pav2000/ControlHeatPump/Hardware/README.md

# ControlHeatPump
Файлы которые надо заменить в стандартном SDK Due (смотрите путь к файлам начиная с hardware)<br>
Библиотека DUE SAM: https://github.com/arduino/ArduinoCore-sam
