pav2000/ControlHeatPump/WiFiSensor/data/README.md

# WiFi Sensor
Веб морда датчика. Необходимо загрузить на флеш диск через среду IDE
