pav2000/ControlHeatPump/WiFiSensor/Screen/README.md

# WiFi Sensor
Картинки показывающие работу и вариант сборки сенсора.
