pav2000/ControlHeatPump/Schemes/Control  ПЭ3.pdf

Изм. | Спра | № докум. | Подп. | Дата
| | Разраб. | Куцко | | Контроллер ТН Перечень элементов | Лит. | Лист | Листов
Пров. | Куцко | | | | | | 1 | 5

Н.контр.
Утв.
Копировал | Формат А4

Инв. № подл. Подп. и дата Взам. инв. № Инв. № дубл. Подп. и дата Справ. № Перв. примен. 0000.00.00.000

Поз.
обозначение
Наименование | Кол. | Примечание
BA1 | Спикер Beep Small 9x5.5mm 3V | 1
| Конденсаторы
C1,C2 | CASE-D-25V-220 мкФ±10% | 2
C3 | 0805-X7R-50V-0,1 мкФ±10% | 1
C4 | 0805-X7R-50V-0,01 мкФ±10% | 1
C5 | CASE-D-25V-220 мкФ±10% | 1
C6...C11 | 0805-X7R-50V-0,01 мкФ±10% | 6
C12...C16 | CASE-D-25V-220 мкФ±10% | 5
C17 | 0805-X7R-16V-1 мкФ±10% | 1
C18 | CASE-D-25V-220 мкФ±10% | 1
C19 | 0805-X7R-50V-0,1 мкФ±10% | 1
C20 | CASE-D-25V-220 мкФ±10% | 1
C21 | 0805-X7R-50V-0,1 мкФ±10% | 1
C22 | 0805-X7R-10V-10 мкФ±10% | 1
C23,C24 | CASE-D-25V-220 мкФ±10% | 2
C25 | 0805-X7R-50V-0,1 мкФ±10% | 1
C26 | 0805-X7R-10V-10 мкФ±10% | 1
C27,C28 | 0805-X7R-16V-1 мкФ±10% | 2
C29 | 0805-X7R-50V-0,01 мкФ±10% | 1
C30 | 0805-X7R-50V-0,1 мкФ±10% | 1
C31 | 0805-X7R-50V-0,01 мкФ±10% | 1
C32 | 0805-X7R-16V-1 мкФ±10% | 1
C33...C35 | 0805-X7R-50V-0,01 мкФ±10% | 3
C36 | 0805-X7R-50V-0,1 мкФ±10% | 1
C37,C38 | 0805-X7R-50V-0,01 мкФ±10% | 2
C39 | 0805-X7R-50V-0,1 мкФ±10% | 1
C40 | 0805-X7R-50V-0,01 мкФ±10% | 1
| | | 0000.00.00.000 ПЭ3

Изм. | Лист | № докум. | Подп. | Дата

Инв

C41,C42 | 0805-X7R-50V-0,1 мкФ±10% | 2
C43 | 0805-X7R-50V-0,01 мкФ±10% | 1
C44 | 0805-X7R-50V-0,1 мкФ±10% | 1
C45...C47 | 0805-X7R-50V-0,01 мкФ±10% | 3
| Микросхемы
DA1 | Импульсный преобразователь LM2576SX-5.0 | 1
DA2 | Преобразователь P6CU-1205ELF (B1205LS) | 1
DA3...DA8 | PC817I | 6
DA9 | Преобразователь P6CU-1205ELF (B1205LS) | 1
DA10 | Преобразователь LM1117-3.3 | 1
DA11 | LM358AM | 1
DA12...DA14 PC817I | | 3
DA15,DA16 | LM358AM | 2
DA17 | DS3231MZ+ | 1
DA18,DA19 | ULN2003AD | 2
DD1 | W25Q32FVSSIG | 1
DD2 | MAX485AD | 1
DD3 | FM24C04-S | 1
L1,L2 | Дроссель SP1210-123K | 2
L3 | Дроссель MSS1210-104KEB | 1
| | | 2 . № подл. Подп. и дата Взам. инв. № Инв. № дубл. Подп. и дата
| Резисторы
R1...R12 | 0805-0,125W-1 кОм±1% | 12
R13...R20 | 0805-0,125W-4,75 кОм±1% | 8
R21 | 0805-0,125W-10 кОм±1% | 1
R22 | 0805-0,125W-9,09 кОм±1% | 1
R23 | 0805-0,125W-22,1 кОм±1% | 1
R24 | 0805-0,125W-9,09 кОм±1% | 1
R25 | 0805-0,125W-10 кОм±1% | 1
R26 | 0805-0,125W-1 кОм±1% | 1
| | | 0000.00.00.000 ПЭ3 | Лист

R27 | 0805-0,125W-22,1 кОм±1% | 1
R28 | 0805-0,125W-10 кОм±1% | 1
R29...R32 | 0805-0,125W-4,75 кОм±1% | 4
R33 | EVM3ESX50B13 | 1
R34 | 0805-0,125W-9,09 кОм±1% | 1
R35 | 0805-0,125W-1 кОм±1% | 1
R36 | 0805-0,125W-22,1 кОм±1% | 1
R37 | 0805-0,125W-121 Ом±1% | 1
R38 | 0805-0,125W-9,09 кОм±1% | 1
R39 | 0805-0,125W-10 кОм±1% | 1
R40 | EVM3ESX50B13 | 1
R41 | 0805-0,125W-1 кОм±1% | 1
R42 | 0805-0,125W-22,1 кОм±1% | 1
R43 | EVM3ESX50B13 | 1
R44 | 0805-0,125W-22,1 кОм±1% | 1
R45 | 0805-0,125W-1 кОм±1% | 1
R46 | 0805-0,125W-9,09 кОм±1% | 1
R47 | EVM3ESX50B13 | 1
R48 | 0805-0,125W-1 кОм±1% | 1
R49 | 0805-0,125W-9,09 кОм±1% | 1
R50 | 0805-0,125W-10 кОм±1% | 1
R51 | 0805-0,125W-22,1 кОм±1% | 1
R52...R54 | 0805-0,125W-10 кОм±1% | 3 | 3 . № подл. Подп. и дата Взам. инв. № Инв. № дубл. Подп. и дата
R55...R58 | 0805-0,125W-121 Ом±1% | 4
R59 | 0805-0,125W-0 Ом±1% | 1
R60 | 0805-0,125W-10 кОм±1% | 1
R61,R62 | 0805-0,125W-0 Ом±1% | 2
R63 | 0805-0,125W-2,21 кОм±1% | 1
R64 | 0805-0,125W-100 Ом±1% | 1
R65...R67 | 0805-0,125W-0 Ом±1% | 3
R68 | 0805-0,125W-100 Ом±1% | 1

SB1,SB2 | Кнопка PTS645SM43SMTR | 2
| Диоды
VD1 | SSA33L | 1
VD2...VD15 | SS12 | 14
VD16,VD17 | Светодиод 0805 | 2
VD18...VD29 | SS12 | 12
X1,X2 | Клемник KLS2-308V-2.54-02P-2C | 2
X3...X8 | Клемник KLS2-308V-2.54-03P-2C | 6
X9 | Клемник KLS2-301-500-02P-2C | 1
X10...X16 | Клемник KLS2-308V-2.54-02P-2C | 7
X17 | Клемник KLS2-308V-2.54-03P-2C | 1
X18 | Клемник KLS2-308V-2.54-02P-2C | 1
X19 | Держатель карты памяти MicroSD | 1
X20 | Клемник KLS2-308V-2.54-02P-2C | 1
X21...X23 | Клемник KLS2-308V-2.54-03P-2C | 3
X24 | Клемник KLS2-308V-2.54-02P-2C | 1
X25 | Клемник KLS2-308V-2.54-03P-2C | 1
X26 | Держатель батарейки S8401-46 | 1
X27 | Клемник KLS2-308V-2.54-02P-2C | 1
X28 | Клемник KLS2-308V-2.54-03P-2C | 1
X29 | Клемник KLS2-308V-2.54-02P-2C | 1 | 4 . № подл. Подп. и дата Взам. инв. № Инв. № дубл. Подп. и дата
X30...X36 | Клемник KLS2-308V-2.54-03P-2C | 7
X37 | Клемник KLS2-308V-2.54-02P-2C | 1
X38,X39 | Клемник KLS2-308V-2.54-03P-2C | 2
X40,X41 | Клемник KLS2-308V-2.54-02P-2C | 2
X42,X43 | Клемник KLS2-308V-2.54-03P-2C | 2
X44...X51 | Клемник KLS2-308V-2.54-02P-2C | 8
XP1 | Соединитель штыревой PLS-10 | 1
XP2...XP4 | Соединитель штыревой PLS-08 | 3

5 . № подл. Подп. и дата Взам. инв. № Инв. № дубл. Подп. и дата

XP5 | Соединитель штыревой PLS-04 | 1
XP6 | Соединитель штыревой PLS-08 | 1
XP7 | Соединитель штыревой PLS-04 | 1
XP8 | Соединитель штыревой PLS-08 | 1
XP9 | Соединитель штыревой PLS-04 | 1
XP10 | Соединитель штыревой PLD-36 | 1
XP11 | Соединитель штыревой PLS-11 | 1
XS1 | Штыревой разъем KLS1-208-2-06-S | 1
XS2 | Штыревой разъем 2.54 6pin x 2 | 1
