pav2000/ControlHeatPump/Schemes/Control_2.1_Board (Подписаны выводы).pdf

RS485_A
RS485_B

Vout6 (0-10V)
Vout6 (GND)

Vout5 (0-10V)
Vout5 (GND)

Vout4 (0-10V)
Vout4 (GND)

Vout3 (0-10V)
Vout3 (GND)

# TMP1 (+3.3V) TMP1 (DQ) TMP1 (GND)

# TMP2 (+3.3V) TMP2 (DQ) TMP2 (GND)

# TMP3 (+3.3V) TMP3 (DQ) TMP3 (GND)

# TMP4 (+3.3V) TMP4 (DQ) TMP4 (GND)

# TMP5 (+3.3V) TMP5 (DQ) TMP5 (GND)

# TMP6 (+3.3V) TMP6 (DQ) TMP6 (GND)

E

E

V1.1
E

E

V1.1
E

E

V1.1

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
+12V)
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
V1.3
E

E

V1.3

(

+12V)

E

E

V2.1
E

E

V2.1
E

E

V2.1
E

E

V2.3
E

E

V2.3
E

E

V2.2
E

E

V2.2

(

+12V)
E

E

V2.2

(

G

ND)

E

E

V2.4

(

+12V)
E

E

V2.4

LED LED LED
(

+3.3V)
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
S (R

E

SET)
B

U

T

T

O

N

S (POW

ER)

R

ELA

Y

(

+5V)
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
Y (O

U

T1)
R

ELA

Y (O

U

T2)
R

ELA

Y (O

U

T3)
R

ELA

Y (O

U

T4)
R

ELA

Y (O

U

T5)
R

ELA

Y (O

U

T6)
R

ELA

Y (O

U

T7)
R

ELA

Y (O

U

T8)
R

ELA

Y

(

+5V)

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
7 (O

U

T7)
R

ELA

Y

7

(

+5V)
R

ELA

Y

8 (O

U

T8)
R

ELA

Y

8

(

+5V)

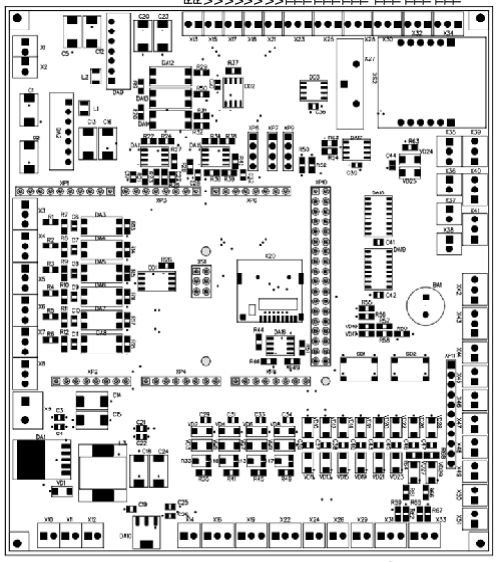
[picture p7: figure]

# PEVA (GND) PEVA (+5V, +12V) PEVA

# PCON (GND) PCON (+5V, +12V) PCON

## Vout2 (GND) Vout2 (0-10V)

## Vout1 (GND) Vout1 (0-10V)

GND

Analog_IN11

# Analog_IN10 Analog_IN7 Analog_IN6

Analog_IN5 Analog_IN4 Analog_IN3

Analog_IN2 Analog_IN1 Analog_IN0

+5V

+5V

GND

GND
GND

GND

+12V

+12V

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
S6 (In)
S6 (5VD)
S6 (0VD)

S5 (In)
S5 (5VD)
S5 (0VD)

S4 (In)
S4 (5VD)
S4 (0VD)

S3 (In)
S3 (5VD)
S3 (0VD)

S2 (In)
S2 (5VD)
S2 (0VD)

S1 (In)
S1 (5VD)
S1 (0VD)

R

ELA

Y10

(

+5V)
R

ELA

Y10 (OUT10)

R

ELA

Y

9

(

+5V)
R

ELA

Y

9 (O

U

T9)
