pav2000/ControlHeatPump/Nextion/README.md

# Nextion
В этой директории лежит все что касается дисплея Nextion. Это не обязательное оборудование!<br>
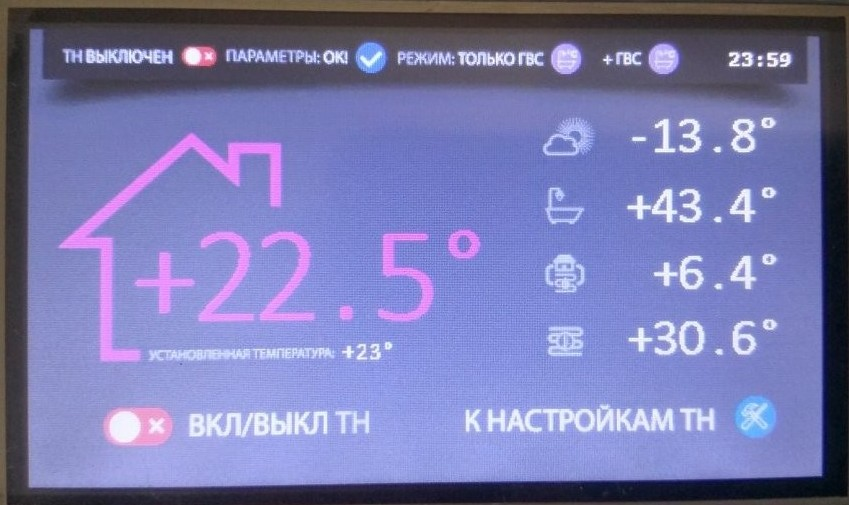
[picture p8: Nextion/Screen/00.jpg]
<br>
Автор данного устройства Sheeny.

Дисплей Nextion используется модель NX4827T043 (https://www.itead.cc/wiki/Product) с
диагональю 4.3 дюйма вот этот : https://www.itead.cc/wiki/NX4827T043 <br>
ОБЯЗАТЕЛЬНО префикс модели NX, с китайским вариантом будут проблемы с редактором.<br>
Цепляется к первому (Serial1) аппаратному порту uart DUE. (ноги D18 D19) (перекрестное соединение
TX-RX). Не смотря на 5 вольтовое питание выходные сигналы с дисплея имеют уровень 3.3 вольта и не
требуют согласования уровней.<br>

Прошивку можно залить через редактор: https://nextion.itead.cc/resources/download/nextion-editor/<br>
или с помощью micro-SD карты: файл nextion.tft нужно переписать на флешку (отформатирована в fat32),
вставить ее в разъем SD на дисплее, включить питание дисплея. Процесс обновления будет отображаться
на дисплее.

Дисплей можно присоеденить по радиоканалу см. файл Nextion+HC-12.pdf.

Файл nextion_800x480.zip - адаптация прошивки для 7 дюймового дисплей Nextion

Проекты делаются в версии Nextion Editor 0.53 не выше, в связи с высокой глючностью
последних версий редакторов.
