pav2000/ControlHeatPump/Web/README.md

# ControlHeatPump
Веб морда для контроллера, необходимо из директории "Main" все файлы записать в корень SD карты или загрузить в SPI Flash (при включенной соответствующей опции в настройках).<br>

Директории:
Main -  основная веб. морда контроллера (может сохраняться на карте и на флеш диске)
mob - вариант мобильной (для телефонов) веб. морды, устаршая версия (частичная работа)
Variant - Варианты замены отдельных файлов основной веб. морды (замена по желанию)

Настройка веб. морды
Необходимо проверить в файле scripts.js - должна быть раскоментирована строка:<br>
var urlcontrol = ''; //  автоопределение (если адрес сервера совпадает с адресом контроллера) <br>
Это вариант если морда лежит на SD карте (ОСНОВНОЙ). <br>
Если морда лежит в другом месте то urlcontrol должно указывать на адрес веб морды.<br>><br>
