pav2000/ControlHeatPump/Control/README.md

# ControlHeatPump
Контроллер  теплового насоса
