pav2000/ControlHeatPump/Web/Variant/README.md

Варианты изменений веб морды (по желанию пользователя).
Для внесений изменений надо заменить файлы в рабочей директории из этой папки.

Изменения:
invertorset.html - страница для инвертора OmronMX2 замена размерностей с % на частоту
Omron MX2.pdf - кратное описание инвертора MX2, при использовании этого инвертора необходимо УДАЛИТЬ файл Vacon.pdf и скопировать этот файл.
sensorsp.html - обновление страницы раз в 5 сек. (в main 2 сек.), вывод дополнительно для SDM Реактивной мощности (VAr) и Полной мощности (VA)
stats.html history.html style.css - оформление пунктов меню "Статистика" в общем дизайне веб интерфейса (меню, цветовая гамма)
