pav2000/ControlHeatPump/Nextion/3D_model/README.md

# Nextion
Модели для печати корпуса дисплея Nextion на 3D принтере <br>
