pav2000/ControlHeatPump/Nextion/Screen/README.md

# Nextion
Картинки показывающие работу дисплея Nextion.
