pav2000/ControlHeatPump/Nextion/3D_model/Корпус.jpg

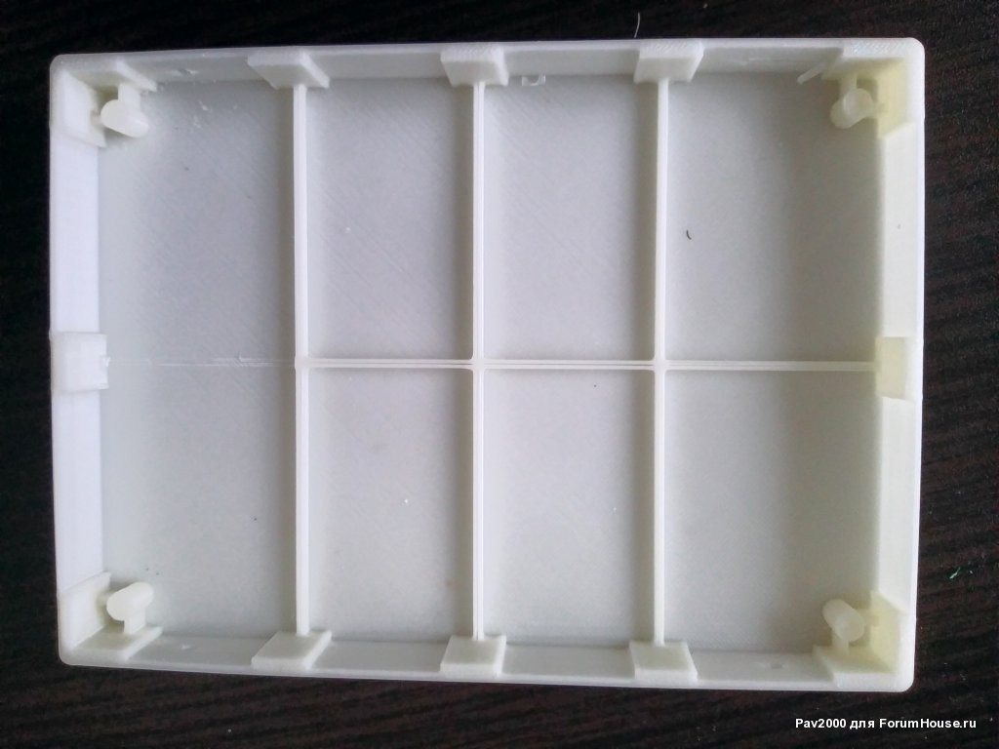
Nextion/3D_model/Корпус.jpg
