pav2000/ControlHeatPump/Nextion/3D_model/Крышка.jpg

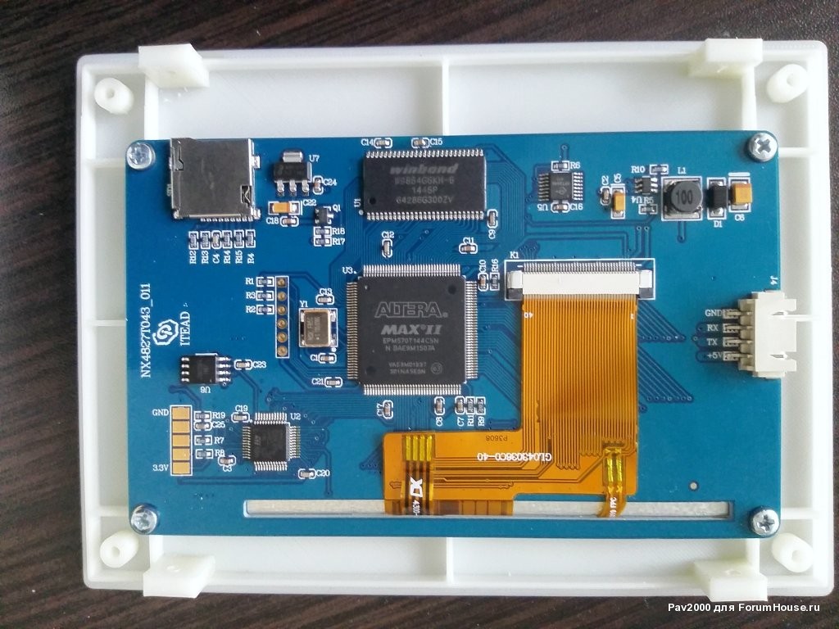
Nextion/3D_model/Крышка.jpg
