pav2000/ControlHeatPump/Nextion/3D_model/Сборка.jpg

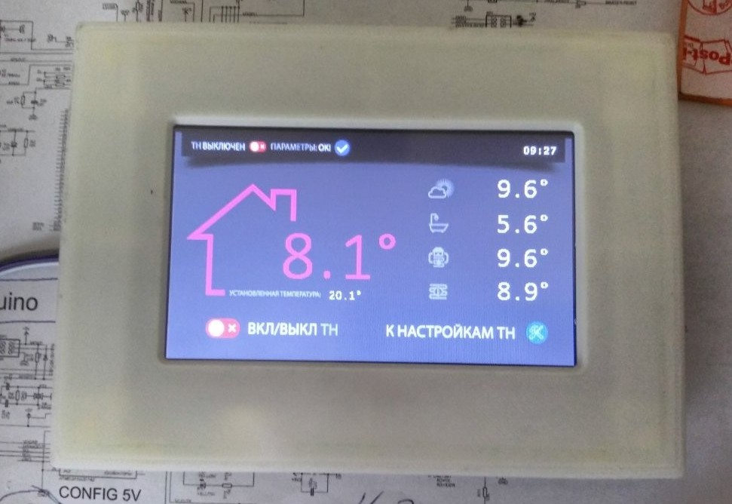
Nextion/3D_model/Сборка.jpg
