pav2000/ControlHeatPump/Nextion/Screen/01.jpg

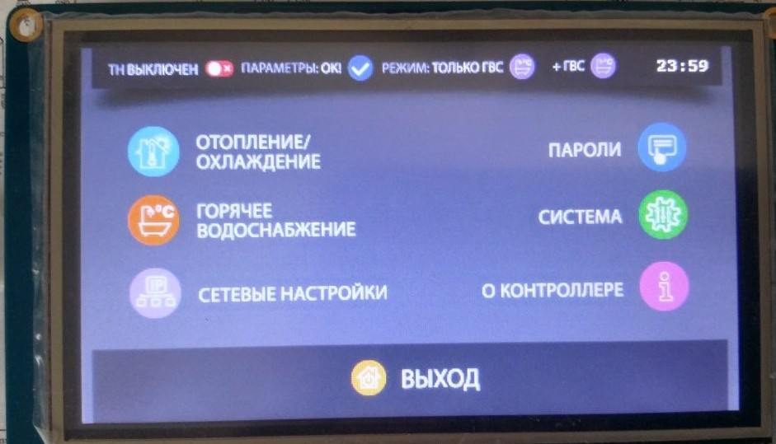
Nextion/Screen/01.jpg
