pav2000/ControlHeatPump/Nextion/Screen/02.jpg

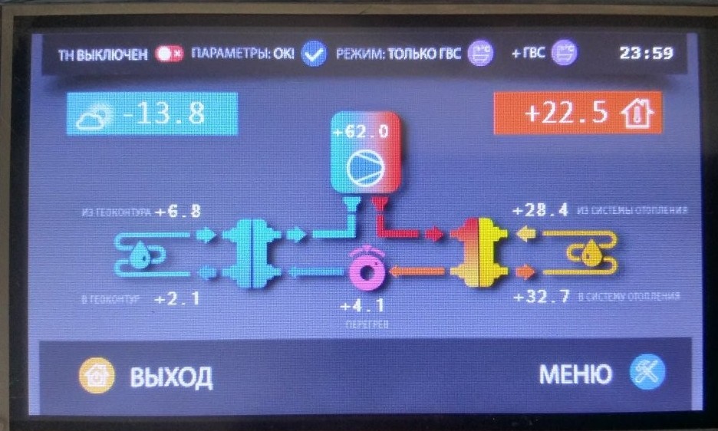
Nextion/Screen/02.jpg
