pav2000/ControlHeatPump/Nextion/Screen/03.jpg

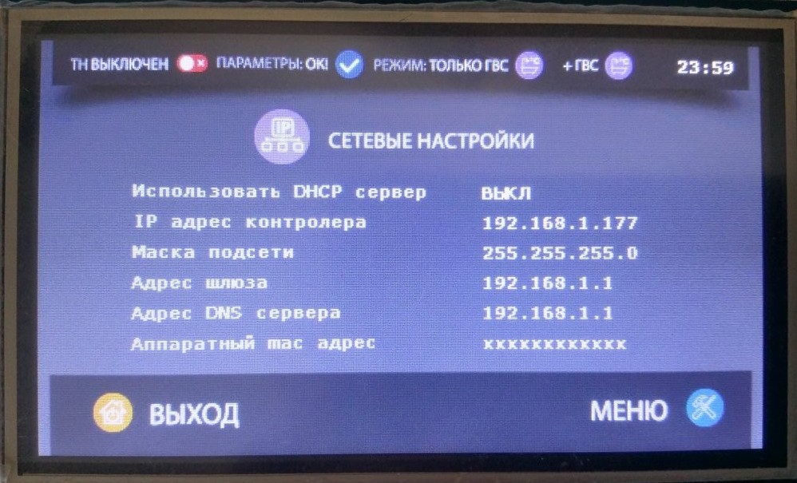
Nextion/Screen/03.jpg
