pav2000/ControlHeatPump/Nextion/Screen/04.jpg

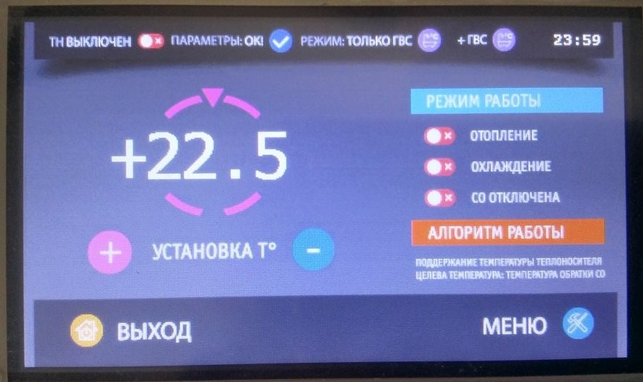
Nextion/Screen/04.jpg
