pav2000/ControlHeatPump/Nextion/Screen/05.jpg

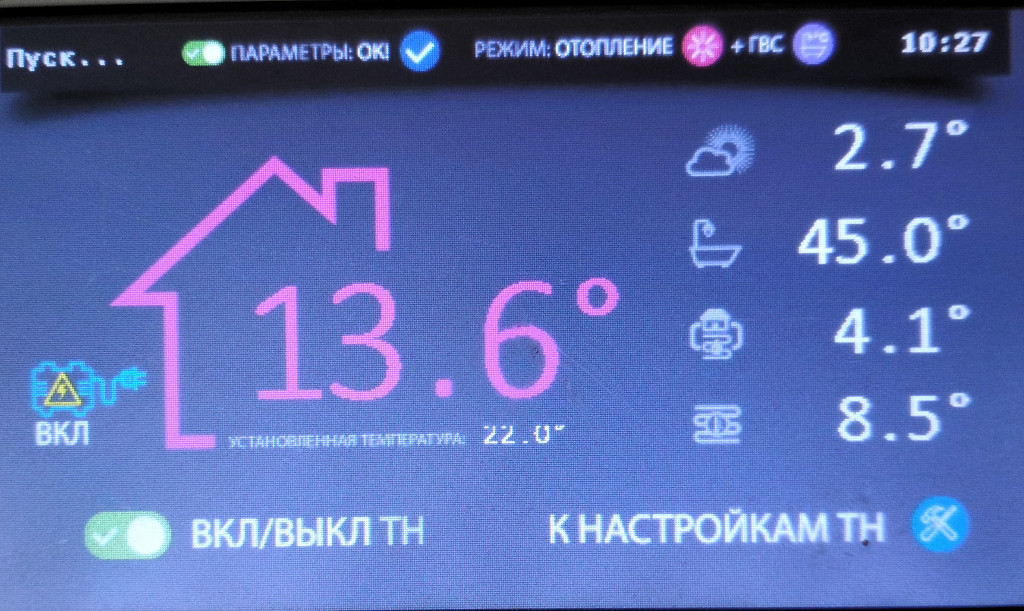
Nextion/Screen/05.jpg
