pav2000/ControlHeatPump/Schemes/Arduino DUE Core.png

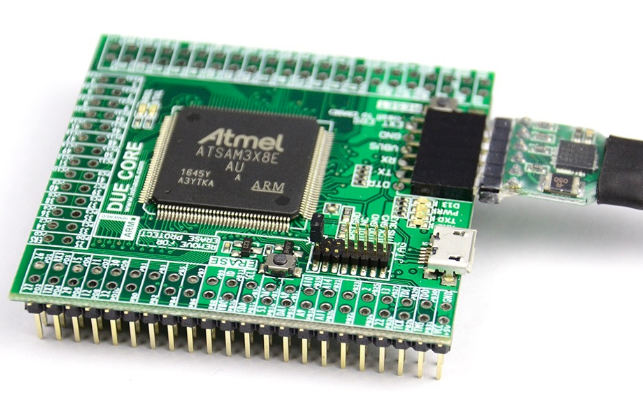
Schemes/Arduino DUE Core.png
