pav2000/ControlHeatPump/Schemes/Schematic_DUE-Core-Main-board_Main_v_1_0_top.jpg

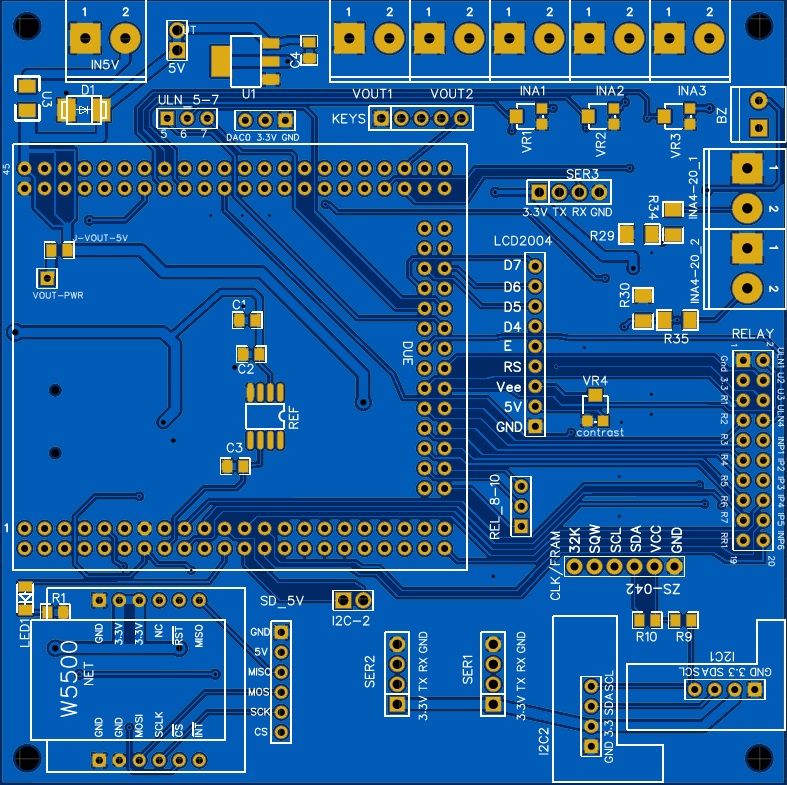
Schemes/Schematic_DUE-Core-Main-board_Main_v_1_0_top.jpg
