pav2000/ControlHeatPump/Schemes/Schematic_DUE-Core-Relay-board_Relay_v_1_0_top.jpg

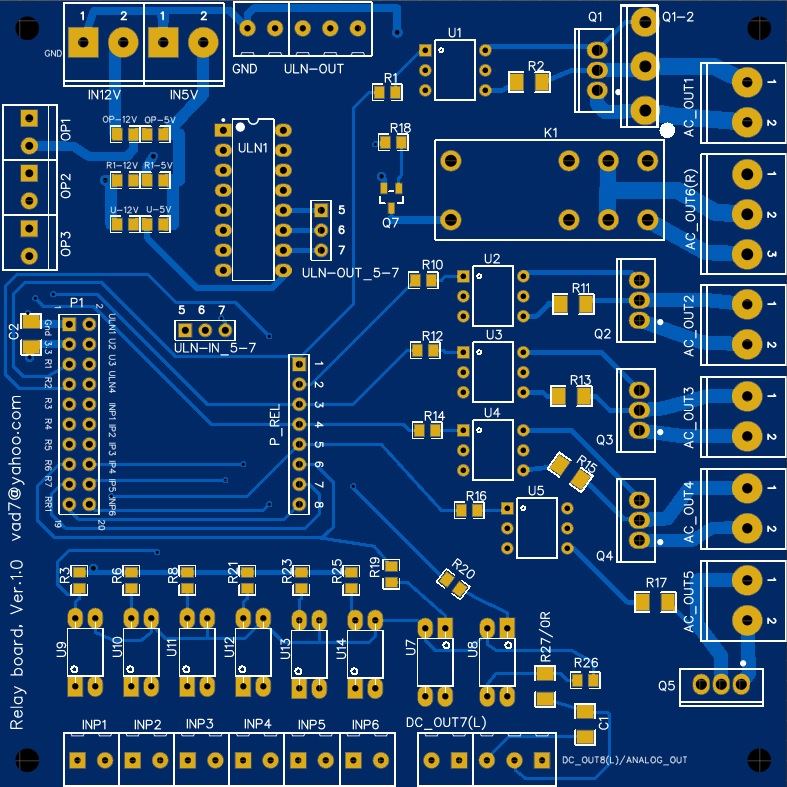
Schemes/Schematic_DUE-Core-Relay-board_Relay_v_1_0_top.jpg
