pav2000/ControlHeatPump/Schemes/UART - K-Line adapter.jpg

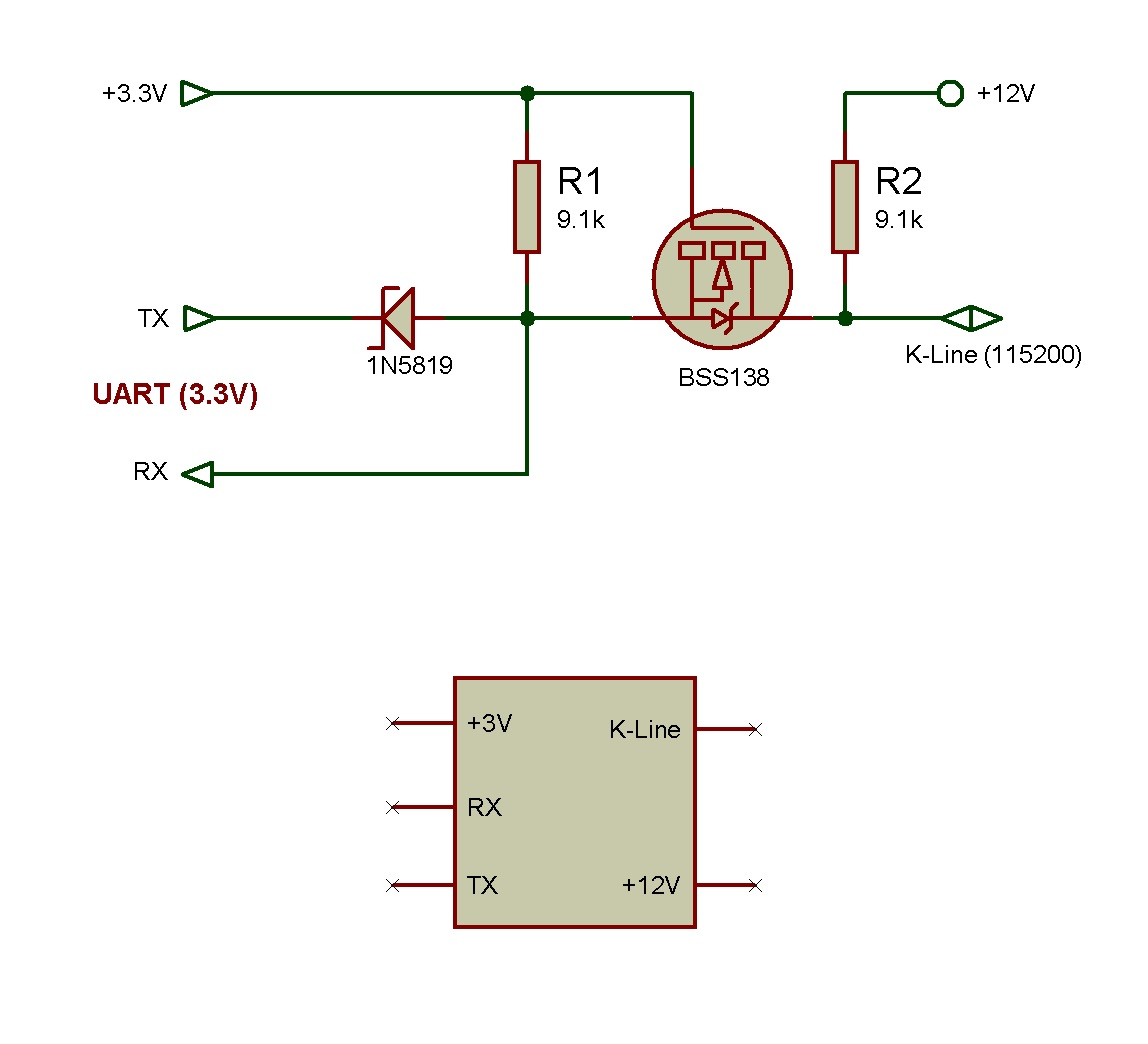
Schemes/UART - K-Line adapter.jpg
