pav2000/ControlHeatPump/Web/Main/plan1.png

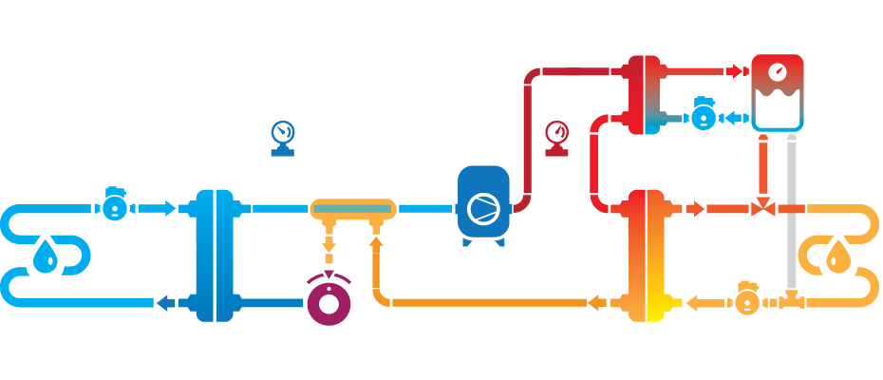
Web/Main/plan1.png
