pav2000/ControlHeatPump/Web/Main/plan2.png

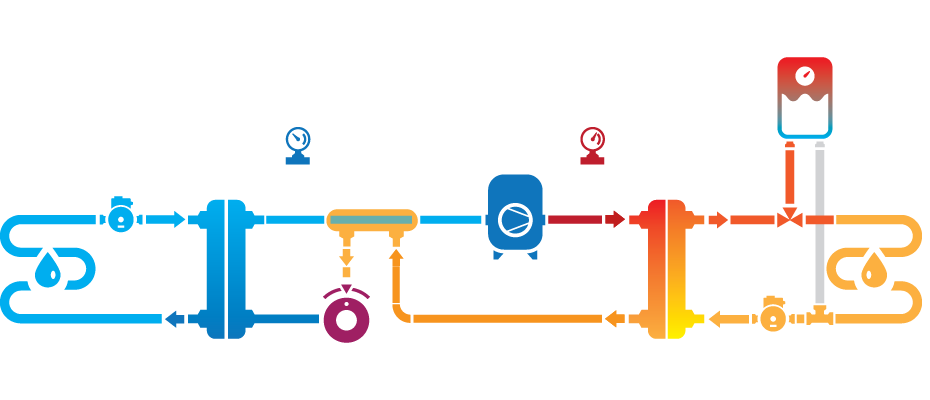
Web/Main/plan2.png
