pav2000/ControlHeatPump/Web/Main/plan3.png

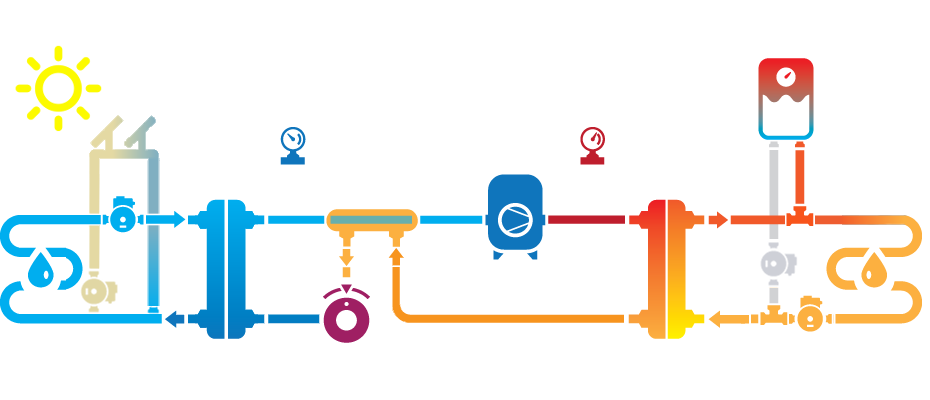
Web/Main/plan3.png
