pav2000/ControlHeatPump/Web/mob/shem1.png

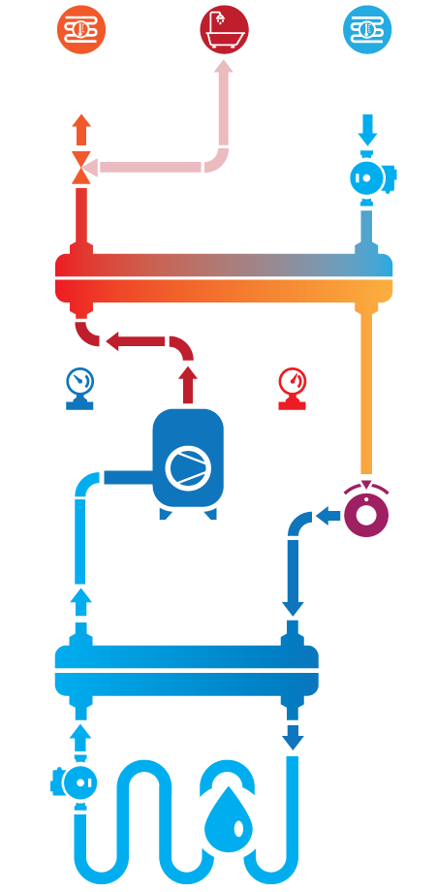
Web/mob/shem1.png
