pav2000/ControlHeatPump/WiFiSensor/Screen/02.jpg

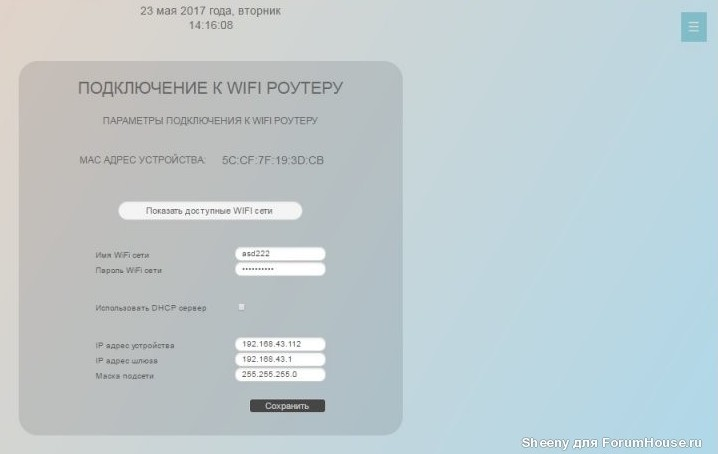
WiFiSensor/Screen/02.jpg
