pav2000/ControlHeatPump/WiFiSensor/Screen/03.jpg

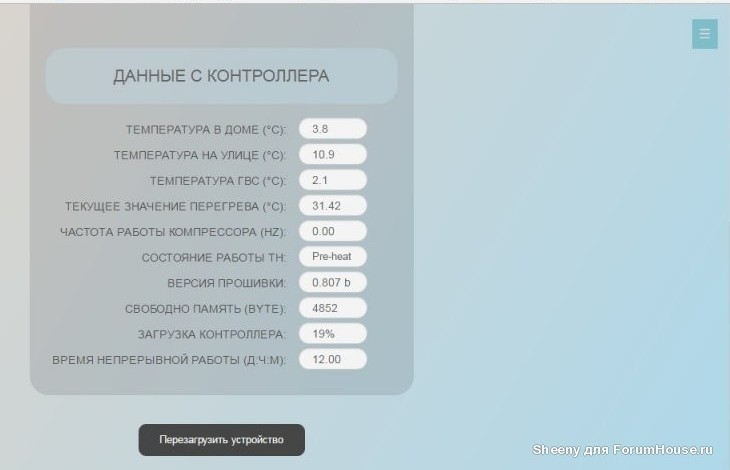
WiFiSensor/Screen/03.jpg
