pav2000/ControlHeatPump/WiFiSensor/Screen/04.jpg

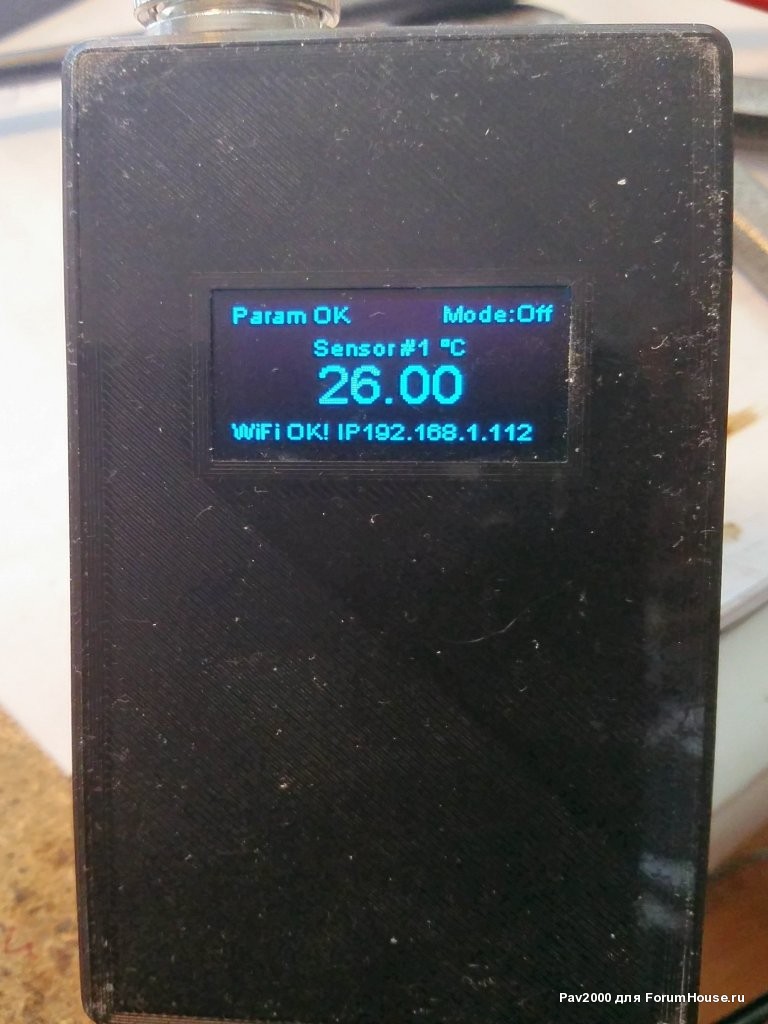
WiFiSensor/Screen/04.jpg
