pav2000/ControlHeatPump/WiFiSensor/Screen/05.jpg

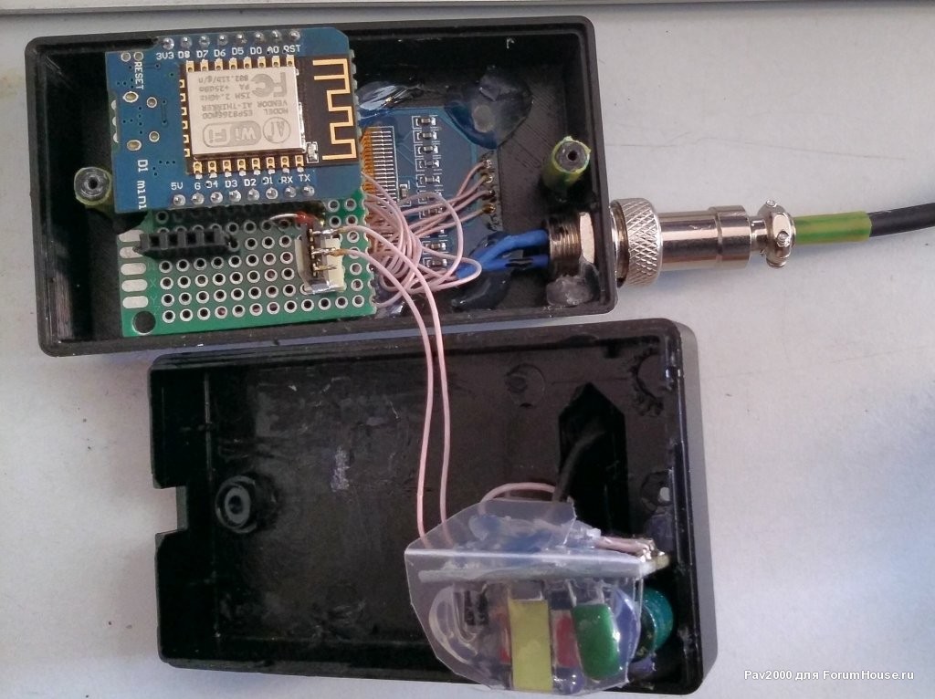
WiFiSensor/Screen/05.jpg
