pav2000/ControlHeatPump/Nextion/3D_model/4.3-Bezel.STL

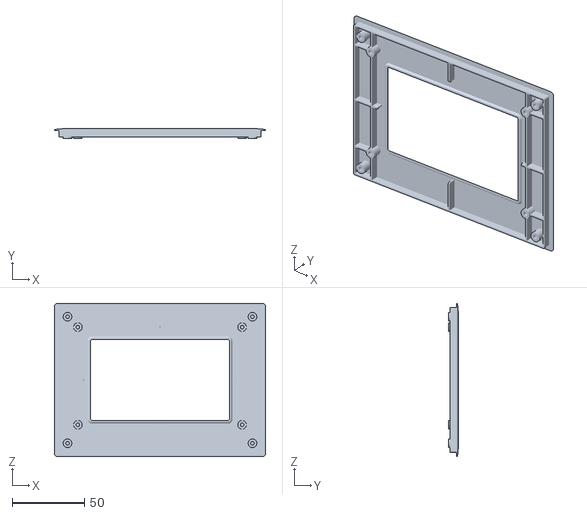
[picture p60: CAD file, 2018-07-26]
Nextion/3D_model/4.3-Bezel.STL
146.0 x 6.80 x 106.0
