pav2000/ControlHeatPump/Nextion/3D_model/Дно 4.3.stl

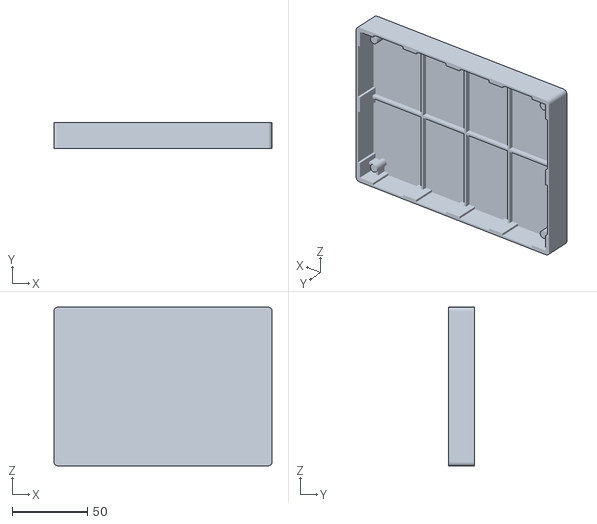
[picture p61: CAD file, 2018-07-26]
Nextion/3D_model/Дно 4.3.stl
145.0 x 17.0 x 105.5
