pav2000/ControlHeatPump/Nextion/3D_model/4.3-Display.STL

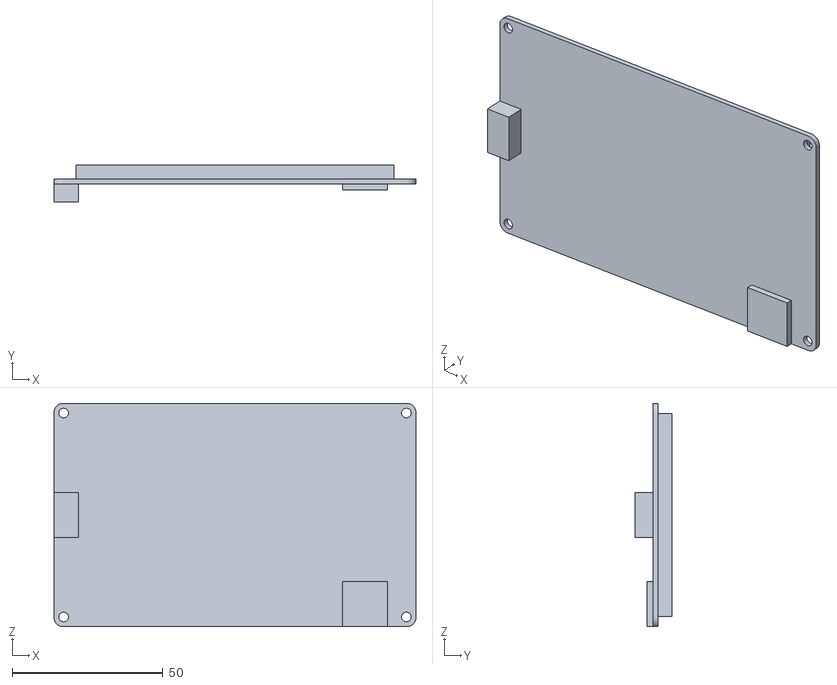
[picture p62: CAD file, 2018-07-26]
Nextion/3D_model/4.3-Display.STL
120.0 x 12.2 x 74.0
