pav2000/ControlHeatPump/Schemes/control_boad_fix_1.jpg

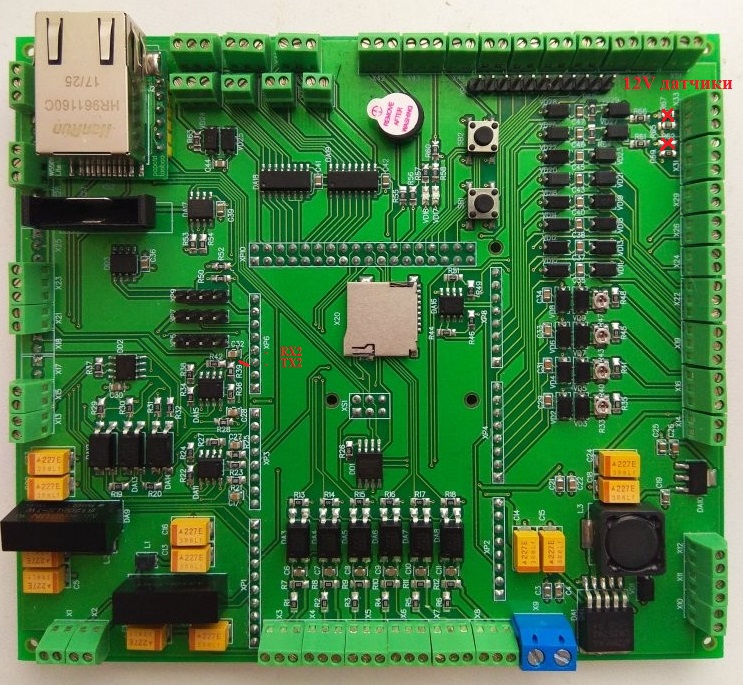
Schemes/control_boad_fix_1.jpg
