pav2000/ControlHeatPump/Schemes/control_boad_fix_2.jpg

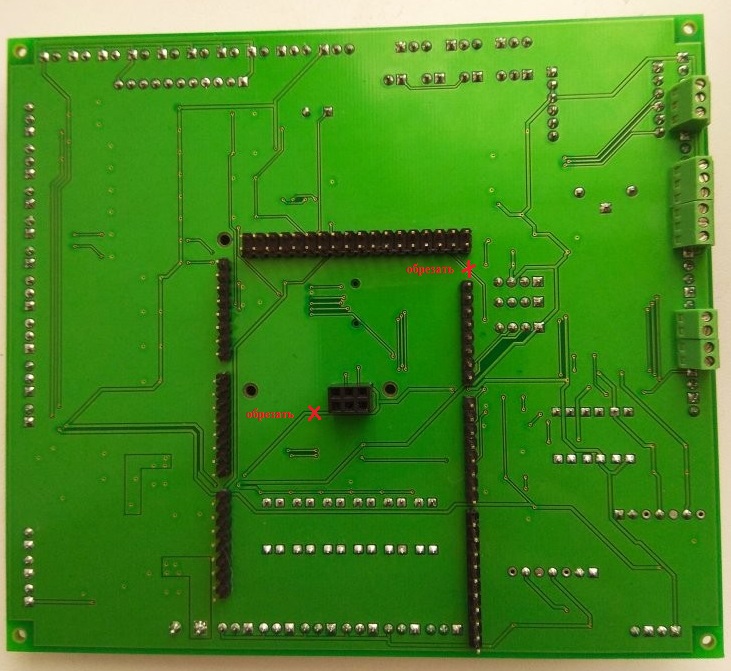
Schemes/control_boad_fix_2.jpg
