pav2000/ControlHeatPump/Schemes/Control_2.1_Board (СБ).pdf

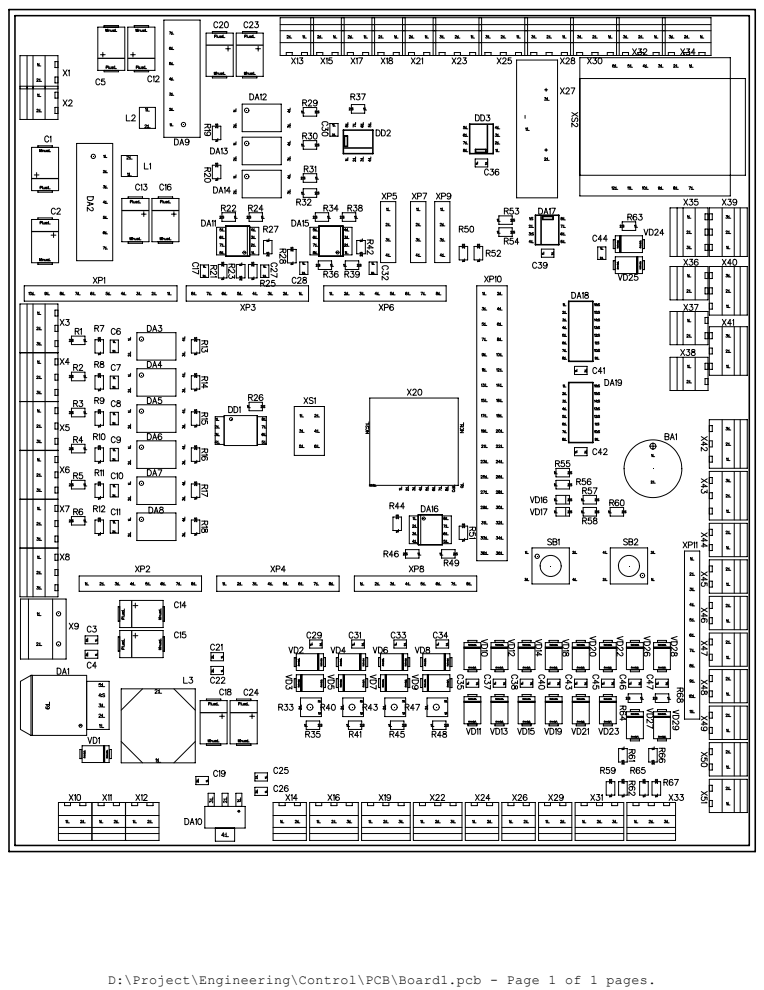
[picture p65: page 1]

D:\Project\Engineering\Control\PCB\Board1.pcb - Page 1 of 1 pages.
