pav2000/ControlHeatPump/Schemes/Schematic_DUE-Core-Main-board_Main_v_1_0.pdf

W5500

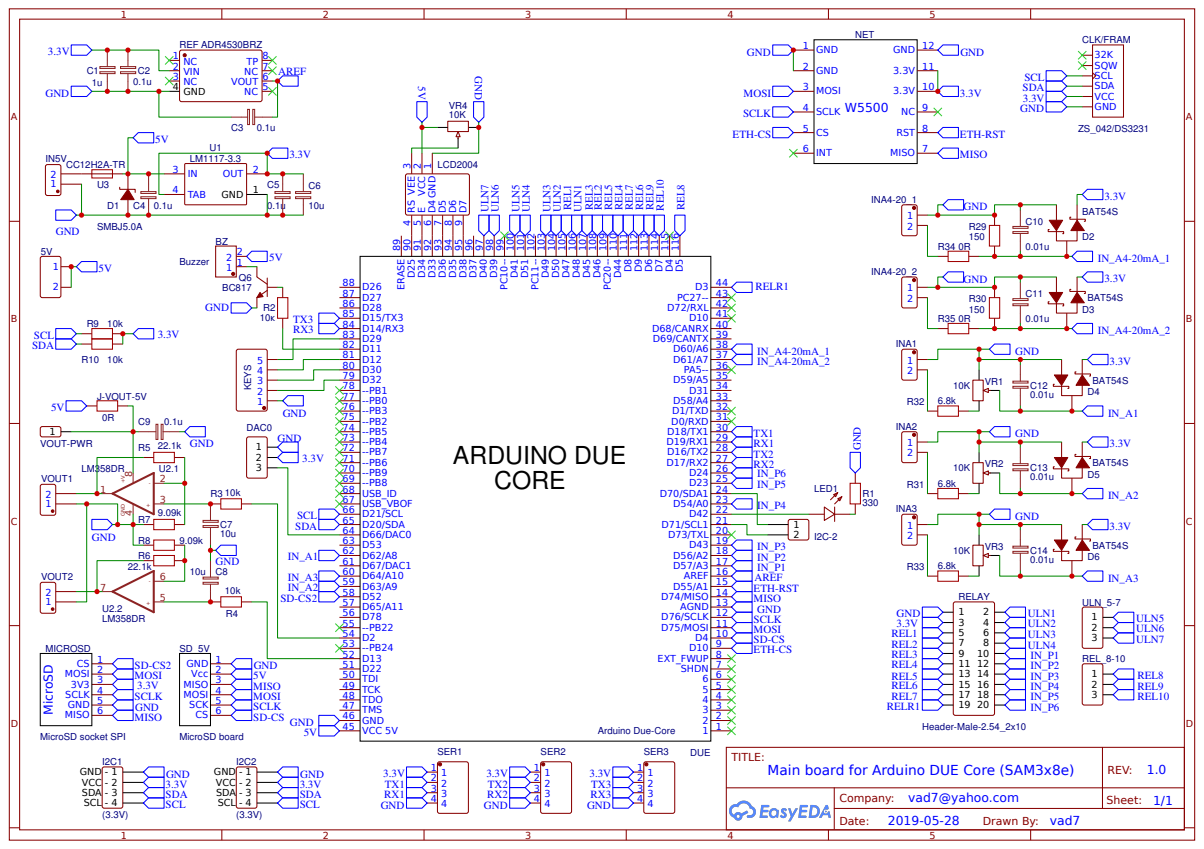
[picture p66: page 1]

ULN4
1 1 2 2 3 3 4 4 5 5 6 6 SHDN 7 EXT_FWUP 8 D10 9 D4 10 D75/MOSI 11 D76/SCLK 12 AGND 13 D74/MISO 14 D55/A1 15 AREF 16 D57/A3 17 D56/A2 18 D43 19 D73/TXL 20 D71/SCL1 21 D42 22 D54/A0 23 D70/SDA1 24 D23 25 D24 26 D17/RX2 27 D16/TX2 28 D19/RX1 29 D18/TX1 30 D0/RXD 31 D1/TXD 32 D58/A4 33 D31 34 D59/A5 35 PA5-- 36 D61/A7 37 D60/A6 38 D69/CANTX 39 D68/CANRX 40 D10 41 D72/RXL 42 PC27-- 43 D3 44
