pav2000/ControlHeatPump/Schemes/Schematic_DUE-Core-Relay-board_Relay_v_1_0.pdf

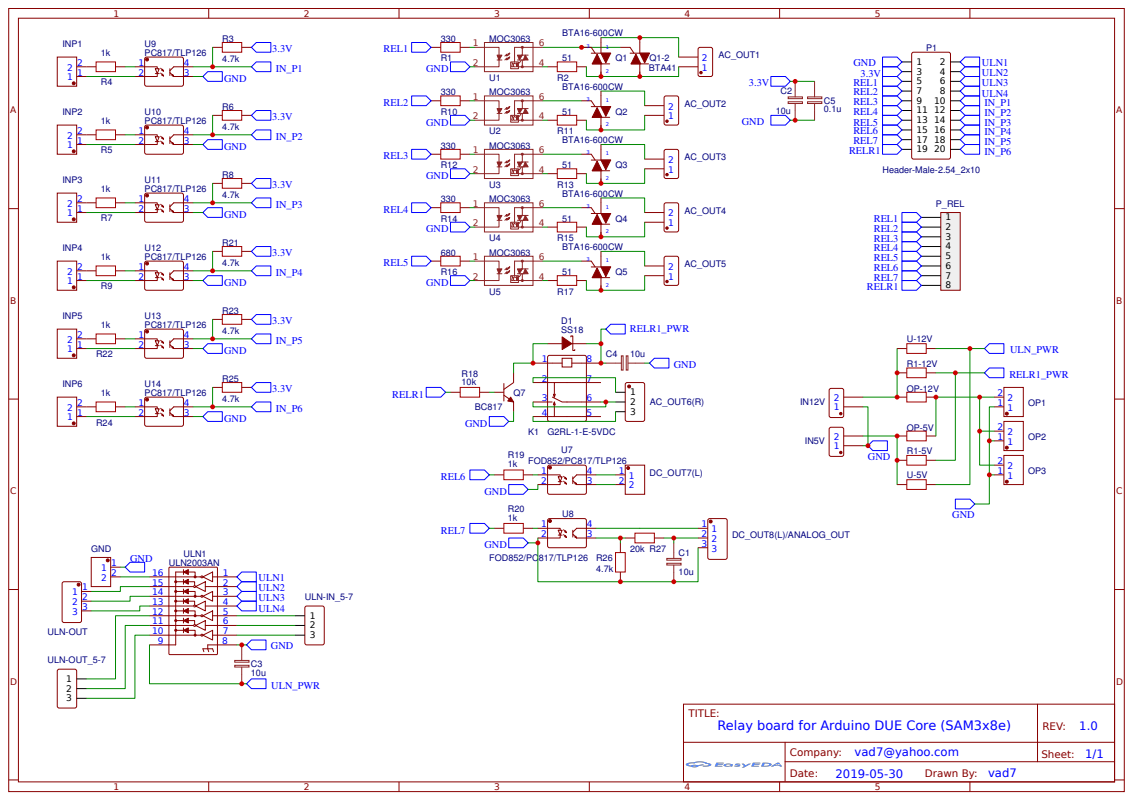
[picture p67: page 1]
