pav2000/ControlHeatPump/Schemes/Control.pdf

3Ý 000.00.00.0000

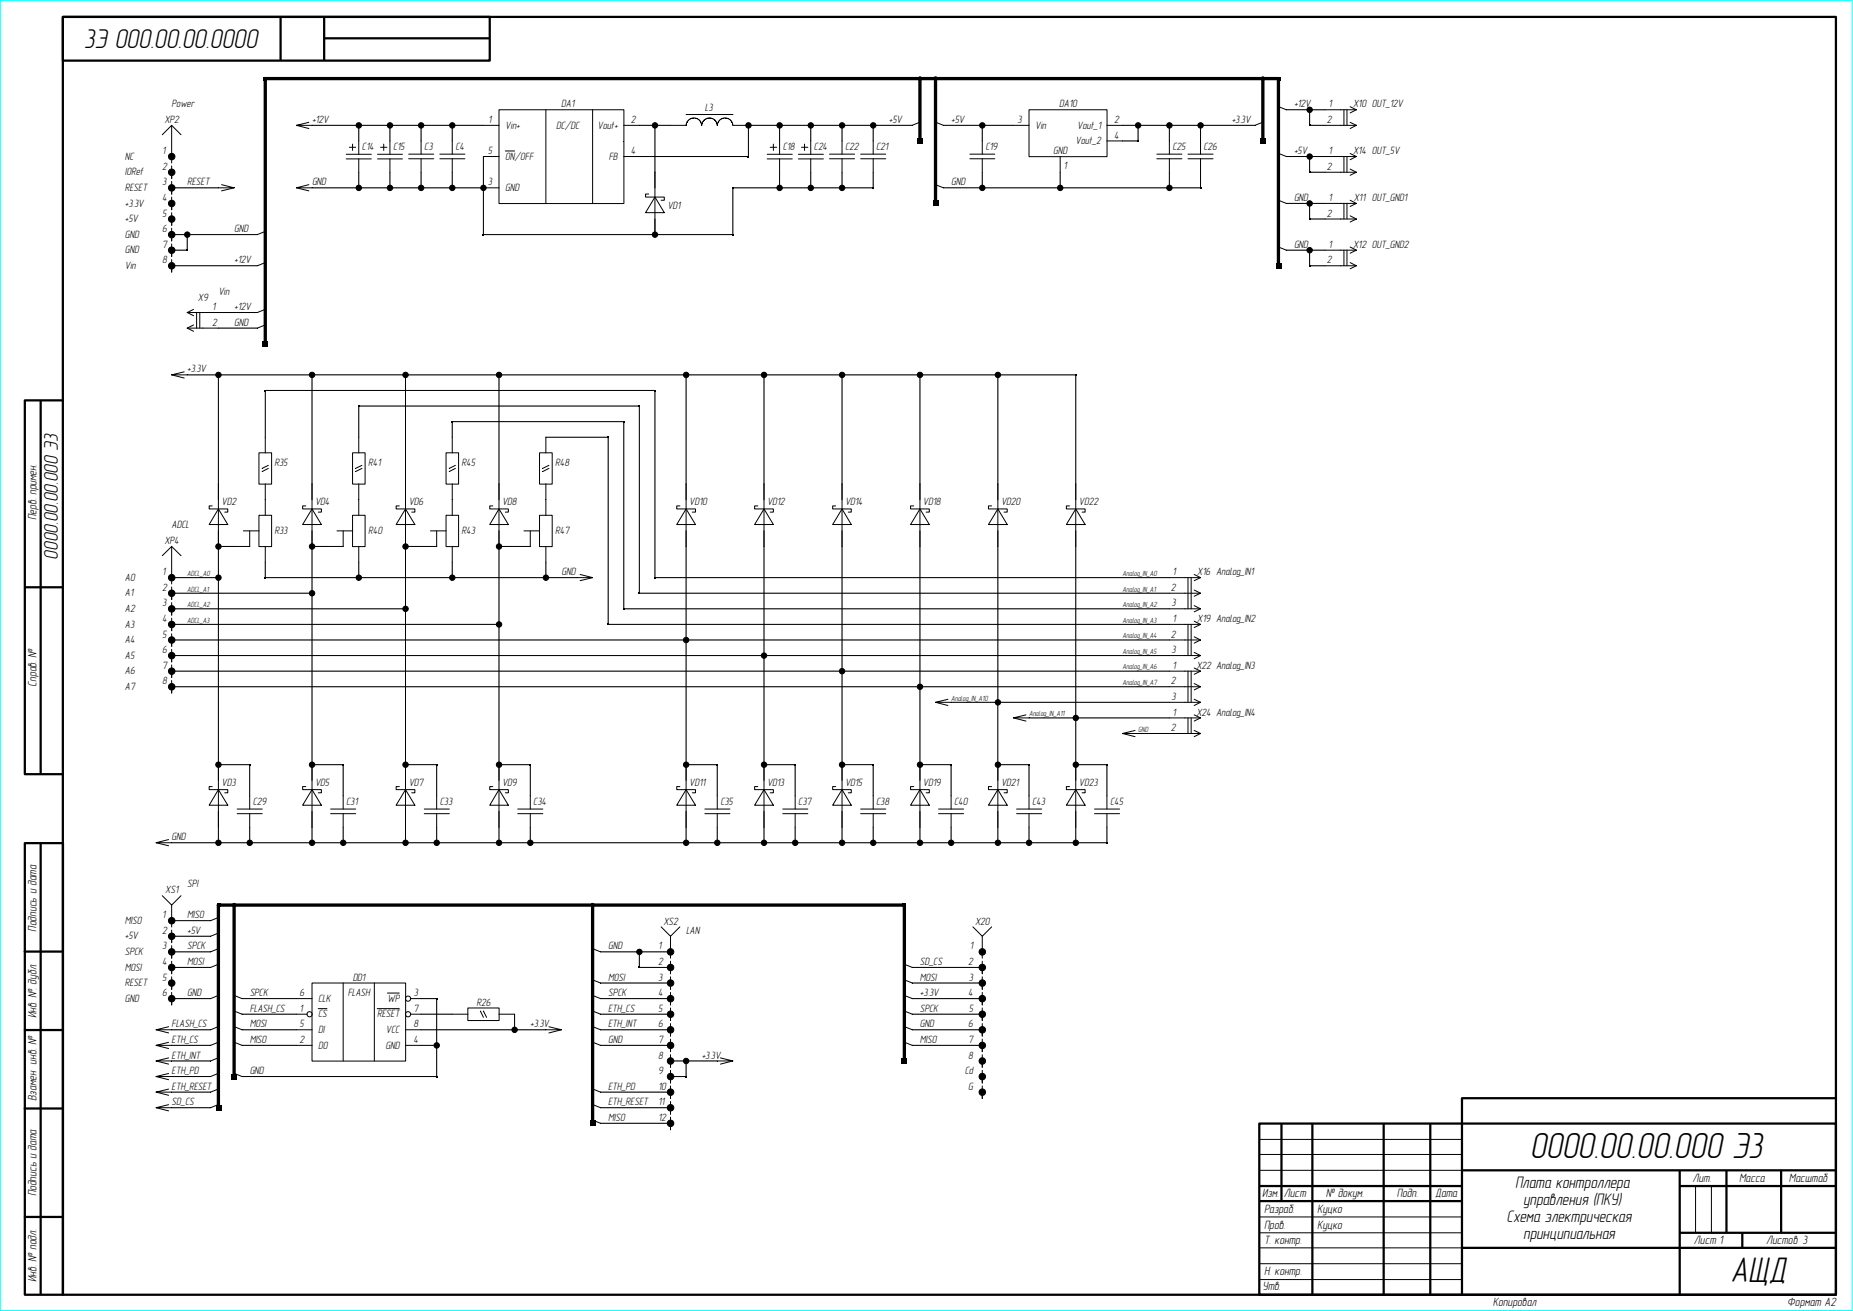
[picture p68: page 1]

2 Analog_IN_A1

3 Analog_IN_A2

2 Analog_IN_A4

3 Analog_IN_A5

2 Analog_IN_A7

Analog_IN_A10 | 3

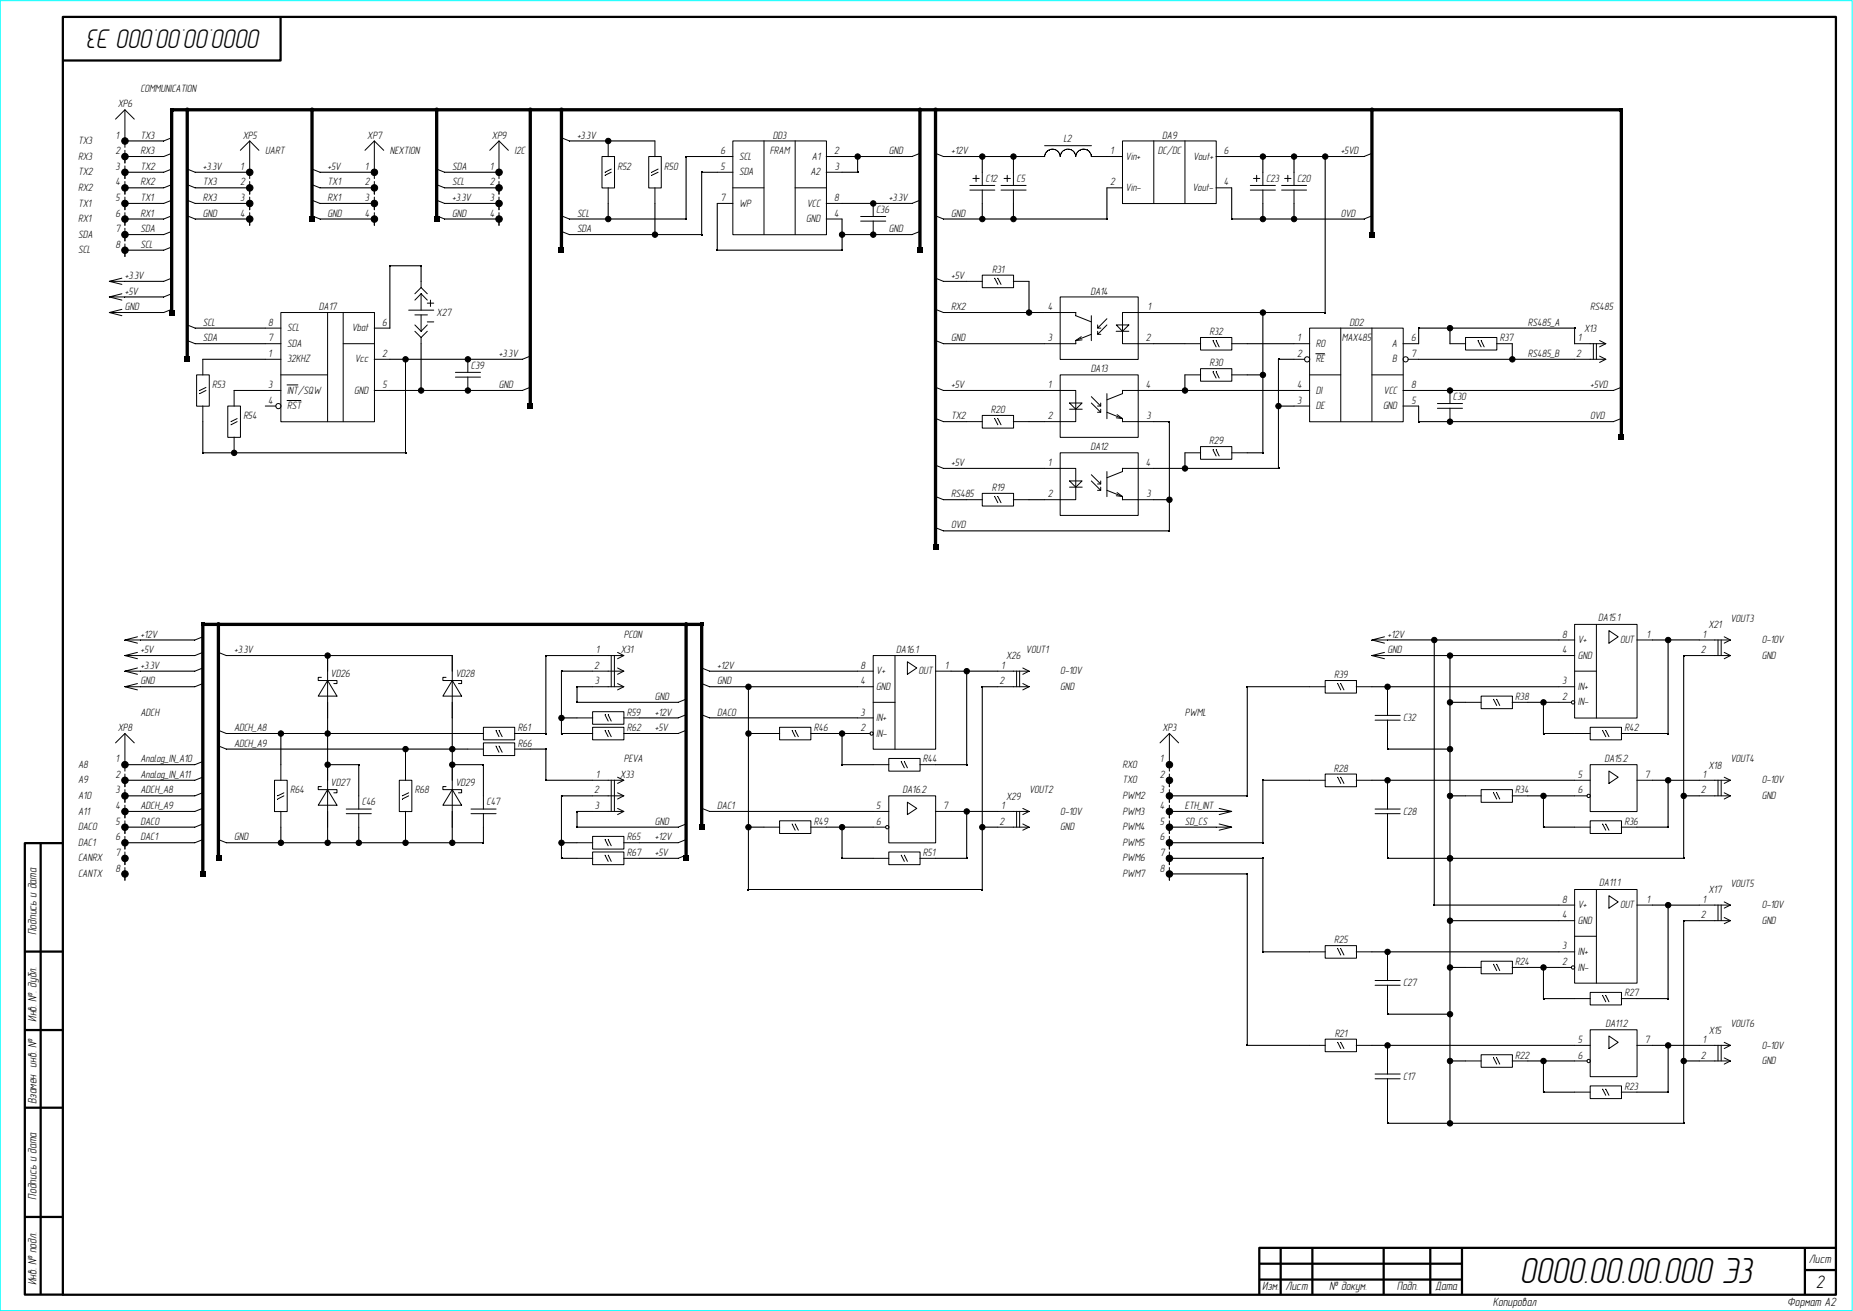
[picture p69: page 2]

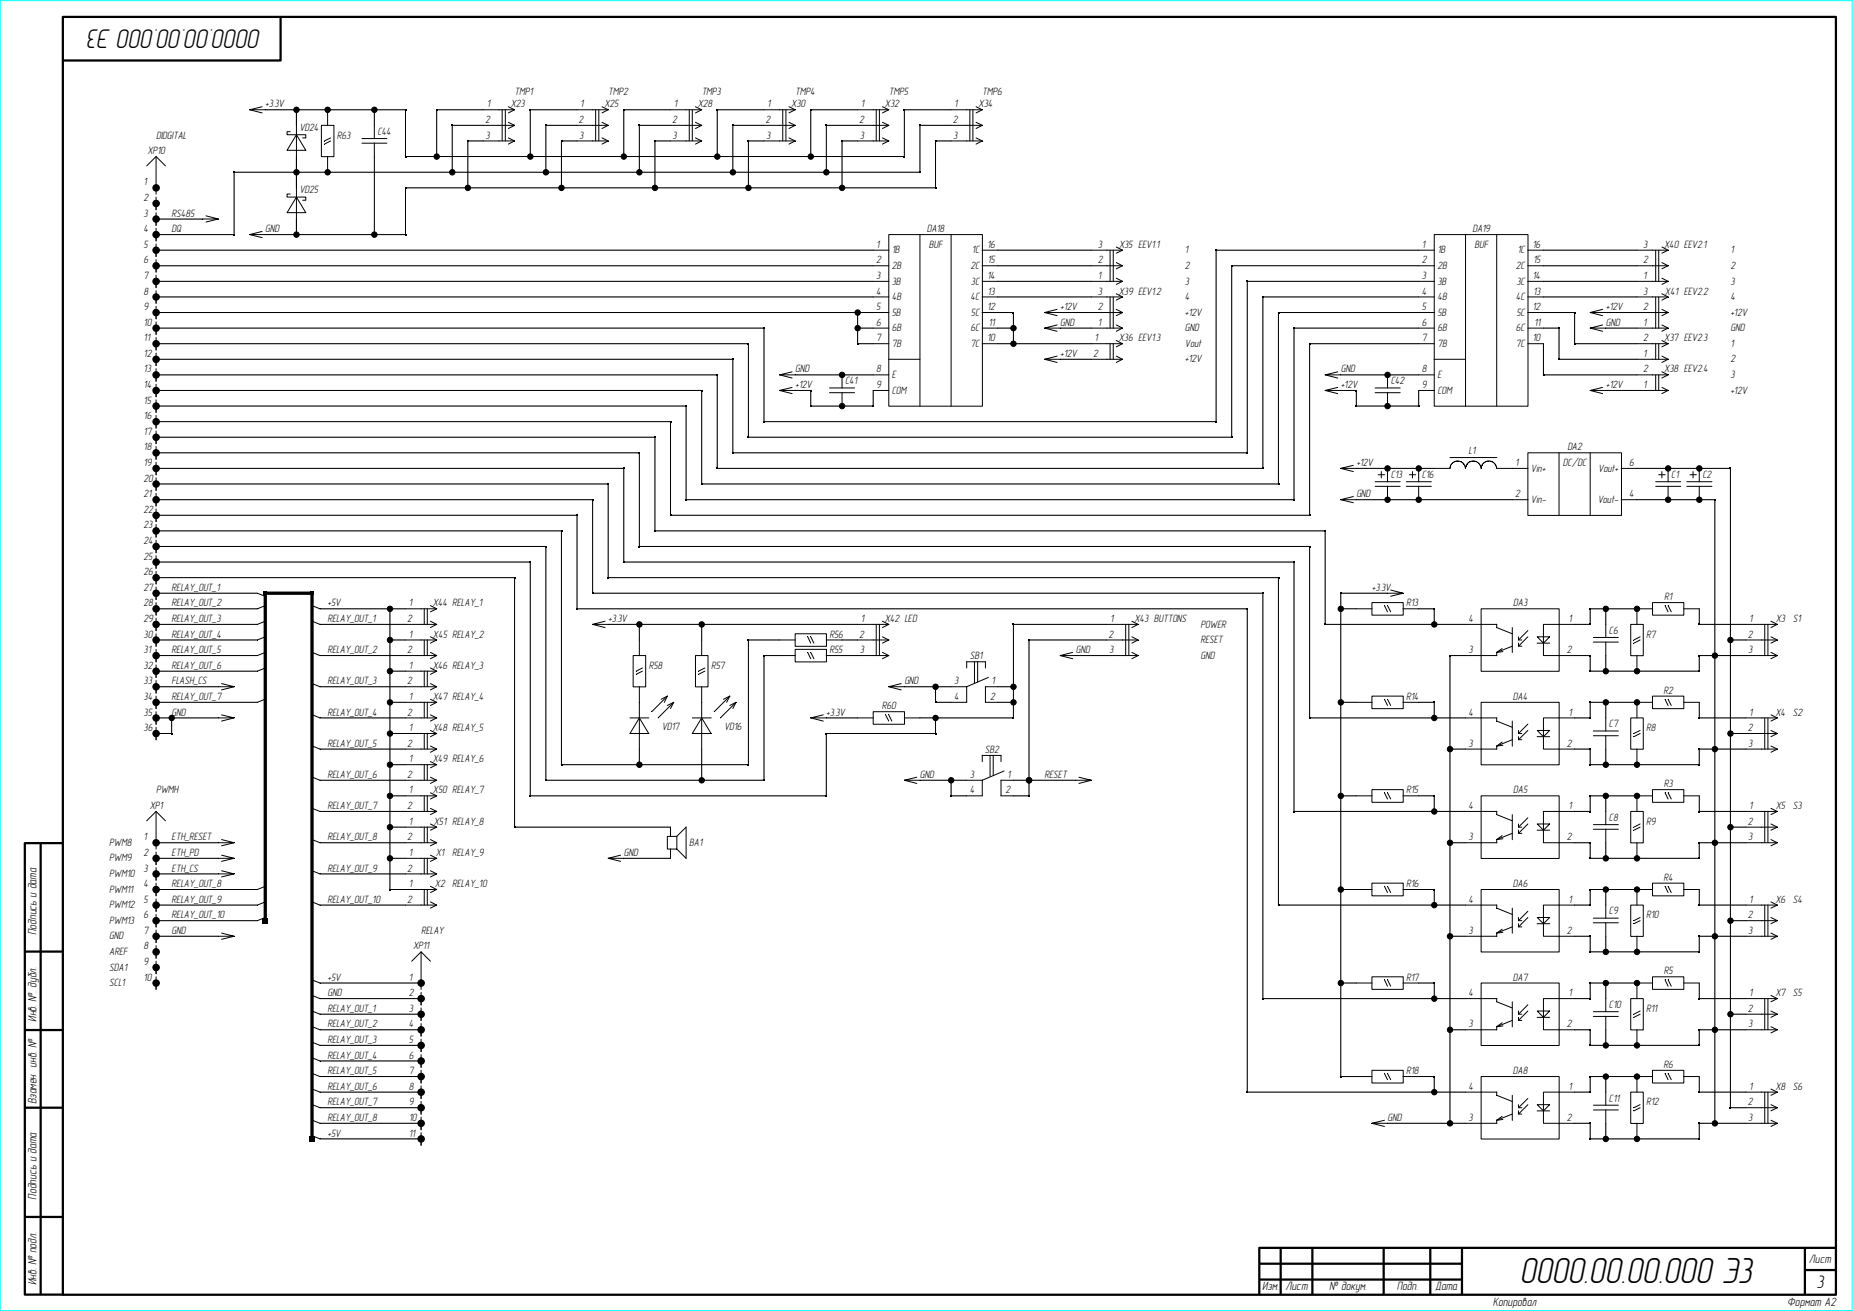
[picture p70: page 3]
