pav2000/ControlHeatPump/Control/Config.h

#define Config_h
#include "SCharts.h"
#include <Ethernet.h>                       // Нужна для определения SPI_RATE в w5100.h
#define CONFIG_5		// pav2000inv  Инвертор BLDC с шаговым ЭРВ и РТО
    #define CONFIG_NAME   "pav2000inv"                                        // Имя конфигурации
    #define CONFIG_NOTE   "Инвертор с компрессором BLDC с шаговым ЭРВ и РТО"  // Описание конфигурации
    #define HP_SCHEME       2                                                 // Номер схемы который выводится на морде, подмена файлов plan[HPscheme].png -> plan1.png
	#define DEBUG                                                             // В последовательный порт шлет сообщения в первую очередь ошибки
	#define DEBUG_MODWORK                                                     // Вывод в консоль состояние HP при работе
	#define NEXTION                                                           // Разрешить использование дисплея ЗАКОМЕНТИРУЙТЕ эту строку что бы не использовать дисплей
    	#define NEXTION_GENERATOR                                             // Показ на nextion кнопки "Работа от генератора" (ограничение мощности потребления)
    uint8_t SPI_RATE 	 = 2;	                                              // делитель для SPI шины, (2=42MHz, 3=28MHz, 4=21MHz) единый для ВСЕХ устройств
	#define SD_CLOCK     30	                                                  // частота SPI для SD карты в МГц (работало 28)
         #define ONEWIRE_DS2482                                               // Использование мастера i2c Onewire DS2482 (адрес AD0 = 0)
   	   const uint8_t ONEWIRE_2WAY = 0b0000; // На каких шинах (4,3,2,1) двух-проводные датчики, битовая маска
        #define NO_SD_CONTROL                                                 // Использование выхода для контроля вставленной SD карты
        #define SPI_FLASH                                                     // Наличие чипа флеш памяти на шине SPI
        #define DRV_EEV_L9333                                                 // Драйвера ЭРВ L9333  диагностика
        #define KEY_ON_OFF                                                    // KEY1 Наличие кнопки включения и переключения в safeNetwork (нажата при сбросе)
        #define LOAD_VERIFICATION                                             // Признак чтения настроек c проверкой версии, длины, CRC16. Закоментируйте эту строку для ПОПЫТКИ загрузить старый формат, Запись всегда идет в новом
        #define MODBUS_TIME_TRANSMISION 1                                     // Пауза (msec) между запросом и ответом по модбас было 4
        #define I2C_EEPROM_64KB                                               // Использование памяти I2C для записи журнала при коментарии используется оперативка
           #define I2C_FRAM_MEMORY       0                                    // Тип используемой памяти 0 - Флеш; 1  - FRAM память // На рабочем контроллере стоит обычная флеш 64 кб
			#define I2C_ADR_EEPROM    0x50         // Адрес чипа eeprom на шине I2C
			#define I2C_SIZE_EEPROM    512    	   // Объем чипа в килобитах (vad711: FM24V10 - это фактически два чипа разделенные пином, в библиотеке exteeprom сквозная нумерация: 65536+ другая страница)
			  #define I2C_MEMORY_TOTAL   512       // FLASH Итоговый размер I2C памяти в килобитах
			#define I2C_PAGE_EEPROM     64         // Размер страницы для чтения eeprom байты
         #define USE_ELECTROMETER_SDM               // Наличие счетчика SDM120 в конфигурации
         #define SDM_BLOCK                          // Блокировать чтение счетчика при потере связи, в противном случае будут переодически делаться попытки воссановить связь
         #define SDM_MIN_VOLTAGE     170.0          // Минимальное напряжение работы ТН при падении - предупреждение
         #define SDM_MAX_VOLTAGE     250.0          // Максимальное напряжение работы ТН при падении - выключение ТН
         #define SDM_MAX_POWER       2500.0         // Максимальная мощность потребления (ватт) - выключение ТН
		#define EXTERNAL_AREF                       // Использование внешней опоры для АЦП (ADR4525ARZ) требует доработки DUE и поддержки платы
		   #define SAM3X_ADC_REF  2.5006            // Используется внешняя опора ADR4525ARZ плата pav2000 (UT71E результататы ЗИП 2.4997 ТН 2.5006)
		#define POWER_CONTROL                       // Использование выхода для управления питанием платы (можно сбросить все кроме контроллера)
		#define VCC_CONTROL                         // Контроль за питанием контрола (прямое чтение) смотреть ADC_VCC и K_VCC_POWER
     #define STACK_vUpdateCommand  180             // 160 Стек задачи выполнение команд управления (разбор очереди комманд)
     #define STACK_vWebX           170             // 230 Стек задачи веб морды один поток (потоков может быть 1-4) 180 рабоатет
     #define CLEAR_CHART_HP_ON                // очистка графиков при страте ТН
     #define WEB_STATUS_SHOW_VERSION	      // Показывать версию в строке статуса (запрос get_status)
     #define WEB_STATUS_SHOW_OVERHEAT    	  // Показывать перегрев в строке статуса (запрос get_status)
     #define CHART_POINT       400            // Максимальное число точек графика //360 - работает, смотрим свободную память!
     #define W5200_THREAD         4              // Число потоков для сетевого чипа w5200 допустимо 1-4 потока, на 4 скорее всего не хватить места в оперативке
	 #define MQTT                                  // признак использования MQTT при неиспользовании необходимо закоментировать
	 const IPAddress defaultIP(192, 168, 0, 177);
     const IPAddress defaultSDNS(192, 168, 0, 191);
     const IPAddress defaultGateway(192, 168, 0, 1);
     const IPAddress defaultSubnet(255, 255, 255, 0);
     const boolean  defaultDHCP=false;
    #define DEF_DELAY_ON_PUMP           60       // Задержка включения компрессора после включения насосов (сек).
    #define DEF_DELAY_OFF_PUMP          60       // Задержка выключения насосов после выключения компрессора (сек).
    #define DEF_DELAY_START_RES        (5*60)    // Задержка включения ТН после внезапного сброса контроллера (сек.)
    #define DEF_DELAY_REPEAD_START     (10*60)   // Задержка перед повторным включениме ТН при ошибке (попытки пуска) секунды
    #define DEF_DELAY_DEFROST_ON        120      // ДЛЯ ВОЗДУШНОГО ТН Задержка после срабатывания датчика перед включением разморозки (секунды)
    #define DEF_DELAY_DEFROST_OFF       120      // ДЛЯ ВОЗДУШНОГО ТН Задержка перед выключением разморозки (секунды)
    #define DEF_DELAY_R4WAY             120      // Задержка между переключением 4-х ходового клапана и включением компрессора, для выравнивания давлений (сек). Если включены эти опции (переключение тепло-холод)
    #define DEF_DELAY_BOILER_SW         60       // Пауза (сек) после переключение ГВС - выравниваем температуру в контуре отопления/ГВС что бы сразу защиты не сработали
    #define DEF_DELAY_BOILER_OFF        120      // Время (сек) на сколько блокируются защиты при переходе с ГВС на отопление и охлаждение слишком горяче после ГВС
	#define DELAY_AFTER_SWITCH_RELAY	500	     // Задержка после переключения реле, для сглаживания потребления и уменьшения помех(мс)
	#define DELAY_BEFORE_STOP_IN_PUMP	10		 // Задержка перед выключением насоса геоконтура, насос отопления отключается позже (сек)
    #define PIN_SPI_CS_W5XXX   10       // ++ ETH-CS   сигнал CS управление сетевым чипом w5500
    #define PIN_SPI_CS_SD      4        // ++ SD-CS    сигнал CS управление SD картой
    #define PIN_SPI_CS_FLASH   52       // ++ FLASH-CS сигнал CS управление чипом флеш памяти (32 мБит)
    #define PIN_ETH_RES         8       // ++ ETH-RES Сброс сетевого чипа w5500 активный low нормально high
    #define PIN_ETH_INT         9       // ++ ETH-INT Прерывание с w5500 пока не используется надо програмиировать на вход
    #define PIN_ETH_CS         10       // ++ ETH-CS Чип селект SPI w5500
    #define PIN_LED1           38       // ++ LED1 Первый красный светодиод для контроля (питание и фатальная ошибка freeRTOS)
    #define PIN_LED_OK         39       // ++ LED2 Второй зеленый светодиод Выход на светодиод мигает 0.5 герца - ОК  с частотой 2 герца ошибка
    #define PIN_KEY1           40       // ++ KEY1 Первая кнопка (ТН вкл/вкл) Нажатие при включении - режим safeNetwork (настрока сети по умолчанию 192.168.0.177  шлюз 192.168.0.1, не спрашивает пароль на вход в веб морду)
    #define PIN_KEY2           41       // +  KEY2 Вторая кнопка
    #define PIN_KEY3           42       // +  KEY3 Третья кнопка
       #define PIN_BEEP        43       // ++ SOUND Выход на пищалку  88- нога не использующиеся
    #define PIN_STEP_DIAG      44       // ++ STEP-DIAG Контроль драйвера шаговика
    #define PIN_NO_SD_CARD     45       // ++ CD Отсутствие карты в слоте
    #define PIN_POWER_ON       50       // ++ PWR-OFF Включение питания на всю плату (включение LOW)
    #define PIN_ADC_VCC        3        // ++ Нога АЦП куда заводится через делитель напряжение питания (в нумерации sam3x!) в ардуино это А4, коэффициент пересчета K_VCC_POWER
    #define PIN_EEV1_D24       24       // ++ первая нога ЭРВ D24  ОРАНЖЕВЫЙ  +А
    #define PIN_EEV2_D25       25       // ++ вторая нога ЭРВ D25  КРАСНЫЙ    +B
    #define PIN_EEV3_D26       26       // ++ третья нога ЭРВ D26  ЖЕЛТЫЙ     -A
    #define PIN_EEV4_D27       27       // ++ четвертая нога ЭРВ D27 ЧЕРНЫЙ   -B
    #define PIN_DEVICE_FC      DAC0     // ++ DAC Аналоговое управление инвертором
    #define PIN_MODBUS_RSE     22       // +  RS485DE  Управление направлением передачи 485 для связи с инвертором по Modbus (1-передача 0-прием)
    #define ADC_SENSOR_PEVA    11       // + НОМЕР КАНАЛА ацп (внимание - в нумерации sam3x!) нога куда прицеплен датчик давления PEVA
    #define ADC_SENSOR_PCON    10       // - НОМЕР канала ацп (в нумерации sam3x!) нога куда прицеплен датчик давления PCON
    #define INUMBER            3       // Максимальное число контактных датчиков цифровые входы (то что поддерживается)
    #define PIN_SENSOR_SLOWP   32       // ++ DIN1 Датчик низкого давления
    #define PIN_SENSOR_SHIGHP  33       // ++ DIN2 Датчик высокого давления
    #define PIN_SENSOR_SERRFC 34       // ++ DIN3 Сигнал ошибка инвертора
     #define SLOWP             0        // Датчик низкого давления
     #define SHIGHP            1        // Датчик высокого давления
     #define SERRFC            2        // Сигнал ошибка инвертора
     const uint8_t pinsInput[INUMBER] = {  PIN_SENSOR_SLOWP,          // ++ DIN1 Датчик низкого давления
                                           PIN_SENSOR_SHIGHP,         // ++ DIN2 Датчик высокого давления
                                           PIN_SENSOR_SERRFC         // ++ DIN3 Сигнал ошибка инвертора
                                         };
      const char *noteInput[INUMBER] = { "Датчик низкого давления",       // аварийный
                                         "Датчик высокого давления",      // аварийный
                                         "Сигнал ошибки Omron MX2"        // аварийный
                                       };
      const char *nameInput[INUMBER] = {"SLOWP",            // Датчик низкого давления
                                        "SHIGHP",           // Датчик высокого давления
                                        "SERRFC"           // Сигнал ошибка инвертора
                                       };
      const bool TESTINPUT[INUMBER]={true,true,true};                  // Значения датчиков при тестировании  опция TEST
      const bool ALARMINPUT[INUMBER]={false,false,false};              // Значение датчика при аварии  ПРОВЕРИТЬ НА РЕАЛЬНОЕ СООТВЕТВИЕ (актуально только для pALARM )
      const TYPE_SENSOR SENSORTYPE[INUMBER]={pALARM,pALARM,pALARM};    // тип контактного датчика  pALARM, pSENSOR,  pPULSE
    #define FNUMBER            1       // Максимальное число частотных датчиков цифровые входы (то что поддерживается) код поддерживает ТРИ датчика максимально
    #define PIN_SENSOR_FLOWCON   35     // - DIN4 Датчик потока по кондесатору
     #define FLOWCON        0        // Датчик потока по кондесатору
     const uint8_t pinsFrequency[FNUMBER] = {PIN_SENSOR_FLOWCON       // - DIN4 Датчик потока по кондесатору
                                             };
      const char *noteFrequency[FNUMBER] = { "Поток через кондесатор (куб/ч)"       // - DIN4 Датчик потока по кондесатору
                                           };
      const char *nameFrequency[FNUMBER] = { "FLOWCON"                      // Датчик потока по кондесатору
                                           };
      const uint16_t TRANSFLOW[FNUMBER]={3675};                    // Коэффициент преобразования частота - поток сотые
      const uint16_t TESTFLOW[FNUMBER]={700};                      // Значения датчиков при тестировании  опция TEST тысячные куба
      const uint16_t MINFLOW[FNUMBER]= {2};                        // МИНИМАЛЬНЫЕ Значения датчиков десятые куба
      #define FLOW_CONTROL							        	  // Контроль потоков через ПТО (актуален если установлены расходомеры)
    #define RNUMBER            9           // Число исполнительных устройств (всех) 7 силовых 2 - сухих контакта
    #define PIN_DEVICE_RCOMP     2        // ++ PWR_ON1 Реле включения компрессора (через инвертор)
    #define PIN_DEVICE_RPUMPI    12       // ++ PWR_ON2 Реле включения насоса входного контура  (геоконтур)
    #define PIN_DEVICE_RPUMPO    13       // ++ PWR_ON3 Реле включения насоса выхордного контура  (отопление и ГВС)
    #define PIN_DEVICE_RBOILER   28       // ++ PWR_ON4 Включение ТЭНа бойлера
    #define PIN_DEVICE_R4WAY      11       // ++ PWR_ON5 4-ходовой клапан
    #define PIN_DEVICE_R3WAY     7        // ++ PWR_ON6 Трех ходовой кран. Переключение системы СО — ГВС (что сейчас греть)
    #define PIN_DEVICE_RHEAT     30       // ++ PWR_ON7 Включение ТЭНа СО (электрокотел), может использоваться как догрев, резерв и т.д.
    #define PIN_DEVICE_RPUMPB    29       // ++ PWR_ON8 Реле насоса циркуляции бойлера (ГВС)
    #define PIN_OMRON_RESET      3        // ++ DOUT2 Выход для сброса инвертора
    #define RCOMP              0          // Реле включения компрессора (через пускатель)
    #define RPUMPI             1          // Реле включения насоса входного контура  (геоконтур)
    #define RPUMPO             2          // Реле включения насоса выхордного контура  (отопление и ГВС)
    #define RBOILER            3          // Включение ТЭНа бойлера
    #define R4WAY               4          // 4-ходовой клапан (охлаждение)
    #define R3WAY              5          // Трех ходовой кран. Переключение системы СО — ГВС (что сейчас греть)
    #define RHEAT              6          // Включение ТЭНа СО (электрокотел), может использоваться как догрев, резерв и т.д.
    #define RPUMPB             7          // Реле насоса циркуляции бойлера (ГВС)
    #define RRESET             8          // Выход для сброса инвертора
   const uint8_t pinsRelay[RNUMBER] = { PIN_DEVICE_RCOMP,       // ++ PWR_ON1 Реле включения компрессора (через пускатель)
                                        PIN_DEVICE_RPUMPI,      // ++ PWR_ON2 Реле включения насоса входного контура  (геоконтур)
                                        PIN_DEVICE_RPUMPO,      // ++ PWR_ON3 Реле включения насоса выхордного контура  (отопление и ГВС)
                                        PIN_DEVICE_RBOILER,     // ++ PWR_ON4 Включение ТЭНа бойлера
                                        PIN_DEVICE_R4WAY,        // ++ PWR_ON5 4-ходовой клапан
                                        PIN_DEVICE_R3WAY,       // ++ PWR_ON6 Трех ходовой кран. Переключение системы СО — ГВС (что сейчас греть)
                                        PIN_DEVICE_RHEAT,       // - Включение ТЭНа СО (электрокотел), может использоваться как догрев, резерв и т.д.
                                        PIN_DEVICE_RPUMPB,      // ++ PWR_ON8 Реле насоса циркуляции бойлера (ГВС)
                                        PIN_OMRON_RESET        // ++ DOUT2 Выход для сброса инвертора
                                       };
  const char *noteRelay[RNUMBER] =  {"Реле включения компрессора (через инвертор)",
                                     "Реле включения насоса входного контура  (геоконтур)",
                                     "Реле включения насоса выходного контура (отопление и ГВС)",
                                     "Реле включение ТЭНа бойлера (ГВС)",
                                     "4-ходовой клапан (для режима охлаждения надо включить)",
                                     "Трех ходовой кран, переключение ТН между отоплением и ГВС ",
                                     "Реле включение ТЭНа системы отопления (электрокотел)",
                                     "Реле насоса циркуляции бойлера (ГВС)",
                                     "Выход для сброса инвертора"
                                    };
  const char *nameRelay[RNUMBER] = { "RCOMP",          // Реле включения компрессора (через пускатель)
                                     "RPUMPI",         // Реле включения насоса входного контура  (геоконтур)
                                     "RPUMPO",         // Реле включения насоса выхордного контура  (отопление и ГВС)
                                     "RBOILER",        // Реле включение ТЭНа бойлера (ГВС)
                                     "R4WAY",           // 4-ходовой клапан инвертирован
                                     "R3WAY",          // Трех ходовой кран, переключение ТН между отоплением и ГВС
                                     "RHEAT",          // Реле включение ТЭНа системы отопления (электрокотел)
                                     "RPUMPB",         // Реле насоса циркуляции бойлера (ГВС)
                                     "RRESET"          // Выход для сброса инвертора
                                     } ;
     #define FEED      sTemp[TCONOUTG].get_Temp()               // Подача системы СО- выход по гликолю кондесатора
     #define RET       sTemp[TCONING].get_Temp()                // Обратка системы СО- вход по гликолю кондесатора
     #define PUMP_OUT      RPUMPO                               // Насос выходного контура (отопление)
     #define PUMP_IN       RPUMPI                               // Насос входного  контура (гео или воздушник)
	#define TNUMBER     14      // Максимальное число температурных датчиков (то что поддерживается)
	#define SENSOR_IP           // Использование удаленных устройств( датчиков температуры смотрим IPNUMBER )
	#define IPNUMBER    1       // Максимальное число удаленных датчиков, запрет использования  SENSOR_IP
    #define RADIO_SENSORS_MAX 0 // Число радио датчиков
	#define ANUMBER     2       // Максимальное число аналоговых датчиков (то что поддерживается)
      #define TOUT        0  // 28FFBD5800160137 9 Температура улицы
      #define TIN         1  // 28FFBA5301150433 4 Температура в доме
      #define TEVAIN      2  // 28FFD35088160363 11 Температура на входе испарителя (по фреону)
      #define TEVAOUT     3  // 28FFEA4CB516052D 3 Температура на выходе испарителя (по фреону)
      #define TCONIN      4  // 28FFCF4488160308 14 Температура на входе конденсатора (по фреону)установлен 02.06.19
      #define TCONOUT     5  // 28FF2746881603EB 12 Температура на выходе конденсатора (по фреону) установлен 02.06.19
      #define TBOILER     6  // 289385A504000059 1 Температура в бойлере ГВС
      #define TACCUM      7  // 28FF4DE29216051D 7 Температура на выходе теплоаккмулятора
      #define TCOMPIN     8  // 28FF06058B160352 5 Температура на входе компрессора
      #define TCOMP       9  // 28FF2D4D881603C2 8 Температура нагнетания компрессора
      #define TEVAING     10 // 28FFB7419116049D 13 Температура на входе испарителя (по гликолю)
      #define TEVAOUTG    11 // 28FFDED0B5160398 6 Температура на выходе испарителя (по гликолю)
      #define TCONING     12 // 28FF53EBB31603B2 10 Температура на входе конденсатора (по гликолю)
      #define TCONOUTG    13 // 28FF7221911604FD 2 Температура на выходе конденсатора (по гликолю)
		const char *nameTemp[] = {"TOUT",             // Температура улицы
		                          "TIN",              // Температура в доме
		                          "TEVAIN",           // Температура на входе испарителя по фреону
		                          "TEVAOUT",          // Температура на выходе испарителя по фреону
		                          "TCONIN",           // Температура на входе конденсатора по фреону
		                          "TCONOUT",          // Температура на выходе конденсатора по фреону
		                          "TBOILER",          // Температура в бойлере ГВС
		                          "TACCUM",           // Температура на выходе теплоаккмулятора
		                          "TCOMPIN",          // Температура на входе компрессора
		                          "TCOMP",            // Температура нагнетания компрессора
		                          "TEVAING",          // Температура на входе испарителя по гликолю
		                          "TEVAOUTG",         // Температура на выходе испарителя по гликолю
		                          "TCONING",          // Температура на входе конденсатора по гликолю
		                          "TCONOUTG"          // Температура на выходе конденсатора по гликолю
		                           };
		const char *noteTemp[] = {"Т° улицы",
		                          "Т° в доме",
		                          "Т° на входе испарителя по фреону",
		                          "Т° на выходе испарителя по фреону",
		                          "Т° на входе конденсатора по фреону",
		                          "Т° на выходе конденсатора по фреону",
		                          "Т° в бойлере ГВС",
		                          "Т° на выходе теплоаккумулятора",
		                          "Т° на входе компрессора (всас)",
		                          "Т° нагнетания", //  "Т° на выходе компрессора (нагнетание)"
		                          "Т° на входе испарителя по гликолю",
		                          "Т° на выходе испарителя по гликолю",
		                          "Т° на входе конденсатора по гликолю",
		                          "Т° на выходе конденсатора по гликолю"
		                          };
       const boolean SENSORTEMP[TNUMBER]={true,true,true,true,true,true,true,true,true,true,true,true,true,true};
       const int16_t MINTEMP[TNUMBER]={-3500,-3000,-1500,-1000,-2000,-2000,0,-500,-1510,100,-1000,-1000,-1000,-1000};
       const int16_t MAXTEMP[TNUMBER]={4000,3500,2520,4000,8500,6520,5510,4200,4010,8700,2500,2500,5000,5500};
       const int16_t TESTTEMP[TNUMBER]={1000,2000,300,400,1000,3000,765,123,-500,500,0,0,2000,2000};
       const int16_t ERRTEMP[TNUMBER]=  {     0,    0,    0,    0,    0,    0,    0,    0,    0,    0,    0,    0,    0,    0 };
      	#define PEVA			0                // Датчик давления испарителя.
      	#define PCON			1                // Датчик давления конденсатора.
       const char *nameAnalog[] =       {
                                        "PEVA",
                                        "PCON"
                                        };
      const char *noteAnalog[] = {"Давление испарителя (bar)", // Датчик давления испарителя.
                                 "Давление конденсатора (bar)"};  // Датчик давления конденсатора.
      const uint16_t TRANsADC[ANUMBER]={482,300};
      const uint16_t ANALOG_ZERO[ANUMBER]={285,150};
      const boolean ANALOG_SENSORS[ANUMBER]={true,false};
      const int16_t ANALOG_MIN[ANUMBER]={350,100};        // минимальные значения давления
      const uint16_t ANALOG_MAX[ANUMBER]={1500,3000};     // Макимальные значения давления
      const uint16_t ANALOG_TEST[ANUMBER]={600,1200};      // Значения датчиков при тестировании  опция TEST
      #define ADC_PRESCAL		10             // [20]  = (42 / ADCClockMhz - 1)
      #define ADC_SKIP_EXTREMUM 400            // [400] Отбрасывать максимумы/минимумы больше заданной дельты
      #define P_NUMSAMLES       1              // [1]   Число значений для усреднения показаний давления
      #define ADC_FREQ        100            // [20]  Частота опроса аналоговых датчиков
      #define FILTER_SIZE       128            // [40]  Длина фильтра для датчика давления
      #define FILTER_SIZE_OTHER 8              // [8]   Длина фильтра для остальных датчиков
    	Charts_Mod_setup ChartsModSetup[] = {
    		{ STATS_OBJ_Temp, TOUT },
    		{ STATS_OBJ_Temp, TIN },
    		{ STATS_OBJ_Temp, TBOILER },
    		{ STATS_OBJ_Temp, TCOMP },
    		{ STATS_OBJ_Temp, TCOMPIN },  // вход компрессора
    		{ STATS_OBJ_Temp, TACCUM },   // аккумулятор
    		{ STATS_OBJ_Temp, TEVAING },
    		{ STATS_OBJ_Temp, TEVAOUTG },
    		{ STATS_OBJ_Temp, TCONING },
    		{ STATS_OBJ_Temp, TCONOUTG },
    		{ STATS_OBJ_Temp, TEVAOUT },
    		{ STATS_OBJ_Temp, TCONOUT },
    		{ STATS_OBJ_Flow, FLOWCON },
 	   		{ STATS_OBJ_Press, PEVA }	// Давление
    	};
    	const Charts_Const_setup ChartsConstSetup[] = {
    		{ STATS_OBJ_EEV, "ЭРВ" },                  // Отключать нельзя используется на странице ЭРВ
    		{ STATS_OBJ_Overheat, "Перегрев" },        // Отключать нельзя используется на странице ЭРВ
    		{ STATS_OBJ_Overheat2, "Цель перегрева" }, // Отключать нельзя используется на странице ЭРВ это цель перегрева
    		{ STATS_OBJ_Compressor, "Частота, Гц" },
    		{ STATS_OBJ_Power_FC, "Мощность компрессора" },
    		{ STATS_OBJ_Power, "Потребляемая мощность" },
    		{ STATS_OBJ_Voltage, "Напряжение сети" },
     		{ STATS_OBJ_COP_Full, "Full COP" }
    	};
    	const Charts_Const_setup ChartsOnFlySetup[] = {
    		{ STATS_OBJ_Overcool, "Переохлаждение" }, // T[PCON] - TCONOUT
    		{ STATS_OBJ_TCOMP_TCON, "Нагнетание - Конденсация" }, // TCOMP - TCON Отключать нельзя используется на странице ЭРВ
    		{ STATS_OBJ_Delta_GEO, "Δ t° геоконтура" }, // TEVAING - TEVAOUTG
    		{ STATS_OBJ_Delta_OUT, "Δ t° выхода" }, // TCONOUTG - TCONING
    		{ STATS_OBJ_Power_OUT, "Выходная мощность" } // (TCONOUTG - TCONING) * FLOWCON / kfCapacity
    	};
      const History_setup HistorySetup[] = {
      	{ STATS_OBJ_Temp, TOUT, nameTemp[TOUT] },
      	{ STATS_OBJ_Temp, TIN, nameTemp[TIN] },
      	{ STATS_OBJ_Temp, TBOILER, nameTemp[TBOILER] },
      	{ STATS_OBJ_Temp, TCOMP, nameTemp[TCOMP] },
      	{ STATS_OBJ_Temp, TEVAING, nameTemp[TEVAING] },
      	{ STATS_OBJ_Temp, TEVAOUTG, nameTemp[TEVAOUTG] },
      	{ STATS_OBJ_Temp, TCONING, nameTemp[TCONING] },
      	{ STATS_OBJ_Temp, TCONOUTG, nameTemp[TCONOUTG] },
      	{ STATS_OBJ_Temp, TEVAOUT, nameTemp[TEVAOUT] },
		{ STATS_OBJ_Flow, FLOWCON, nameFrequency[FLOWCON] },
		{ STATS_OBJ_EEV, STATS_EEV_Steps, "EEV" },
		{ STATS_OBJ_EEV, STATS_EEV_OverHeat, "OverHeat" },
		{ STATS_OBJ_Compressor, 0, "Freq" },
		{ STATS_OBJ_Power, 0, "power220" },
		{ STATS_OBJ_Power_OUT, 0, "powerCO" },
		{ STATS_OBJ_COP_Full, 0, "fullCOP" }
      };
       #define EEV_DEF                                // Наличие ЭРВ в конфигурации
		#define FREON                  R410A 		  // Тип фреона
       #define DEF_FC_PID_P_ON_M        false         // Режим ПИДа отопления, бойлера - true пропорционально измерению, false - пропорционально ошибке   актуально для PID_FORMULA2
		#define EEV_STEPS              490            // Число шагов ЭРВ 480
		#define EEV_QUEUE              10             // Длина очереди команд шагового двигателя ЭРВ
	    #define EEV_CLOSE_STEP         2              // Позиция ЭРВ - Закрыто
		#define EEV_PHASE              PHASE_8s       // ЗАДАННАЯ (можно менять) последовательность (шагов) при движении ЭРВ
  	    #define EEV_MIN_CONTROL                       // Контроль нижней границы ЭРВ - останов по ошибке.
	    #define EEV_MAX_CONTROL                       // Контроль верхней границы ЭРВ, включать только если ЭРВ правильно подобран (верхняя граница не достижима в процессе работы)
		#define DEFAULT_RULE_EEV       TEVAOUT_PEVA   // Формула по умолчанию - TEVAOUT_PEVA
		#define DEFAULT_EEV_TIME	   50			  // Постоянная интегрирования времени в секундах ЭРВ СЕКУНДЫ
		#define DEFAULT_OVERHEAT       310			  // Перегрев по умолчанию (сотые градуса)
		#define DEFAULT_EEV_Kp	       2500			  // ПИД Коэф пропорц.  В ТЫСЯЧНЫХ
		#define DEFAULT_EEV_Ki	       800			  // ПИД Коэф интегр.   В ТЫСЯЧНЫХ
		#define DEFAULT_EEV_Kd	       900			  // ПИД Коэф дифф.     В ТЫСЯЧНЫХ
	    #define DEFAULT_ERR_KP         0              // Ошибка (в сотых градуса) при которой происходит уменьшение пропорциональной составляющей ПИД ЭРВ
	    #define DEFAULT_SPEED_EEV      80             // Скорость шагового двигателя ЭРВ (импульсы в сек.)
	    #define DEFAULT_PRE_START_POS  100            // ПУСКОВАЯ позиция ЭРВ (ТО что при старте компрессора ПРИ РАСКРУТКЕ)
	    #define DEFAULT_START_POS      90             // СТАРТОВАЯ позиция ЭРВ после раскрутки компрессора т.е. ПОЗИЦИЯ С КОТОРОЙ НАЧИНАЕТСЯ РАБОТА проходит DelayStartPos сек
	    #define DEFAULT_HOLD_MOTOR     false          // Режим "удержания" шагового двигателя ЭРВ
	  	#define DEF_OHCor_TDIS_TCON			2400		// Разница температура нагнетания - конденсации при 30С, 0 конденсации и перегреве OHCor_OverHeatStart (в сотых)
		#define DEF_OHCor_TDIS_TCON_Thr 	20		    // Порог, после превышения TDIS_TCON + TDIS_TCON_Thr начинаем менять перегрев (в десятых)
  		#define DEF_OHCor_CONDENSING_30_MUL 57			// Корректировка разницы Нагнетание-Конденсация на кажлые 10 градусов конденсации от 30 (в десятых), зависит от фреона
		#define DEF_OHCor_EVAPORATING_0_MUL 86			// Корректировка разницы Нагнетание-Конденсация на кажлые -10 градусов кипения от 0 (в десятых), зависит от фреона
		#define DEF_OHCor_Delay 			300         // Задержка после старта компрессора, сек
  		#define DEF_OHCor_Period 			10		    // Период в циклах ЭРВ, сколько пропустить
		#define DEF_OHCor_K 				100      	// Коэффициент (/0.001): перегрев += дельта * K
		#define DEF_OHCor_OverHeatMin 		150    		// Минимальный перегрев (сотые градуса)
		#define DEF_OHCor_OverHeatMax 		400    		// Максимальный перегрев (сотые градуса)
		#define DEF_OHCor_OverHeatStart 	300		  	// Начальный перегрев (сотые градуса)
	    #define DEFAULT_DELAY_ON_PID    120            // Задержка включения EEV после включения компрессора (сек).  Точнее после выхода на рабочую позицию Общее время =delayOnPid+DelayStartPos
	    #define DEFAULT_DELAY_ON        5             // Задержка между открытием (для старта) ЭРВ и включением компрессора, для выравнивания давлений (сек). Если ЭРВ закрывлось при остановке
	    #define DEFAULT_DELAY_START_POS 30            // Время после старта компрессора когда EEV выходит на стартовую позицию - облегчение пуска вначале ЭРВ
	    #define DEFAULT_DELAY_OFF       10            // Задержка закрытия EEV после выключения насосов (сек). Время от команды стоп компрессора до закрытия ЭРВ = delayOffPump+delayOff
      const boolean DEVICEFC=true;                // Наличие Частотного преобразователя в конфигурации
      #define FC_USE_RCOMP                        // Использовать для пуска/остановки инвертора отдельный выход RCOMP (команда по модбасу не посылается)
      #define FC_DT_CON_PRESS     50               // Защита по давлению компрессора - сколько сотых бара не доходит до максимальной (PCON) и при этом происходит уменьшение частоты
      #define FC_MAX_POWER        (1.8*1000)       // Максимальная мощность инвертора (см компрессор) в 0.1 кВт
      #define FC_MAX_POWER_BOILER (1.3*1000)       // Максимальная мощность инвертора в режиме ГВС (см компрессор) в 0.1 кВт
      #define FC_MAX_CURRENT      (10.0*100)       // Максимальный ток инвертора (см компрессор) в 0.01 А
      #define FC_MAX_CURRENT_BOILER (11.0*100)     // Максимальный ток инвертора для ГВС в 0.01 А
      #define FC_BASE_FREQ        (120*100)        // Основная частота инвертора (см компрессор) в 0.01 Гц
      #define FC_ACCEL_TIME       (60*100)         // Время разгона (см компрессор) в 0.01 сек
      #define FC_DEACCEL_TIME     (60*100)         // Время торможения (см компрессор) в 0.01 сек
	  #define FC_START_PID_DELAY  (30*100)         // Задержка ПИД после старта компрессора
      #define DEF_FC_DT_COMP_TEMP     (5*100)        // Защита по температуре компрессора - сколько градусов не доходит до максимальной (TCOMP) и при этом происходит уменьшение частоты
      #define DEF_FC_UPTIME           (10)         // Время обновления алгоритма пид регулятора (мсек) Основной цикл управления
      #define DEF_FC_PID_FREQ_STEP    (2*100)        // Максимальный шаг (на увеличение) изменения частоты при ПИД регулировании в 0.01 Гц Необходимо что бы ЭРВ успевал
      #define DEF_FC_PID_STOP            90          // Проценты от уровня защит (мощность, ток, давление, темпеартура) при которой происходит блокировка роста частоты пидом (плавный подход к границе)
      #define DEF_FC_START_FREQ        (55*100)       // Стартовая частота частота инвертора отопление/охлаждение (см компрессор) в 0.01 Гц
      #define DEF_FC_START_FREQ_BOILER (45*100)      // Стартовая частота частота инвертора ГВС (см компрессор) в 0.01 Гц ГВС
      #define DEF_FC_MIN_FREQ         (40*100)       // Минимальная  частота инвертора при нагреве (см компрессор) в 0.01 Гц
      #define DEF_FC_MIN_FREQ_COOL    (60*100)       // Минимальная  частота инвертора при охлаждении в 0.01 Гц
      #define DEF_FC_MIN_FREQ_BOILER  (40*100)       // Минимальная  частота инвертора при нагреве ГВС в 0.01 Гц
      #define DEF_FC_MIN_FREQ_USER    (35*100)       // Минимальная  частота инвертора РУЧНОЙ РЕЖИМ (см компрессор) в 0.01 Гц
      #define DEF_FC_MAX_FREQ         (130*100)      // Максимальная частота инвертора при нагреве (см компрессор) в 0.01 Гц
      #define DEF_FC_MAX_FREQ_COOL    (100*100)      // Максимальная частота инвертора в режиме охлаждения  в 0.01 Гц
      #define DEF_FC_MAX_FREQ_BOILER  (50*100)       // Максимальная частота инвертора в режиме ГВС в 0.01 Гц поглощение бойлера обычно меньше чем СО
      #define DEF_FC_MAX_FREQ_USER    (120*100)      // Максимальная частота инвертора РУЧНОЙ РЕЖИМ (см компрессор) в 0.01 Гц
      #define DEF_FC_STEP_FREQ        (2*100)        // Шаг уменьшения частоты инвертора при достижении максимальной температуры, мощности и тока (см компрессор) в 0.01 Гц
      #define DEF_FC_STEP_FREQ_BOILER (5*100)        // Шаг уменьшения частоты инвертора при достижении максимальной температуры, мощности и тока ГВС в 0.01 Гц
      #define DEF_FC_DT_TEMP          (1*100)        // Привышение температуры от уставок (подача) при которой срабатыват защита (уменьшается частота) в сотых градуса
      #define DEF_FC_DT_TEMP_BOILER   (2*100)        // Привышение температуры от уставок (подача) при которой срабатыват защита ГВС в сотых градуса
