pav2000/ControlHeatPump/Control/Control.ino

/*
 * Copyright (c) 2016-2023 by Pavel Panfilov <firstlast2007@gmail.com> skype pav2000pav
 * &                       by Vadim Kulakov vad7@yahoo.com, vad711
 * "Народный контроллер" для тепловых насосов.
 * Данное програмноое обеспечение предназначено для управления
 * различными типами тепловых насосов для отопления и ГВС.
 *
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
 * This file is distributed in the hope that it will be useful,
 * but WITHOUT ANY WARRANTY; without even the implied warranty of
 * MERCHANTABILITY or FITNESS FOR A PARTICULAR PURPOSE.See the
 * GNU General Public License for more details.
 */
// Последние версии
// https://github.com/pav2000/ControlHeatPump проект на гитхабе (рабочие сборки)
// https://github.com/vad7/ControlHeatPump - последняя стабильная версия
// http://77.50.254.24:25402/ последняя версия демо
// http://77.50.254.24:25402/mob/index.html мобильная морда демо
// Архивные ссылки
// http://pumps.tk/webtn.zip  последняя вебморда
// http://pumps.tk/v09/ демо версия (старая)
// http://pumps.tk/v09/mob мобильная демо версия (старая)
// https://github.com/vad7/Arduino-DUE-WireSam  библиотеки доработанные vad711 при релизе добавляются в архив

#include "Arduino.h"
#include "Constant.h"                       // Должен быть первым !!!! кое что берется в стандартных либах для настройки либ, Config.h входит в него

#include <WireSam.h>                        // vad711 доработанная библиотека https://github.com/vad7/Arduino-DUE-WireSam
#include <DS3232.h>                         // vad711 Работа с часами i2c - используются при выключении питания. модифицированная https://github.com/vad7/Arduino-DUE-WireSam
#include <extEEPROM.h>                      // vad711 Работа с eeprom и fram i2c библиотека доработана для DUE!!! https://github.com/vad7/Arduino-DUE-WireSam

#include <SPI.h>                            // SPI - стандартная
#include "SdFat.h"                          // SdFat - модифицированная
#include "FreeRTOS_ARM.h"                   // модифицированная
#include <rtc_clock.h>                      // работа со встроенными часами  Это основные часы!!!
#include <ModbusMaster.h>                   // Используется МОДИФИЦИРОВАННАЯ для омрона мх2 либа ModbusMaster https://github.com/4-20ma/ModbusMaster

// Глубоко переделанные библиотеки
#include <Ethernet.h>                       // Ethernet - модифицированная
#include <Dns.h>                            // DNS - модифицированная
#include <SerialFlash.h>                    // Либа по работе с spi флешом как диском

#include "Hardware.h"
#include "HeatPump.h"
#include "Nextion.h"
#include "Message.h"
#include "Information.h"
#include "MQTT.h"
#include "Statistics.h"

void vUpdateStepperEEV(void *);
#include "StepMotor.h"

// Мютексы блокираторы железа
SemaphoreHandle_t xModbusSemaphore;                 // Семафор Modbus, инвертор запас на счетчик
SemaphoreHandle_t xWebThreadSemaphore;              // Семафор потоки вебсервера,  деление сетевой карты
SemaphoreHandle_t xI2CSemaphore;                    // Семафор шины I2C, часы, память, мастер OneWire
SemaphoreHandle_t xSPISemaphore;                    // Семафор шины SPI  сетевая карта, память. SD карта // пока не используется
SemaphoreHandle_t xLoadingWebSemaphore;             // Семафор загрузки веб морды в spi память
uint16_t lastErrorFreeRtosCode;                     // код последней ошибки операционки нужен для отладки
uint32_t startSupcStatusReg;                        // Состояние при старте SUPC Supply Controller Status Register - проверяем что с питание


#if defined(W5500_ETHERNET_SHIELD)                  // Задание имени чипа для вывода сообщений
  const char nameWiznet[] ={"W5500"};
#elif defined(W5200_ETHERNET_SHIELD)
  const char nameWiznet[] ={"W5200"};
#else
  const char nameWiznet[] ={"W5100"};
#endif

// Глобальные переменные
EthernetServer server1(80);                         // сервер
EthernetUDP Udp;                                    // Для NTP сервера
EthernetClient ethClient(W5200_SOCK_SYS);           // для MQTT

#ifdef RADIO_SENSORS
void check_radio_sensors(void);
void radio_sensor_send(char *cmd);
#endif

#ifdef MQTT                                 // признак использования MQTT
#include <PubSubClient.h>                   // передаланная под многозадачность  http://knolleary.net
PubSubClient w5200_MQTT(ethClient);  	    // клиент MQTT
#endif

// I2C eeprom Размер в килобитах, число чипов, страница в байтах, адрес на шине, тип памяти:
extEEPROM eepromI2C(I2C_SIZE_EEPROM,I2C_MEMORY_TOTAL/I2C_SIZE_EEPROM,I2C_PAGE_EEPROM,I2C_ADR_EEPROM,I2C_FRAM_MEMORY);
#ifdef USE_RC_CLOCK_SOURCE
RTC_clock rtcSAM3X8(RC);                                               // Внутренние часы, используется внутренний RC генератор
#else
RTC_clock rtcSAM3X8(XTAL);                                               // Внутренние часы, используется часовой кварц
#endif
DS3232  rtcI2C;                                                          // Часы 3231 на шине I2C
static Journal  journal;                                                 // системный журнал, отдельно т.к. должен инициализоваться с начала старта
static HeatPump HP;                                                      // Класс тепловой насос (в констукторе плохо проходит инициализация пинов????)
static devModbus Modbus;                                                 // Класс модбас - управление инвертором
SdFat card;                                                              // Карта памяти
#ifdef NEXTION   
Nextion myNextion;                                                     // Дисплей
#endif

// Use the Arduino core to set-up the unused USART2 on Serial4 (without serial events)
#ifdef USE_SERIAL4
RingBuffer rx_buffer5;
RingBuffer tx_buffer5;
USARTClass Serial4(USART2, USART2_IRQn, ID_USART2, &rx_buffer5, &tx_buffer5);
//void serialEvent4() __attribute__((weak));
//void serialEvent4() { }
void USART2_Handler(void)   // Interrupt handler for UART2
{
	Serial4.IrqHandler();     // In turn calls on the Serial2 interrupt handler
}
#endif

// Структура для хранения одного сокета, нужна для организации многопотоковой обработки
#define fABORT_SOCK   0                     // флаг прекращения передачи (произошел сброс сети)
#define fUser         1                     // Признак идентификации как обычный пользователь (нужно подменить файл меню)

struct type_socketData
  {
    EthernetClient client;                  // Клиент для работы с потоком
    byte inBuf[W5200_MAX_LEN];              // буфер для работы с w5200 (входной запрос)
    char *inPtr;                            // указатель в входном буфере с именем файла или запросом (копирование не делаем)
    char outBuf[3*W5200_MAX_LEN];           // буфер для формирования ответа на запрос и чтение с карты
    int8_t sock;                            // сокет потока -1 свободный сокет
    uint8_t flags;                          // Флаги состояния потока
    uint16_t http_req_type;                 // Тип запроса
  };
static type_socketData Socket[W5200_THREAD];   // Требует много памяти 4*W5200_MAX_LEN*W5200_THREAD=24 кб

// Установка вачдога таймера вариант vad711 - адаптация для DUE 1.6.11
// WDT_TIME период Watchdog таймера секунды но не более 16 секунд!!! ЕСЛИ WDT_TIME=0 то Watchdog будет отключен!!!
volatile unsigned long ulHighFrequencyTimerTicks;   // vad711 - адаптация для DUE 1.6.11
void watchdogSetup(void)
{
#if WDT_TIME == 0
	watchdogDisable();
#else 
	watchdogEnable(WDT_TIME * 1000);
#endif
}

__attribute__((always_inline)) inline void _delay(int t) // Функция задержки (мсек) в зависимости от шедулера задач FreeRtos
{
  if(xTaskGetSchedulerState() == taskSCHEDULER_RUNNING) vTaskDelay(t/portTICK_PERIOD_MS);
  else delay(t);
}

// Захватить семафор с проверкой, что шедуллер работает
BaseType_t SemaphoreTake(QueueHandle_t xSemaphore, TickType_t xBlockTime)
{
	if(xTaskGetSchedulerState() != taskSCHEDULER_RUNNING) return pdTRUE;
	else {
		for(;;) {
			if(xSemaphoreTake(xSemaphore, 0) == pdTRUE) return pdTRUE;
			if(!xBlockTime--) break;
			vTaskDelay(1/portTICK_PERIOD_MS);
		}
		return pdFALSE;
	}
}

// Освободить семафор с проверкой, что шедуллер работает
inline void SemaphoreGive(QueueHandle_t xSemaphore)
{
	if(xTaskGetSchedulerState() == taskSCHEDULER_RUNNING) xSemaphoreGive(xSemaphore);
}

// Остановить шедулер задач, возврат 1, если получилось
uint8_t TaskSuspendAll(void) {
	if(xTaskGetSchedulerState() == taskSCHEDULER_RUNNING) {
		vTaskSuspendAll(); // запрет других задач
		return 1;
	}
	return 0;
}

void vWeb0(void *) __attribute__((naked));
void vWeb1(void *) __attribute__((naked));
void vWeb2(void *) __attribute__((naked));
void vWeb3(void *) __attribute__((naked));
void vReadSensor(void *) __attribute__((naked));
void vUpdate( void * ) __attribute__((naked));
void vUpdateEEV(void *) __attribute__((naked));
void vUpdateStepperEEV(void *) __attribute__((naked));
void vUpdateCommand(void *) __attribute__((naked));
void vServiceHP(void *) __attribute__((naked));

void setup() {
	// 1. Инициализация
	// Баг разводки дуе (вероятность). Есть проблема с инициализацией spi.  Ручками прописываем
	// https://groups.google.com/a/arduino.cc/forum/#!topic/developers/0PUzlnr7948
	// http://forum.arduino.cc/index.php?topic=243778.0;nowap
	pinMode(PIN_SPI_SS0,INPUT_PULLUP);          // Eth Pin 77
	pinMode(PIN_SPI_SS1,INPUT_PULLUP);          // SD Pin  87
	pinMode(PIN_SPI_CS_SD,INPUT_PULLUP);        // сигнал CS управление SD картой
	pinMode(PIN_SPI_CS_W5XXX,INPUT_PULLUP);     // сигнал CS управление сетевым чипом

#ifdef SPI_FLASH
	pinMode(PIN_SPI_CS_FLASH,INPUT_PULLUP);     // сигнал CS управление чипом флеш памяти
	pinMode(PIN_SPI_CS_FLASH,OUTPUT);           // сигнал CS управление чипом флеш памяти
#endif
	SPI_switchAllOFF();                         // Выключить все устройства на SPI
	// Отключить питание (VUSB) на Native USB
	Set_bits(UOTGHS->UOTGHS_CTRL, UOTGHS_CTRL_VBUSHWC);
	PIO_Configure(PIOB, PIO_OUTPUT_0, PIO_PB10A_UOTGVBOF, PIO_DEFAULT);
	PIOB->PIO_CODR = PIO_PB10A_UOTGVBOF; // =0
	//

#ifdef POWER_CONTROL                        // Включение питания платы если необходимо НАДП здесь, иначе I2C память рабоать не будет
	pinMode(PIN_POWER_ON,OUTPUT);
	digitalWriteDirect(PIN_POWER_ON, LOW);
#endif

	// Борьба с зависшими устройствами на шине  I2C (в первую очередь часы) неудачный сброс
	Recover_I2C_bus();
	delay(1);

	// Настройка сервисных выводов
	pinMode(PIN_KEY1, INPUT_PULLUP);        // Кнопка 1
	pinMode(PIN_BEEP, OUTPUT);              // Выход на пищалку
	pinMode(PIN_LED_OK, OUTPUT);            // Выход на светодиод мигает 0.5 герца - ОК  с частотой 2 герца ошибка
	digitalWriteDirect(PIN_BEEP,LOW);       // Выключить пищалку
	digitalWriteDirect(PIN_LED_OK,HIGH);    // Выключить светодиод

	// 2. Инициализация журнала
	uint8_t b;
	uint8_t ret = eepromI2C.read(I2C_COUNT_EEPROM, &b, 1);
	if(ret == 0 && b != I2C_COUNT_EEPROM_HEADER && b != 0xFF) ret = 0xFF;
#ifndef DEBUG
	if(ret)
#endif
#ifndef DEBUG_NATIVE_USB
	SerialDbg.begin(UART_SPEED);                   // Если надо инициализировать отладочный порт
#endif
	while(ret) {
		SerialDbg.print("Wrong I2C EEPROM or setup, press KEY[D");
		SerialDbg.print(PIN_KEY1);
		SerialDbg.println("] to continue...");
		if(!digitalReadDirect(PIN_KEY1)) {
			WDT_Restart(WDT);
			b = I2C_COUNT_EEPROM_HEADER;
			ret = eepromI2C.write(I2C_COUNT_EEPROM, &b, 1);
			if(ret) {
				SerialDbg.print("Error ");
				SerialDbg.print(ret);
				SerialDbg.println(" write to EEPROM!");
			} else SerialDbg.println("Wait...");
			while(1) ;
		}
		for(uint8_t i = 0; i < 1000 / TIME_LED_ERR; i++) {
			digitalWriteDirect(PIN_BEEP, i & 1);
			digitalWriteDirect(PIN_LED_OK, i & 1);
			delay(TIME_LED_ERR);
		}
	}
	journal.Init();
#ifdef POWER_CONTROL
	delay(200);  // Не понятно но без нее иногда на старте срабатывает вачдог.  возможно проблема с буфером
#endif
#ifdef DEMO
	journal.jprintf("DEMO - DEMO - DEMO - DEMO - DEMO - DEMO - DEMO\n");
#endif
#ifdef TEST_BOARD
	journal.jprintf("\n---> TEST BOARD!!!\n\n");
#endif
	journal.jprintf("Firmware version: %s\n",VERSION);
	showID();                                                                  // информация о чипе
	getIDchip((char*)Socket[0].inBuf);
	journal.jprintf("Chip ID SAM3X8E: %s\n", Socket[0].inBuf);// информация об серийном номере чипа
	if(GPBR->SYS_GPBR[0] & 0x80000000) GPBR->SYS_GPBR[0] = 0; else GPBR->SYS_GPBR[0] |= 0x80000000; // очистка старой причины
	lastErrorFreeRtosCode = GPBR->SYS_GPBR[0] & 0x7FFFFFFF;         // Сохранение кода ошибки при страте (причину перегрузки)
	journal.jprintf("Last reason for reset SAM3x: %s\n", ResetCause());
	journal.jprintf("Last FreeRTOS task + error: 0x%04x", lastErrorFreeRtosCode);
	if(GPBR->SYS_GPBR[4]) journal.jprintf(" (%d)", GPBR->SYS_GPBR[4]);
	if(GPBR->SYS_GPBR[5]) journal.jprintf(" Web(%d)", GPBR->SYS_GPBR[5]);
	journal.jprintf("\n");

#ifdef PIN_LED1                            // Включение (точнее индикация) питания платы если необходимо
	pinMode(PIN_LED1,OUTPUT);
	digitalWriteDirect(PIN_LED1, HIGH);
#endif
#ifdef POWER_CONTROL
	journal.jprintf("Power +5V, +3.3V on board: ON\n");
#endif

	SupplyMonitorON(SUPC_SMMR_SMTH_3_0V);           // включение монитора питания

#ifdef DRV_EEV_L9333                     // Контроль за работой драйвера ЭРВ
	pinMode(PIN_STEP_DIAG,INPUT_PULLUP);
	journal.jprintf("Control EEV driver L9333: ON \n");
#endif

#ifdef RADIO_SENSORS
	RADIO_SENSORS_SERIAL.begin(RADIO_SENSORS_PSPEED, RADIO_SENSORS_PCONFIG);
#endif

	// 3. Инициализация и проверка шины i2c
	journal.jprintf("1. Setting and checking I2C devices . . .\n");

	uint8_t eepStatus=0;
#ifdef I2C_EEPROM_64KB
	if(journal.get_err()) { // I2C память и журнал в ней уже пытались инициализировать
#endif
		Wire.begin();
		for(uint8_t i=0; i<I2C_NUM_INIT; i++ )
		{
			if ((eepStatus=eepromI2C.begin(I2C_SPEED))>0)    // переходим на I2C_SPEED и пытаемся инициализировать
			{
				journal.jprintf("$ERROR - I2C mem failed, status = %d\n", eepStatus);
#ifdef POWER_CONTROL
				digitalWriteDirect(PIN_POWER_ON, HIGH);
				digitalWriteDirect(PIN_LED1, LOW);
				_delay(2000);
				digitalWriteDirect(PIN_POWER_ON, LOW);
				digitalWriteDirect(PIN_LED1, HIGH);
				_delay(500);
				Wire.begin();
#else
				Wire.begin();
				_delay(500);
#endif
				WDT_Restart(WDT);                       // Сбросить вачдог
			}  else break;   // Все хорошо
		} // for
#ifdef I2C_EEPROM_64KB
	}
#endif
	if(eepStatus)  // если I2C память не инициализирована, делаем попытку запустится на малой частоте один раз!
	{
		if((eepStatus=eepromI2C.begin(twiClock100kHz))>0) {
			journal.jprintf("$ERROR - I2C mem init failed on speed %d kHz, status = %d\n",twiClock100kHz/1000,eepStatus);
			eepromI2C.begin(I2C_SPEED);
			goto x_I2C_init_std_message;
		} else journal.jprintf("I2C bus low speed, init on %d kHz - OK\n",twiClock100kHz/1000);
	} else {
x_I2C_init_std_message:
		journal.jprintf("I2C init on %d kHz - OK\n",I2C_SPEED/1000);
	}

	// Сканирование шины i2c
	//    if (eepStatus==0)   // есть инициализация
	{
		byte error, address;
		const byte start_address = 8;       // lower addresses are reserved to prevent conflicts with other protocols
		const byte end_address = 119;       // higher addresses unlock other modes, like 10-bit addressing

		for(address = start_address; address < end_address; address++ )
		{
#ifdef ONEWIRE_DS2482         // если есть мост
			if(address == I2C_ADR_DS2482) {
				error = OneWireBus.Init();
#ifdef ONEWIRE_DS2482_SECOND
			} else if(address == I2C_ADR_DS2482_2) {
				error = OneWireBus2.Init();
#endif
#ifdef ONEWIRE_DS2482_THIRD
			} else if(address == I2C_ADR_DS2482_3) {
				error = OneWireBus3.Init();
#endif
#ifdef ONEWIRE_DS2482_FOURTH
			} else if(address == I2C_ADR_DS2482_4) {
				error = OneWireBus4.Init();
#endif
			} else
#endif
			{
				Wire.beginTransmission(address); error = Wire.endTransmission();
			}
			if(error==0)
			{
				journal.jprintf("I2C device found at address %s",byteToHex(address));
				switch (address)
				{
#ifdef ONEWIRE_DS2482
				case I2C_ADR_DS2482_4:
				case I2C_ADR_DS2482_3:
				case I2C_ADR_DS2482_2:
				case I2C_ADR_DS2482:  		journal.jprintf(" - OneWire DS2482-100 bus: %d%s\n", address - I2C_ADR_DS2482 + 1, (ONEWIRE_2WAY & (1<<(address - I2C_ADR_DS2482))) ? " (2W)" : ""); break;
#endif
#if I2C_FRAM_MEMORY == 1
				case I2C_ADR_EEPROM:	journal.jprintf(" - FRAM FM24V%02d\n", I2C_MEMORY_TOTAL*10/1024); break;
#if I2C_MEMORY_TOTAL != I2C_SIZE_EEPROM
				case I2C_ADR_EEPROM+1:	journal.jprintf(" - FRAM second 64k page\n"); break;
#endif
#else
				case I2C_ADR_EEPROM:	journal.jprintf(" - EEPROM AT24C%d\n", I2C_SIZE_EEPROM);break; // 0x50 возможны варианты
#if I2C_MEMORY_TOTAL != I2C_SIZE_EEPROM
				case I2C_ADR_EEPROM+1:	journal.jprintf(" - EEPROM second 64k page\n"); break;
#endif
#endif
				case I2C_ADR_RTC   :		journal.jprintf(" - RTC DS3231\n"); break; // 0x68
				default            :		journal.jprintf(" - Unknow\n"); break; // не определенный тип
				}
				_delay(100);
			}
			//    else journal.jprintf("I2C device bad endTransmission at address %s code %d",byteToHex(address), error);
		} // for
	} //  (eepStatus==0)

#ifndef ONEWIRE_DS2482         // если нет моста
	if(OneWireBus.Init()) journal.jprintf("Error init 1-Wire: %d\n", OneWireBus.GetLastErr());
	else journal.jprintf("1-Wire init Ok\n");
#endif

#ifdef RADIO_SENSORS
	check_radio_sensors();
	if(rs_serial_flag == RS_SEND_RESPONSE) {
		_delay(5);
		check_radio_sensors();
	}
#endif

#ifdef USE_SERIAL4
	PIO_Configure(PIOB, PIO_PERIPH_A, PIO_PB20A_TXD2 | PIO_PB21A_RXD2, PIO_DEFAULT);
	//Serial4.begin(115200);
#endif

	// 4. Инициализировать основной класс
	journal.jprintf("2. Init %s main class . . .\n",(char*)nameHeatPump);
	HP.initHeatPump();                           // Основной класс

	// 5. Проверка сброса сети
	// Нажатие при включении - режим safeNetwork (настрока сети по умолчанию 192.168.0.177  шлюз 192.168.0.1, не спрашивает пароль на вход в веб морду)
	journal.jprintf("3. Read safe Network key . . .\n");
	HP.safeNetwork = !digitalReadDirect(PIN_KEY1);
	journal.jprintf(" Mode safeNetwork %s\n", HP.safeNetwork ? "ON" : "OFF");

	// 6. Чтение ЕЕПРОМ, надо раньше чем инициализация носителей веб морды, что бы знать откуда грузить
	journal.jprintf("4. Load data from I2C memory . . .\n");
	if(HP.load_motoHour()==ERR_HEADER2_EEPROM)           // Загрузить счетчики ТН,
	{
		journal.jprintf(" I2C memory is empty, a default settings will be used!\n");
		HP.save_motoHour();
	} else {
		HP.load((uint8_t *)Socket[0].outBuf, 0);      // Загрузить настройки ТН
		HP.Schdlr.load();							// Загрузка настроек расписания
		HP.Prof.convert_to_new_version();
		if(HP.Prof.load(HP.Option.numProf) < 0) journal.jprintf(" Error load profile #%d\n", HP.Option.numProf); // Загрузка текущего профиля
		if(HP.Option.ver <= 133) {
			HP.save();
		}
	}
	// обновить хеш для пользователей
	HP.set_hashUser();
	HP.set_hashAdmin();

	// 7. Инициализация СД карты и запоминание результата 3 попытки
#ifndef NO_SD_CARD
	journal.jprintf("5. Init SD card . . .\n");
	HP.set_fSD(initSD());
	WDT_Restart(WDT);                          // Сбросить вачдог  иногда карта долго инициализируется
#else
	journal.jprintf("5. No SD card in config.\n");
#endif

	// 8. Инициализация spi флеш диска
#ifdef SPI_FLASH
	journal.jprintf("6. Init SPI flash disk . . .\n");
	HP.set_fSPIFlash(initSpiDisk(true));  // проверка диска с выводом инфо
#else
	journal.jprintf("6. No SPI flash in config.\n");
#endif
	digitalWriteDirect(PIN_LED_OK, LOW);        // Включить светодиод

	//  HP.set_optionHP((char*)option_WebOnSPIFlash,0);  // Установить принудительно загрузку морды с карточки (надо раскоментировать если грузится из флеш не надо)
	journal.jprintf("Web interface source: ");
	switch (HP.get_SourceWeb())
	{
	case pMIN_WEB:   journal.jprintf("internal\n"); break;
	case pSD_WEB:    journal.jprintf("SD card\n"); break;
	case pFLASH_WEB: journal.jprintf("SPI Flash\n"); break;
	default:         journal.jprintf("unknown\n"); break;
	}

	journal.jprintf("7. Start read ADC sensors\n");
	//journal.jprintf("Temperature SAM3X8E: %.2f\n", temp_DUE());
	start_ADC(); // после инициализации HP
	//journal.jprintf(" Mask ADC_IMR: 0x%08x\n",ADC->ADC_IMR);

	// 10. Сетевые настройки
	journal.jprintf("8. Setting Network . . .\n");
	if(initW5200(true)) {   // Инициализация сети с выводом инфы в консоль
		W5100.getMACAddress((uint8_t *)Socket[0].outBuf);
		journal.jprintf(" MAC: %s\n", MAC2String((uint8_t *)Socket[0].outBuf));
	}
	digitalWriteDirect(PIN_BEEP,LOW);          // Выключить пищалку

	// 11. Разбираемся со всеми часами и синхронизацией
	journal.jprintf("9. Setting time and clock . . .\n");
	set_time();

	// 12. Инициалазация уведомлений
	journal.jprintf("10. Message update IP from DNS . . .\n");
	HP.message.dnsUpdate();

	// 13. Инициалазация MQTT
#ifdef MQTT
	journal.jprintf("11. Client MQTT update IP from DNS . . .\n");
	HP.clMQTT.dnsUpdate();
#else
	journal.jprintf("11. Client MQTT disabled by config\n");
#endif

	// 14. Инициалазация Statistics
	journal.jprintf("12. Statistics ");
	if(HP.get_fSD()) {
		journal.jprintf("writing on SD card\n");
		Stats.Init();             // Инициализовать статистику
	} else journal.jprintf("not available\n");

	int8_t _profile = HP.Schdlr.calc_active_profile();
	if(_profile > SCHDLR_Profile_off && _profile != HP.Prof.get_idProfile()) {
		HP.Prof.load(_profile);
		HP.set_profile();
		journal.jprintf("Profile changed to #%d\n", _profile);
	}

	if(HP.get_SaveON()==0)  HP.set_HP_OFF();    // Сбросить флаг включение ТН если стоит соответсвующий флаг в опциях
	journal.jprintf("13. Delayed start %s: ",(char*)nameHeatPump); if(HP.get_HP_ON()) journal.jprintf("YES\n"); else journal.jprintf("NO\n");

#ifdef NEXTION
	journal.jprintf("14. Nextion display: ");
	if(GETBIT(HP.Option.flags, fNextion)) {
		myNextion.init();
	} else {
		journal.jprintf(" Disabled\n");
	}
#else
	journal.jprintf("14. Nextion display is absent in config\n");
#endif

#ifdef TEST_BOARD
	// Scan oneWire - TEST.
	//HP.scan_OneWire(Socket[0].outBuf);
#endif

	// Создание задач FreeRTOS  ----------------------
	journal.jprintf("15. Create tasks FreeRTOS . . .\n");
	HP.mRTOS=236;  //расчет памяти для задач 236 - размер данных шедуллера, каждая задача требует 64 байта+ стек (он в словах!!)
	HP.mRTOS=HP.mRTOS+64+4*configMINIMAL_STACK_SIZE;  // задача бездействия
	//HP.mRTOS=HP.mRTOS+4*configTIMER_TASK_STACK_DEPTH;  // программные таймера (их теперь нет)

	// ПРИОРИТЕТ 4 Высший приоритет датчики читаются всегда и шаговик ЭРВ всегда шагает если нужно
	if (xTaskCreate(vReadSensor,"ReadSensor",140,NULL,4,&HP.xHandleReadSensor)==errCOULD_NOT_ALLOCATE_REQUIRED_MEMORY)    set_Error(ERR_MEM_FREERTOS,(char*)nameFREERTOS);
	HP.mRTOS=HP.mRTOS+64+4*140;// 200, до обрезки стеков было 300

#ifdef EEV_DEF
	if (xTaskCreate(vUpdateStepperEEV,"StepperEEV",40,NULL,4,&HP.dEEV.stepperEEV.xHandleStepperEEV)==errCOULD_NOT_ALLOCATE_REQUIRED_MEMORY)  set_Error(ERR_MEM_FREERTOS,(char*)nameFREERTOS);
	HP.mRTOS=HP.mRTOS+64+4*40; // 50, 100, 150, до обрезки стеков было 200
	vTaskSuspend(HP.dEEV.stepperEEV.xHandleStepperEEV);                                 // Остановить задачу
	HP.dEEV.stepperEEV.xCommandQueue = xQueueCreate( EEV_QUEUE, sizeof( int ) );  // Создать очередь комманд для ЭРВ
#endif

	// ПРИОРИТЕТ 3 Очень высокий приоритет Выполнение команд управления (разбор очереди комманд) - должен быть выше чем задачи обновления ТН и ЭРВ
	if(xTaskCreate(vUpdateCommand,"CommandHP", 150,NULL,3,&HP.xHandleUpdateCommand)==errCOULD_NOT_ALLOCATE_REQUIRED_MEMORY)     set_Error(ERR_MEM_FREERTOS,(char*)nameFREERTOS);
	HP.mRTOS=HP.mRTOS+64+4*150;// 200, до обрезки стеков было 300
	vTaskSuspend(HP.xHandleUpdateCommand);      // Остановить задачу разбор очереди комнад


	// ПРИОРИТЕТ 2 высокий - это управление ТН управление ЭРВ, сервис
	if(xTaskCreate(vServiceHP, "ServiceHP", STACK_vUpdateCommand, NULL, 2, &HP.xHandleSericeHP)==errCOULD_NOT_ALLOCATE_REQUIRED_MEMORY) set_Error(ERR_MEM_FREERTOS,(char*)nameFREERTOS);
	HP.mRTOS=HP.mRTOS+64+4*STACK_vUpdateCommand;// 200, до обрезки стеков было 300

	vSemaphoreCreateBinary(HP.xCommandSemaphore);                       // Создание семафора
	if (HP.xCommandSemaphore==NULL) set_Error(ERR_MEM_FREERTOS,(char*)nameFREERTOS);

	if (xTaskCreate(vUpdate,"UpdateHP",160,NULL,2,&HP.xHandleUpdate)==errCOULD_NOT_ALLOCATE_REQUIRED_MEMORY)    set_Error(ERR_MEM_FREERTOS,(char*)nameFREERTOS);
	HP.mRTOS=HP.mRTOS+64+4*160;// 200, до обрезки стеков было 350
	vTaskSuspend(HP.xHandleUpdate);                                 // Остановить задачу обновление ТН
	HP.Task_vUpdate_run = false;

#ifdef EEV_DEF
	if (xTaskCreate(vUpdateEEV,"UpdateEEV",100,NULL,2,&HP.xHandleUpdateEEV)==errCOULD_NOT_ALLOCATE_REQUIRED_MEMORY)     set_Error(ERR_MEM_FREERTOS,(char*)nameFREERTOS);
	HP.mRTOS=HP.mRTOS+64+4*100;
	vTaskSuspend(HP.xHandleUpdateEEV);                              // Остановить задачу обновление EEV
#endif  

	// ПРИОРИТЕТ 1 средний - обслуживание вебморды в несколько потоков и дисплея Nextion
	// ВНИМАНИЕ первый поток должен иметь больший стек для обработки фоновых сетевых задач
	// 1 - поток
	if ( xTaskCreate(vWeb0,"Web0", STACK_vWebX+14,NULL,1,&HP.xHandleUpdateWeb0)==errCOULD_NOT_ALLOCATE_REQUIRED_MEMORY) set_Error(ERR_MEM_FREERTOS,(char*)nameFREERTOS);
	HP.mRTOS=HP.mRTOS+64+4*(STACK_vWebX+14);
#if W5200_THREAD >= 2 // - потока
	if ( xTaskCreate(vWeb1,"Web1", STACK_vWebX,NULL,1,&HP.xHandleUpdateWeb1)==errCOULD_NOT_ALLOCATE_REQUIRED_MEMORY) set_Error(ERR_MEM_FREERTOS,(char*)nameFREERTOS);
	HP.mRTOS=HP.mRTOS+64+4*STACK_vWebX;
#endif
#if W5200_THREAD >= 3 // - потока
	if ( xTaskCreate(vWeb2,"Web2", STACK_vWebX,NULL,1,&HP.xHandleUpdateWeb2)==errCOULD_NOT_ALLOCATE_REQUIRED_MEMORY) set_Error(ERR_MEM_FREERTOS,(char*)nameFREERTOS);
	HP.mRTOS=HP.mRTOS+64+4*STACK_vWebX;
#endif
#if W5200_THREAD >= 4 // - потока
	if ( xTaskCreate(vWeb3,"Web3", STACK_vWebX,NULL,1,&HP.xHandleUpdateWeb3)==errCOULD_NOT_ALLOCATE_REQUIRED_MEMORY) set_Error(ERR_MEM_FREERTOS,(char*)nameFREERTOS);
	HP.mRTOS=HP.mRTOS+64+4*STACK_vWebX;
#endif
	vSemaphoreCreateBinary(xLoadingWebSemaphore);           // Создание семафора загрузки веб морды в spi память
	if (xLoadingWebSemaphore==NULL) set_Error(ERR_MEM_FREERTOS,(char*)nameFREERTOS);
	//xLoadingWebMutex=xSemaphoreCreateMutex();

	vSemaphoreCreateBinary(xWebThreadSemaphore);               // Создание мютекса
	if (xWebThreadSemaphore==NULL) set_Error(ERR_MEM_FREERTOS,(char*)nameFREERTOS);
	vSemaphoreCreateBinary(xI2CSemaphore);                     // Создание мютекса
	if (xI2CSemaphore==NULL) set_Error(ERR_MEM_FREERTOS,(char*)nameFREERTOS);
	//vSemaphoreCreateBinary(xSPISemaphore);                     // Создание мютекса
	//if (xSPISemaphore==NULL) set_Error(ERR_MEM_FREERTOS,(char*)nameFREERTOS);
	// Дополнительные семафоры (почему то именно здесь) Создается когда есть модбас
	if(Modbus.get_present())
	{
		vSemaphoreCreateBinary(xModbusSemaphore);                       // Создание мютекса
		if (xModbusSemaphore==NULL) set_Error(ERR_MEM_FREERTOS,(char*)nameFREERTOS);
	}

	journal.jprintf(" Create tasks - OK, size %d bytes\n",HP.mRTOS);

	if(HP.get_HP_ON()>0)  HP.sendCommand(pRESTART);  // если надо запустить ТН - отложенный старт

	//journal.jprintf("16. Send a notification . . .\n");
	//HP.message.setMessage(pMESSAGE_RESET,(char*)"Контроллер теплового насоса был сброшен",0);    // сформировать уведомление о сбросе контролла
	journal.jprintf("17. Information:\n");
	freeRamShow();
	HP.startRAM=freeRam()-HP.mRTOS;   // оценка свободной памяти до пуска шедулера, поправка на 1054 байта
	journal.jprintf("FREE MEMORY %d bytes\n",HP.startRAM);
	journal.jprintf("Temperature DS2331: %.2d\n",getTemp_RtcI2C());
	if(Is_otg_vbus_high()) journal.jprintf("USB connected\n");
	//HP.Stat.generate_TestData(STAT_POINT); // Сгенерировать статистику STAT_POINT точек только тестирование
	journal.jprintf("Start FreeRTOS scheduler :-))\n");
	journal.jprintf("READY ----------------------\n");
	eepromI2C.use_RTOS_delay = 1;       //vad711
	//
	vTaskStartScheduler();              // СТАРТ !!
	journal.jprintf("FreeRTOS FAILURE!\n");
}

void loop() {}

//  З А Д А Ч И -------------------------------------------------
// Это и есть поток с минимальным приоритетом измеряем простой процессора
//extern "C" 
//{
static bool Error_Beep_confirmed = false;

extern "C" void vApplicationIdleHook(void)  // FreeRTOS expects C linkage
{
	static unsigned long countLED = 0;
	static unsigned long countBeep = 0;

	WDT_Restart(WDT);                                                            // Сбросить вачдог
	register unsigned long ticks = GetTickCount();
//	static unsigned long cpu_idle_max_count = 0; // 1566594 // максимальное значение счетчика, вычисляется при калибровке и соответствует 100% CPU idle
//	static unsigned long ulIdleCycleCount = 0;
//	ulIdleCycleCount++;                                                          // приращение счетчика
//	if(ticks - countLastTick >= 3000)		// мсек
//	{
//		countLastTick = ticks;                            // расчет нагрузки
//		if(ulIdleCycleCount > cpu_idle_max_count) cpu_idle_max_count = ulIdleCycleCount; // это калибровка запоминаем максимальные значения
//		HP.CPU_IDLE = (100 * ulIdleCycleCount) / cpu_idle_max_count;              // вычисляем текущую загрузку
//		ulIdleCycleCount = 0;
//	}
	// Светодиод мигание в зависимости от ошибки и подача звукового сигнала при ошибке
	if(HP.get_errcode() != OK) {          // Ошибка
		if(ticks - countLED > TIME_LED_ERR) {
			digitalWriteDirect(PIN_LED_OK, !digitalReadDirect(PIN_LED_OK));
			countLED = ticks;
		}
		if(HP.get_Beep() && !Error_Beep_confirmed && ticks - countBeep > TIME_BEEP_ERR) {
			digitalWriteDirect(PIN_BEEP, !digitalReadDirect(PIN_BEEP)); // звуковой сигнал
			countBeep = ticks;
		}
	} else if(ticks - countLED > TIME_LED_OK) {   // Ошибок нет и время пришло
		Error_Beep_confirmed = false;
		digitalWriteDirect(PIN_BEEP, LOW);
		digitalWriteDirect(PIN_LED_OK, !digitalReadDirect(PIN_LED_OK));
		countLED = ticks;
	}
	pmc_enable_sleepmode(0);
}

// --------------------------- W E B ------------------------
// Задача обслуживания web сервера
// Сюда надо пихать все что связано с сетью иначе конфликты не избежны
// Здесь также обслуживается посылка уведомлений MQTT
// Первый поток веб сервера - дополнительно нагружен различными сервисами
void vWeb0(void *)
{ //const char *pcTaskName = "Web server is running\r\n";
	static unsigned long timeResetW5200 = 0;
	static unsigned long thisTime;
	static unsigned long resW5200 = 0;
	static unsigned long iniW5200 = 0;
	static unsigned long pingt = 0;
#ifdef MQTT
	static unsigned long narmont=0;
	static unsigned long mqttt=0;
#endif
	static boolean active = false;  // ФЛАГ Одно дополнительное действие за один цикл - распределяем нагрузку, если действие проделано то active = false и новый цикл
	static boolean network_last_link = true;

	HP.timeNTP = thisTime = xTaskGetTickCount();        // В первый момент не обновляем
	for(;;)
	{
		WEB_STORE_DEBUG_INFO(1);
		web_server(MAIN_WEB_TASK);
		WEB_STORE_DEBUG_INFO(2);
		active = true;                                                         // Можно работать в этом цикле (дополнительная нагрузка на поток)
		vTaskDelay(TIME_WEB_SERVER / portTICK_PERIOD_MS); // задержка чтения уменьшаем загрузку процессора

		// СЕРВИС: Этот поток работает на любых настройках, по этому сюда ставим работу с сетью
		HP.message.sendMessage();                                            // Отработать отсылку сообщений (внутри скрыта задержка после включения)
		active = HP.message.dnsUpdate();                                     // Обновить адреса через dns если надо, dnsUpdate() возвращает true если обновления не было
#ifdef MQTT
		if(active) active=HP.clMQTT.dnsUpdate();                             // Обновить адреса через dns если надо для MQTT если обновления не было то возвращает true
#endif
		if(xTaskGetTickCount() - thisTime > WEB0_OTHER_JOB_PERIOD)
		{
			thisTime = xTaskGetTickCount();                                      // Запомнить тики
			// 1. Проверка захваченого семафора сети ожидаем  3 времен W5200_TIME_WAIT если мютекса не получаем то сбрасывае мютекс
			if(SemaphoreTake(xWebThreadSemaphore, ((3 + (fWebUploadingFilesTo != 0) * 30) * W5200_TIME_WAIT / portTICK_PERIOD_MS)) == pdFALSE) {
				SemaphoreGive(xWebThreadSemaphore);
				journal.jprintf_time("UNLOCK mutex xWebThread\n");
				active = false;
				HP.num_resMutexSPI++;
			} // Захват мютекса SPI или ОЖИДАНИНЕ 2 времен W5200_TIME_WAIT и его освобождение
			else SemaphoreGive(xWebThreadSemaphore);

			// Проверка и сброс митекса шины I2C  если мютекса не получаем то сбрасывае мютекс
			if(SemaphoreTake(xI2CSemaphore, (3 * I2C_TIME_WAIT / portTICK_PERIOD_MS)) == pdFALSE) {
				SemaphoreGive(xI2CSemaphore);
				journal.jprintf_time("UNLOCK mutex xI2CSemaphore\n");
				HP.num_resMutexI2C++;
			} // Захват мютекса I2C или ОЖИДАНИНЕ 3 времен I2C_TIME_WAIT  и его освобождение
			else SemaphoreGive(xI2CSemaphore);

			// 2. Чистка сокетов
			if(HP.time_socketRes() > 0) {
				WEB_STORE_DEBUG_INFO(3);
				checkSockStatus();                   // Почистить старые сокеты  если эта позиция включена
			}

			// 3. Сброс сетевого чипа по времени
			if((HP.time_resW5200() > 0) && (active))                             // Сброс W5200 если включен и время подошло
			{
				WEB_STORE_DEBUG_INFO(4);
				resW5200 = xTaskGetTickCount();
				if(timeResetW5200 == 0) timeResetW5200 = resW5200;      // Первая итерация не должна быть сразу
				if(resW5200 - timeResetW5200 > HP.time_resW5200() * 1000UL) {
					journal.jprintf_time("Reset %s by timer . . .\n", nameWiznet);
					HP.sendCommand(pNETWORK);                          // Послать команду сброса и применения сетевых настроек
					timeResetW5200 = resW5200;                         // Запомить время сброса
					active = false;
				}
			}
			// 4. Проверка связи с чипом
			if((HP.get_fInitW5200()) && (thisTime - iniW5200 > 60 * 1000UL) && (active)) // проверка связи с чипом сети раз в минуту
			{
				WEB_STORE_DEBUG_INFO(5);
				iniW5200 = thisTime;
				if(!HP.NO_Power) {
					boolean lst = linkStatusWiznet(false);
					if(!lst || !network_last_link) {
						if(!lst) journal.jprintf_time("%s no link[%02X], resetting . . .\n", nameWiznet, W5100.readPHYCFGR());
						HP.sendCommand(pNETWORK);       // Если связь потеряна то подать команду на сброс сетевого чипа
						HP.num_resW5200++;              // Добавить счетчик инициализаций
						active = false;
					}
					network_last_link = lst;
				}
			}
			// 5.Обновление времени 1 раз в сутки или по запросу (HP.timeNTP==0)
			if((HP.timeNTP == 0) || ((HP.get_updateNTP()) && (thisTime - HP.timeNTP > 60 * 60 * 24 * 1000UL) && (active))) // Обновление времени раз в день 60*60*24*1000 в тиках HP.timeNTP==0 признак принудительного обновления
			{
				WEB_STORE_DEBUG_INFO(6);
				HP.timeNTP = thisTime;
				set_time_NTP();                                                 // Обновить время
				active = false;
			}
			// 6. ping сервера если это необходимо
			if((HP.get_pingTime() > 0) && (thisTime - pingt > HP.get_pingTime() * 1000UL) && (active)) {
				WEB_STORE_DEBUG_INFO(7);
				pingt = thisTime;
				pingServer();
				active = false;
			}

#ifdef MQTT                                     // признак использования MQTT
			// 7. Отправка на народный мониторинг
			// Внеочередная отправка по кнопке из веб морды. Это ОТЛАДОЧНЫЙ режим - им пользуются, когда
			// показания не проходят, поэтому интервал здесь НЕ проверяется и жать кнопку можно подряд.
			// Ответственность за частоту на том, кто отлаживает: если с прошлой отправки не прошло
			// TIME_NARMON, сервер ответит INTERVAL...<5m, а за систематические злоупотребления банит прибор.
			// narmont все равно сдвигаем: иначе сразу за ручной отправкой могла бы уйти штатная, которую
			// никто не заказывал. На саму кнопку это не влияет.
			if ((HP.clMQTT.get_NarodMonUse())&&(HP.clMQTT.getTestNARMON())&&(active))
			{
				WEB_STORE_DEBUG_INFO(55);
				HP.clMQTT.clearTestNARMON();
				if(thisTime-narmont<=TIME_NARMON*1000UL) journal.jprintf_time("NarodMon test: less than %d sec since last send, expect INTERVAL error\n",TIME_NARMON);
				narmont=thisTime;
				sendNarodMon2022(true);          // с выводом пакета и ответа сервера в журнал
				active=false;
			}
			// Штатная отправка по времени
			if ((HP.clMQTT.get_NarodMonUse())&&(thisTime-narmont>TIME_NARMON*1000UL)&&(active))// если нужно & время отправки пришло
			{
				WEB_STORE_DEBUG_INFO(55);
			//	sendNarodMon(false);            // отладка выключена
				// Посылка данных на народный мониторинг без использования MQTT потребовалось в декабре 2022 года.
				// Если пакет не доставлен (нет связи или нет ответа) - протокол предписывает повторить отправку,
				// когда связь восстановится. Повторяем через NARMON_RETRY, но не чаще: иначе прибор попадет в бан.
				if(sendNarodMon2022(false)) narmont=thisTime;
				else narmont=thisTime-(TIME_NARMON-NARMON_RETRY)*1000UL;
				active=false;
			}  // if ((HP.clMQTT.get_NarodMonUse()))

			// 8. Отправка на MQTT сервер
			if ((HP.clMQTT.get_MqttUse())&&(thisTime-mqttt>HP.clMQTT.get_ttime()*1000UL)&&(active))// если нужно & время отправки пришло
			{
				WEB_STORE_DEBUG_INFO(56);
				mqttt=thisTime;
				if(HP.clMQTT.get_TSUse()) sendThingSpeak(false);
				else sendMQTT(false);
				active=false;
			}
#endif   // MQTT
			taskYIELD();
		} // if (xTaskGetTickCount()-thisTime>10000)

	} //for
	vTaskDelete( NULL);
}

// Второй поток
void vWeb1(void *)
{ //const char *pcTaskName = "Web server is running\r\n";
	for(;;) {
		web_server(1);
		vTaskDelay(TIME_WEB_SERVER / portTICK_PERIOD_MS); // задержка чтения уменьшаем загрузку процессора

	}
	vTaskDelete( NULL);
}
// Третий поток
void vWeb2(void *)
{ //const char *pcTaskName = "Web server is running\r\n";
	for(;;) {
		web_server(2);
		vTaskDelay(TIME_WEB_SERVER / portTICK_PERIOD_MS); // задержка чтения уменьшаем загрузку процессора

	}
	vTaskDelete( NULL);
}
// Четвертый поток
void vWeb3(void *)
{ //const char *pcTaskName = "Web server is running\r\n";
	for(;;) {
		web_server(3);
		vTaskDelay(TIME_WEB_SERVER / portTICK_PERIOD_MS); // задержка чтения уменьшаем загрузку процессора
	}
	vTaskDelete( NULL);
}

//////////////////////////////////////////////////////////////////////////
// Задача чтения датчиков
void vReadSensor(void *)
{ //const char *pcTaskName = "ReadSensor\r\n";
	static unsigned long readFC = 0;
#ifdef USE_ELECTROMETER_SDM
#if (SDM_READ_PERIOD > 0)
	static unsigned long readSDM = 0;
#endif
#endif
	static uint32_t ttime;
	static uint32_t oldTime = GetTickCount();
	static uint8_t  prtemp = 0;
	
	for(;;) {
		int8_t i;

		ttime = GetTickCount();
#ifdef RADIO_SENSORS		
		radio_timecnt++;
#endif		
		if(OW_scan_flags == 0) {
#ifndef DEMO  // Если не демо
			prtemp = HP.Prepare_Temp(0);
#ifdef ONEWIRE_DS2482_SECOND
			prtemp |= HP.Prepare_Temp(1);
#endif
#ifdef ONEWIRE_DS2482_THIRD
			prtemp |= HP.Prepare_Temp(2);
#endif
#ifdef ONEWIRE_DS2482_FOURTH
			prtemp |= HP.Prepare_Temp(3);
#endif
#endif     // не DEMO
		}
		for(i = 0; i < ANUMBER; i++) HP.sADC[i].Read();                  // Прочитать данные с датчиков давления
		for(i = 0; i < INUMBER; i++) HP.sInput[i].Read();                // Прочитать данные сухой контакт
#ifdef SGENERATOR
		if(GETBIT(HP.Option.flags2, f2BackupPowerAuto)) HP.check_fBackupPower();
#endif
		for(i = 0; i < FNUMBER; i++) HP.sFrequency[i].Read();			// Получить значения датчиков потока

#ifdef USE_ELECTROMETER_SDM   // Опрос состояния счетчика
		  HP.dSDM.get_readState(0); // Основная группа регистров
#endif

		vReadSensor_delay1ms(cDELAY_DS1820 - (int32_t)(GetTickCount() - ttime)); 	// Ожидать время преобразования

		if(OW_scan_flags == 0) {
			uint8_t flags = 0;
			for(i = 0; i < TNUMBER; i++) {                                   // Прочитать данные с температурных датчиков
				if((prtemp & (1<<HP.sTemp[i].get_bus())) == 0) {
					if(HP.sTemp[i].Read() == OK) flags |= HP.sTemp[i].get_setup_flags();
				}
				_delay(1);     												// пауза
			}
			int32_t temp;
			if(GETBIT(flags, fTEMP_as_TIN_average)) { // Расчет средних датчиков для TIN
				temp = 0;
				uint8_t cnt = 0;
				for(i = 0; i < TNUMBER; i++) {
					if(HP.sTemp[i].get_setup_flag(fTEMP_as_TIN_average) && HP.sTemp[i].get_Temp() != STARTTEMP) {
						temp += HP.sTemp[i].get_Temp();
						cnt++;
					}
				}
				if(cnt) temp /= cnt; else temp = STARTTEMP;
			} else temp = STARTTEMP;
			int16_t temp2 = temp;
			if(GETBIT(flags, fTEMP_as_TIN_min)) { // Выбор минимальной температуры для TIN
				for(i = 0; i < TNUMBER; i++) {
					if(HP.sTemp[i].get_setup_flag(fTEMP_as_TIN_min) && temp2 > HP.sTemp[i].get_Temp()) temp2 = HP.sTemp[i].get_Temp();
				}
			}
			if(temp2 != STARTTEMP) HP.sTemp[TIN].set_Temp(temp2);
		}

#ifdef USE_ELECTROMETER_SDM   // Опрос состояния счетчика
#if (SDM_READ_PERIOD > 0)
			if((HP.dSDM.get_present()) && (GetTickCount() - readSDM > SDM_READ_PERIOD)) {
				readSDM=GetTickCount();
				HP.dSDM.get_readState(2);     // Последняя группа регистров ТОК
			}
#endif
#endif

		HP.calculatePower();  // Расчет мощностей и СОР
		Stats.Update();

		vReadSensor_delay1ms((TIME_READ_SENSOR - (int32_t)(GetTickCount() - ttime)) / 2);     // 1. Ожидать время нужное для цикла чтения

		// Вычисление перегрева используются РАЗНЫЕ датчики при нагреве и охлаждении
		// Режим работы определяется по состоянию четырехходового клапана при его отсутвии только нагрев
#ifdef EEV_DEF
		HP.dEEV.set_Overheat(HP.is_heating()); // нагрев(1) или охлаждение(0)
#endif

		//  Опрос состояния инвертора
	#ifdef USE_UPS
		if(!HP.NO_Power)
	#endif
			if((HP.dFC.get_present()) && (GetTickCount() - readFC > FC_TIME_READ)) {
				readFC = GetTickCount();
				HP.dFC.get_readState();
			}

#ifdef DRV_EEV_L9333  // Опрос состяния драйвера ЭРВ
		if (digitalReadDirect(PIN_STEP_DIAG)) // Перечитываем два раза
		{
			vReadSensor_delay1ms(5);
			if (digitalReadDirect(PIN_STEP_DIAG)) set_Error(ERR_DRV_EEV,(char*)__FUNCTION__); // Контроль за работой драйвера ЭРВ
		}
#endif

#ifdef FLOW_CONTROL                // если надо проверяем потоки (защита от отказа насосов) ERR_MIN_FLOW
	if(HP.is_compressor_on())      // Только если компрессор включен 
		for(uint8_t i = 0; i < FNUMBER; i++){   // Проверка потока по каждому датчику
		#ifdef SUPERBOILER   // Если определен супер бойлер
			#ifdef FLOWCON   // если определен датчик потока конденсатора
			   if ((i==FLOWCON)&&(!HP.dRelay[RPUMPO].get_Relay())) continue; // Для режима супербойлер есть вариант когда не будет протока по контуру отопления
			#endif
		#endif
			if(HP.sFrequency[i].get_checkFlow() && HP.sFrequency[i].get_Value() < HP.sFrequency[i].get_minValue()) {     // Поток меньше минимального ошибка осанавливаем ТН
				journal.jprintf("%s low flow: %.3f\n",(char*) HP.sFrequency[i].get_name(), (float) HP.sFrequency[i].get_Value() / 1000);
				set_Error(ERR_MIN_FLOW, (char*) HP.sFrequency[i].get_name());
			}
		}
#endif
#ifdef SEVA  //Если определен лепестковый датчик протока - это переливная схема ТН - надо контролировать проток при работе
 	if(HP.dRelay[RPUMPI].get_Relay())                                                                                             // Только если включен насос геоконтура  (PUMP_IN)
		if (HP.sInput[SEVA].get_Input()==SEVA_OFF) {set_Error(ERR_SEVA_FLOW,(char*)"SEVA"); return;}                              // Выход по ошибке отсутствия протока
#endif

		//  Синхронизация часов с I2C часами если стоит соответсвующий флаг
		if(HP.get_updateI2C())  // если надо обновить часы из I2c
		{
			if(GetTickCount() - oldTime > (uint32_t)TIME_I2C_UPDATE) // время пришло обновляться надо Период синхронизации внутренних часов с I2C часами (сек)
			{
				oldTime = rtcSAM3X8.unixtime();
				uint32_t t = TimeToUnixTime(getTime_RtcI2C());       // Прочитать время из часов i2c тут проблема
				if(t) {
					rtcSAM3X8.set_clock(t);                		 // Установить внутренние часы по i2c
					HP.updateDateTime(t > oldTime ? t - oldTime : -(oldTime - t));  // Обновить переменные времени с новым значением часов
					journal.jprintf((const char*) "Sync from I2C RTC: %s %s\n", NowDateToStr(), NowTimeToStr());
				} else {
					journal.jprintf("Error read I2C RTC\n");
				}
				oldTime = GetTickCount();
			}
		}
		// Проверка и сброс митекса шины I2C
//       if (SemaphoreTake(xI2CSemaphore,(3*I2C_TIME_WAIT/portTICK_PERIOD_MS))==pdFALSE) { SemaphoreGive(xI2CSemaphore);journal.jprintf("UNLOCK mutex xI2CSemaphore\n");  HP.num_resMutexI2C++;} // Захват мютекса I2C или ОЖИДАНИНЕ 3 времен I2C_TIME_WAIT  и его освобождение
//       else  SemaphoreGive(xI2CSemaphore);
		// Проверки граничных температур для уведомлений, если разрешено!
		static uint16_t countTEMP = 0;        // Для проверки критических температур для рассылки уведомлений
		if(HP.message.get_fMessageTemp()) {
			if(countTEMP > TIME_MESSAGE_TEMP) {
				countTEMP = 0;
				if(HP.message.get_mTIN() > HP.sTemp[TIN].get_Temp()) HP.message.setMessage(pMESSAGE_TEMP,
						(char*) "Критическая температура в доме,", HP.sTemp[TIN].get_Temp());
				if(HP.message.get_mTBOILER() > HP.sTemp[TBOILER].get_Temp()) HP.message.setMessage(pMESSAGE_TEMP,
						(char*) "Критическая температура ГВС,", HP.sTemp[TBOILER].get_Temp());
				if(HP.message.get_mTCOMP() < HP.sTemp[TCOMP].get_Temp()) HP.message.setMessage(pMESSAGE_TEMP,
						(char*) "Критическая температура компрессора,", HP.sTemp[TCOMP].get_Temp());
			} else countTEMP += TIME_READ_SENSOR / 100; // в 0.1 сек
		}
		static uint8_t last_life_h = 255;
		if(HP.message.get_fMessageLife()) // Подача сигнала жизни если разрешено!
		{
			uint8_t hour = rtcSAM3X8.get_hours();
			if(hour == HOUR_SIGNAL_LIFE && hour != last_life_h) {
				HP.message.setMessage(pMESSAGE_LIFE, (char*) "Контроллер работает . . .", 0);
			}
			last_life_h = hour;
		}
		//
		vReadSensor_delay1ms(TIME_READ_SENSOR - (int32_t)(GetTickCount() - ttime));     // Ожидать время нужное для цикла чтения

	}  // for
	vTaskDelete( NULL);
}

// Вызывается во время задержек в задаче чтения датчиков
void vReadSensor_delay1ms(int32_t ms)
{
	if(ms <= 0) return;
	if(ms < 10) {
		vTaskDelay(ms);
		return;
	}
	ms -= 10;
	uint32_t tm = GetTickCount();
	do {
#ifdef  KEY_ON_OFF // Если надо проверяем кнопку включения ТН
		static uint8_t key_debounce = 0;                              // кнопка вкл/вкл дребезг подавление
		if(!digitalReadDirect(PIN_KEY1)) {
			if(!key_debounce) {
				journal.jprintf("ON/OFF Key pressed!\n");
				if(HP.get_errcode() && !Error_Beep_confirmed) {
					Error_Beep_confirmed = true;
				} else if(HP.get_State() == pOFF_HP) {
					HP.sendCommand(pSTART);
				} else if((HP.get_State() == pWORK_HP) || (HP.get_State() == pWAIT_HP)) {
					HP.sendCommand(pSTOP);
				}
			}
			key_debounce = -1;
		} else if(key_debounce) key_debounce--;
#endif
#ifdef USE_UPS
		HP.sInput[SPOWER].Read(true);
		if(HP.sInput[SPOWER].is_alarm()) { // Электричество кончилось
			if(!HP.NO_Power) {
				HP.NO_Power = 1;
				HP.save_motoHour();
				Stats.SaveStats(0);
				Stats.SaveHistory(0);
				journal.jprintf_date( "POWER LOST!\n");
				if(HP.get_State() == pSTARTING_HP || HP.get_State() == pWORK_HP) {
					HP.sendCommand(pWAIT);
					HP.NO_Power = 2;
				}
			}
			HP.NO_Power_delay = NO_POWER_ON_DELAY_CNT;
		} else if(HP.NO_Power) { // Включаемся
			if(HP.NO_Power_delay) {
				if(--HP.NO_Power_delay == 0) HP.sendCommand(pNETWORK);
			} else {
				journal.jprintf_date( "POWER RESTORED!\n");
				if(!HP.Schdlr.IsShedulerOn()) {  // Расписание не активно, иначе включаемся через расписание
					if(HP.NO_Power == 2 && HP.get_State() == pWAIT_HP) {
						HP.NO_Power = 0;
						journal.jprintf("Resuming work...\n");
						HP.sendCommand(pRESUME);
					}
				}
				HP.NO_Power = 0;
			}
		}
#endif
#ifdef RADIO_SENSORS
		check_radio_sensors();
#endif
		int32_t tm2 = GetTickCount() - tm;
		if((tm2 -= ms) >= 0) {
			if(tm2 < 10) vTaskDelay(10 - tm2);
			break;
		}
		vTaskDelay(tm2 > -10 ? 3 : 10);
	} while(true);
}

//////////////////////////////////////////////////////////////////////////
// Задача Управление тепловым насосом (HP.xHandleUpdate) "UpdateHP"
 void vUpdate( void * )
{ //const char *pcTaskName = "HP_Update\r\n";
	#ifdef RPUMPB
	static uint32_t RPUMPBTick=0;
	#endif
	static uint8_t  Scheduler_check_day = 0;
	for(;;)
	{
		if(!HP.Task_vUpdate_run) {
			vTaskSuspend(NULL);				// Stop vUpdate, HP.xHandleUpdate
			continue;
		}
		if (HP.get_State()==pWORK_HP){ //Код обслуживания работы ТН выполняется только если состяние ТН - работа а вот расписание всегда выполняется
			// 1. Обновится, В это время команды управления не выполняются!!!!!
			if (SemaphoreTake(HP.xCommandSemaphore,0)==pdPASS)                                           // Cемафор  захвачен
			{
				if (HP.get_State()==pWORK_HP)  HP.vUpdate();                                               // ТН работает и идет процесс контроля
				SemaphoreGive(HP.xCommandSemaphore);                                                       // Семафор отдан
			}
			// 2. Управление циркуляционным насосом ГВС
#ifdef RPUMPB
#ifdef SUPERBOILER
			if (HP.scheduleBoiler())                         // Для супербойлера игнорироуем для циркуляции флаг включения бойлера только расписание
#else
				if ((HP.scheduleBoiler())&&(HP.get_BoilerON()))  // если бойлер разрешен и разрешено греть бойлер согласно расписания или расписание выключено
#endif
				{
#ifndef SUPERBOILER                       // если не определен супер бойлер, то при нагреве ГВС циркуляция всегда рабоатет
					if ((HP.get_modWork() & pBOILER))           // Если включен нагрев ГВС всегда включать насос циркуляции ЕСЛИ НЕ СУПЕРБОЙЛЕР
					{ HP.dRelay[RPUMPB].set_ON(); }
					else
#endif  // #ifndef SUPERBOILER 
						if (HP.get_Circulation())                                               // Циркуляция разрешена
						{
#ifdef SUPERBOILER
							if((HP.dRelay[RCOMP].get_Relay()||HP.dFC.isfOnOff())&&(HP.get_onBoiler() || (HP.dRelay[RSUPERBOILER].get_Relay() && !HP.dRelay[PUMP_OUT].get_Relay()))) {
								// идет прямой нагрев ГВС через предконденсатор, насос циркуляции ВЫКЛЮЧАЕМ
								HP.dRelay[RPUMPB].set_OFF();
								goto delayTask;
							}
#else
							if((HP.dRelay[RCOMP].get_Relay()||HP.dFC.isfOnOff())&&(HP.get_onBoiler())) { // идет нагрев ГВС
                               HP.dRelay[RPUMPB].set_ON();
                               goto delayTask; // идет нагрев ГВС включаем насос циркуляции ВСЕГДА - улучшаем перемешивание
			                }
#endif
			                if (HP.get_CirculWork()==0) { HP.dRelay[RPUMPB].set_OFF(); goto delayTask;/* continue;*/}   // В условиях стоит время работы 0 - выключаем насос ГВС
							if (HP.get_CirculPause()==0) { HP.dRelay[RPUMPB].set_ON(); goto delayTask;/* continue;*/}  // В условиях стоит время паузы 0 - включаем насос ГВС
							if(HP.dRelay[RPUMPB].get_Relay())                                       // Насос включен Смотрим времена
							{
								if(((long)xTaskGetTickCount()-RPUMPBTick ) > HP.get_CirculWork()*configTICK_RATE_HZ)   // ждем время мсек
								{
									RPUMPBTick=xTaskGetTickCount();
									HP.dRelay[RPUMPB].set_OFF();                                  // выключить насос
								}
							} else {                                                                // Насос выключен
								if(((long)xTaskGetTickCount()-RPUMPBTick ) >  HP.get_CirculPause()*configTICK_RATE_HZ)   // ждем время мсек
								{
									RPUMPBTick=xTaskGetTickCount();
									HP.dRelay[RPUMPB].set_ON();                                    // включить насос
								}
							} // if(HP.dRealay[RPUMPB].get_Relay())
						}  //  if (HP.get_Circulation())
						else HP.dRelay[RPUMPB].set_OFF() ;                                      // if (HP.get_Circulation())        выключить насос если его управление запрещено
				} //  if (HP.scheduleBoiler())
				else  HP.dRelay[RPUMPB].set_OFF() ;                                       // По расписанию выключено или бойлер запрещен,  насос выключаем
#endif // #ifdef RPUMPB
		} // НЕ РЕЖИМ ОЖИДАНИЕ if HP.get_State()==pWORK_HP)
	
		if(!HP.Task_vUpdate_run) goto delayTask;/* continue;*/

		// 3. Расписание проверка всегда
		{  // error: jump to label [-fpermissive] GCC
			// Переключение расписания, когда текущий месяц и дясятидневка совпадают; если пропустили из-за выключенного НК или работы,
			// то пропустили. Расписание выбирается один раз, если вручную перевыбрать, то еще раз автоматически выбираться не будет до следующего года
			if(HP.Schdlr.IsShedulerOn()) {
				uint8_t d = rtcSAM3X8.get_days();
				if(Scheduler_check_day != d) {
					Scheduler_check_day = d;
					d /= 10;
					if(d > 2) d = 2;
					bool need_save = false;
					for(uint8_t i = 0; i < MAX_CALENDARS; i++) {
						if(HP.Schdlr.sch_data.AutoSelectMonthWeek[i]) {
							if((HP.Schdlr.sch_data.AutoSelectMonthWeek[i] & ~0x80) == ((rtcSAM3X8.get_months() << 3) | d)) {
								if(HP.Schdlr.sch_data.Active != i && !(HP.Schdlr.sch_data.AutoSelectMonthWeek[i] & 0x80)) {
									journal.jprintf_time("Schedule %d selected\n", i + 1);
									HP.Schdlr.sch_data.Active = i;
									HP.Schdlr.sch_data.AutoSelectMonthWeek[i] |= 0x80;
									need_save = true;
									break;
								}
							} else if(HP.Schdlr.sch_data.AutoSelectMonthWeek[i] & 0x80) {
								HP.Schdlr.sch_data.AutoSelectMonthWeek[i] &= ~0x80;
								need_save = true;
							}
						}
					}
					if(need_save) HP.Schdlr.save();
				}
			}
			int8_t _profile = HP.Schdlr.calc_active_profile(); // Какой профиль ДОЛЖЕН быть сейчас активен
			if(_profile != SCHDLR_NotActive) {                 // Расписание активно
				int8_t _curr_profile = HP.get_State() == pWORK_HP ? HP.Prof.get_idProfile() : SCHDLR_Profile_off;
				if(_profile != _curr_profile && HP.isCommand() == pEMPTY) { // новый режим и ни чего не выполняется?
					if(_profile == SCHDLR_Profile_off) {
						HP.sendCommand(pWAIT);
					} else if(HP.Prof.get_idProfile() != _profile) {
						int32_t _mode;
						if((_mode = HP.Prof.load_from_EEPROM_SaveON_mode(_profile)) >= 0) {
							MODE_HP currmode = HP.get_modWork();
							uint8_t frestart = _mode != pOFF && currmode != pOFF && (currmode & (pHEAT | pCOOL)) && (currmode & (pHEAT | pCOOL)) != (_mode & (pHEAT | pCOOL)); // Если направление работы ТН разное
							if(frestart) {
								HP.sendCommand(pWAIT);
								uint8_t i = DELAY_BEFORE_STOP_IN_PUMP + HP.Option.delayOffPump + 1;
								while(HP.isCommand()) {	_delay(1000); if(!--i) break; } // ждем отработки команды
								if(!HP.Task_vUpdate_run) continue;
							}
							vTaskSuspendAll();	// без проверки
							HP.Prof.load(_profile);
							HP.set_profile();
							xTaskResumeAll();
							journal.jprintf_time("Profile changed to #%d\n", _profile);
							if(frestart) HP.sendCommand(pRESUME);
						}
					} else if(HP.get_State() == pWAIT_HP && !HP.NO_Power) {
						HP.sendCommand(pRESUME);
					}
				}
			}
		}
		// 4. Отработка пауз всегда они разные в зависимости от состояния ТН!!
delayTask:	// чтобы задача отдавала часть времени другим
		switch (HP.get_State())  // Состояние ТН
		{
		case pOFF_HP:                          // 0 ТН выключен
		case pSTOPING_HP:                      // 2 Останавливается
			journal.jprintf((const char*)" Stop task UpdateHP\n");
			HP.Task_vUpdate_run = false;
			break;
		case pSTARTING_HP: _delay(10000); break; // 1 Стартует  - этого не должно быть в этом месте
		case pWORK_HP:                           // 3 Работает   - анализ режима работы get_modWork()
			if((HP.get_modWork() & pHEAT)) {	// Отопление
				if(HP.get_ruleHeat()==pHYSTERESIS)  vTaskDelay(TIME_CONTROL/portTICK_PERIOD_MS);    // Гистерезис
				else
					vTaskDelay(HP.dFC.get_Uptime()*1000/portTICK_PERIOD_MS);                        // Время интегрирования ПИД  секунды
			} else if((HP.get_modWork() & pCOOL)) { // охлаждение
				if(HP.get_ruleCool()==pHYSTERESIS)  vTaskDelay(TIME_CONTROL/portTICK_PERIOD_MS);    // Гистерезис
				else
					vTaskDelay(HP.dFC.get_Uptime()*1000/portTICK_PERIOD_MS);                        // Время интегрирования ПИД секунды
			} else if((HP.get_modWork() & pCOOL)) { // бойлер
				vTaskDelay(HP.dFC.get_Uptime()*1000/portTICK_PERIOD_MS);                            // Время интегрирования ПИД секунды
			} else { // Пауза
				vTaskDelay(TIME_CONTROL/portTICK_PERIOD_MS);                                        // Гистерезис
			}
			break;
		case pWAIT_HP:                          // 4 Ожидание ТН (расписание - пустое место)   проверям раз в 5 сек
		case pERROR_HP: 						// 5 Ошибка ТН
			_delay(UPDATE_HP_WAIT_PERIOD);
			break;
		case pERROR_CODE:                       // 6 - Эта ошибка возникать не должна!
		default:
			journal.jprintf((const char*)" $ERROR: Bad state HP in function %s\n",(char*)__FUNCTION__);
		} //  switch (HP.get_State())

		if(!HP.Task_vUpdate_run) continue;
		// Солнечный коллектор
#ifdef USE_SUN_COLLECTOR
		if(HP.flags & (1<<fHP_SunSwitching)) {
			if(GetTickCount() - HP.time_Sun > SUN_VALVE_SWITCH_TIME) {
				HP.flags = (HP.flags & ~((1<<fHP_SunSwitching) | (1<<fHP_SunReady)));
				if(HP.dRelay[RSUNON].get_Relay()) {
					HP.flags |= (1<<fHP_SunReady);
					HP.time_Sun -= uint32_t(HP.Option.SunMinPause * 1000);
				}
				HP.dRelay[RSUNON].set_OFF();
				HP.dRelay[RSUNOFF].set_OFF();
			}
		} else {
			boolean fregen = GETBIT(HP.get_flags(), fSunRegenerateGeo) && HP.is_pause();
			int16_t tsun = HP.sTemp[TSUN].get_Temp();
			if(((!HP.is_pause()	&& (((HP.get_modWork() & pHEAT) && GETBIT(HP.Prof.Heat.flags, fUseSun)) || ((HP.get_modWork() & pCOOL) && GETBIT(HP.Prof.Cool.flags, fUseSun))
									|| (HP.get_onBoiler() && GETBIT(HP.Prof.Boiler.flags, fBoilerUseSun)))) || fregen)
				 && HP.get_State() != pERROR_HP && (HP.get_State() != pOFF_HP || HP.PauseStart != 0)) {
				if((HP.flags & (1<<fHP_SunWork))) {
					if(GetTickCount() - HP.time_Sun > uint32_t(HP.Option.SunMinWorktime * 1000)) {
						if(fregen) {
							if(tsun < HP.Option.SunRegGeoTemp || HP.sTemp[TSUNOUTG].get_Temp() < HP.Option.SunRegGeoTempGOff) HP.Sun_OFF();
						} else if(HP.sTemp[TSUNOUTG].get_Temp() < HP.sTemp[TEVAOUTG].get_Temp() + HP.Option.SunGTDelta) HP.Sun_OFF();
					}
				} else if(tsun >= (fregen ? HP.Option.SunRegGeoTemp : HP.sTemp[TEVAOUTG].get_Temp()) + HP.Option.SunTDelta) {
					HP.Sun_ON();
				}
			} else {
				HP.Sun_OFF();
				HP.time_Sun = GetTickCount() - uint32_t(HP.Option.SunMinPause * 1000);	// выключить задержку последующего включения
			}
			uint8_t fl = HP.flags & ((1<<fHP_SunNotInited) | (1<<fHP_SunReady) | (1<<fHP_SunSwitching) | (1<<fHP_SunWork));
			if((fl == (1<<fHP_SunReady) || fl == (1<<fHP_SunNotInited)) && tsun < HP.Option.SunTempOff) {
				HP.flags = (HP.flags & ~((1<<fHP_SunReady) | (1<<fHP_SunNotInited))) | (1<<fHP_SunSwitching);
				HP.dRelay[RSUNON].set_OFF();
				HP.dRelay[RSUNOFF].set_ON();
				HP.time_Sun = GetTickCount();
			}
		}
#endif
	}// for
	vTaskDelete( NULL );
}

// Задача Управление ЭРВ, "UpdateEEV"
#ifdef EEV_DEF
void vUpdateEEV(void *)
{ //const char *pcTaskName = "HP_UpdateEEV\r\n";
	for(;;) {
		while(!(HP.get_startCompressor() && (rtcSAM3X8.unixtime() - HP.get_startCompressor() > HP.dEEV.get_delayOnPid() && HP.dEEV.get_delayOnPid() != 255))) { // ЭРВ контролирует если прошла задержка после включения компрессора (пауза перед началом работы ПИД) и задержка != 255
			vTaskDelay(TIME_EEV_BEFORE_PID / portTICK_PERIOD_MS); // Период управления ЭРВ (цикл управления)
			if(GETBIT(HP.dEEV.get_flags(), fEEV_StartPosByTemp)) { // Скорректировать ЭРВ по температуре подачи
				HP.dEEV.set_EEV(HP.dEEV.get_StartPos());
			}
		}
		HP.dEEV.resetPID();
xContinue:
		if(!HP.is_compressor_on()) {
			switch((uint8_t)HP.get_State()) {
			case pOFF_HP:
			case pSTOPING_HP:
			case pWAIT_HP:
				// Если компрессор не работает, то остановить задачу Обновления ЭРВ
				journal.jprintf((const char*) " Stop task UpdateEEV\n");
				vTaskSuspend(NULL);				// Stop vUpdateEEV
				continue; // продолжение задачи работы ЭРВ начитается с этого места, по этому сразу на начало цикла контроля
			}
		} else {
			HP.dEEV.CorrectOverheat();
			// Обновить и выполнить итерацию по контролю ЭРВ Для алгоритма таблица передаем СРЕДНИЕ (IN+OUT)/2 температуры
			HP.dEEV.Update();
			// штатная пауза (в зависимости от настроек)
			vTaskDelay(HP.dEEV.get_PID_time() * 1000 / portTICK_PERIOD_MS);  // ПИД
			goto xContinue;
		}
		vTaskDelay(TIME_EEV / portTICK_PERIOD_MS);
	} // for
	vTaskDelete( NULL);
}
#endif

#ifdef EEV_DEF
// Задача обеспечения движения шаговика EEV (StepperEEV)
void vUpdateStepperEEV(void *)
{ //const char *pcTaskName = "HP_UpdateStepperEEV\r\n";
  // Размер стека не позволяет использовать внутри jprintf.* !!!
	static int16_t cmd = 0;
	for(;;) {
		// Полный цикл движения шаговика с разгребанием очереди команд,
		// В очереди лежат АБСОЛЮТНЫЕ координаты
		// При этом если очередь содержит более одной команды - просто суммируем все команды и двигаемся по итоговой сумме
		// Это значит что шаговик не успевает за темпом выдачи команд программой. Экономим время

		// 1. Чтение очереди команд, для выяснения все таки куда надо двигаться, переходим на относительные координаты
		int16_t steps_left, *step_number = &HP.dEEV.EEV; // получить текущее положение шаговика абсолютное в начале очереди
		if(*step_number < 0) *step_number = 0;
		while(xQueueReceive(HP.dEEV.stepperEEV.xCommandQueue,&cmd,0) == pdPASS) ;   // Читаем очередь пока есть чего читать
		if(HP.dEEV.setZero) {
			*step_number = (HP.dEEV.stepperEEV.number_of_steps + EEV_SET_ZERO_OVERRIDE + 7) / 8 * 8; // Если выполняется команда установки 0 то все остальные команды игнорируются до ее выполнения.
			cmd = 0;
		}
		steps_left = cmd - *step_number;
		// 2. Движение
		while(steps_left != 0) {
			if(steps_left > 0) {// направление в увеличение
				(*step_number)++;
				steps_left--;
			} else { 			// направление в уменьшение
				(*step_number)--;
				steps_left++;
			}
			if(*step_number < 0) {
				HP.dEEV.set_error(ERR_MIN_EEV);
				break;
			}
#if EEV_PHASE == PHASE_4  // 4 фазы движения
			HP.dEEV.stepperEEV.stepOne(*step_number % 4);                  // Сделать один шаг //
#else                     // остальные варианты  8 фаз движения
			HP.dEEV.stepperEEV.stepOne(*step_number % 8);                   // Сделать один шаг //
#endif
			vTaskDelay(HP.dEEV.stepperEEV.step_delay / portTICK_PERIOD_MS);      // Ожидать step_delay для следующего шага.
		}
		if(HP.dEEV.setZero) { // если стоит признак установки нуля, обнулить и сбросить признак
			*step_number = 0;
			HP.dEEV.setZero = false;
		}

		// 3. Остановить выполнение команад, если очередь пуста, но могли накидать пока двигались
		if(xQueuePeek(HP.dEEV.stepperEEV.xCommandQueue,&cmd,0) == errQUEUE_EMPTY) {
			if(!HP.dEEV.get_HoldMotor()) HP.dEEV.stepperEEV.off();                                   // выключить двигатель если нет удержания
			HP.dEEV.stepperEEV.offBuzy();                                                            // признак Мотор остановлен
			vTaskSuspend(NULL);               // Приостановить задучу vUpdateStepperEEV
		}
		// Дошли до сюда новая, очередь не пуста и новая итерация по разбору очереди
	} // for
	vTaskDelete( NULL);
}
#endif

// vUpdateCommand /////////////////////////////////////////////////////// 
// Задача Разбор очереди команд
void vUpdateCommand(void *)
{ //const char *pcTaskName = "HP_UpdateCommand\r\n";
	for(;;) {
		HP.runCommand();       // Выполнение команд управления ТН
		vTaskSuspend(NULL);    // Команды выполнены, остановить задачу vUpdateCommand, пуск осуществляется при посылке команды
	}
	vTaskDelete( NULL);
}

// ServiceHP ///////////////////////////////////////////////
// Графики в ОЗУ, счетчики моточасов, сохранение статистики, работа насосов в простое, дисплей Nextion
void vServiceHP(void *)
{
#ifdef NEXTION
	static uint32_t NextionTick = 0;
#endif
	static uint8_t  task_updstat_countm = rtcSAM3X8.get_minutes();
	static uint8_t  task_dailyswitch_countm = task_updstat_countm;
	static TickType_t timer_sec = xTaskGetTickCount(), timer_idle = 0, timer_total = 0;
	static uint16_t restart_cnt;
	static uint16_t pump_in_pause_timer = 0;
	for(;;) {
		STORE_DEBUG_INFO(70);
		register uint32_t t = xTaskGetTickCount();
		if(t - timer_sec >= 1000) { // 1 sec
			WDT_Restart(WDT);
			extern TickType_t xTickCountZero;
			TickType_t ttmpt = t - xTickCountZero - timer_total;
			if(ttmpt > 5000) {
				if(t < timer_sec) {
					vTaskResetRunTimeCounters();
					timer_idle = timer_total = 0;
				} else {
					TickType_t ttmp = timer_idle;
					HP.CPU_LOAD = 100 - (((timer_idle = vTaskGetRunTimeCounter(xTaskGetIdleTaskHandle())) - ttmp) / (ttmpt / 100UL));
					timer_total = t - xTickCountZero;
				}
			}
			timer_sec = t;
			if(HP.IsWorkingNow()) {
				if(((Charts_when_comp_on && HP.is_compressor_on()) || (!Charts_when_comp_on && HP.get_State() != pOFF_HP)) && ++task_updstat_chars >= HP.get_tChart()) { // пришло время
					task_updstat_chars = 0;
					STORE_DEBUG_INFO(71);
					HP.updateChart();                                       // Обновить графики
					STORE_DEBUG_INFO(72);
				}
				uint8_t m = rtcSAM3X8.get_minutes();
				if(m != task_updstat_countm) { 								// Через 1 минуту
					task_updstat_countm = m;
					STORE_DEBUG_INFO(73);
					HP.updateCount();                                       // Обновить счетчики моточасов
					STORE_DEBUG_INFO(74);
					if(task_updstat_countm == 59) HP.save_motoHour();		// сохранить раз в час
					Stats.History();                                        // запись истории в файл
				} else if(m != task_dailyswitch_countm) {
					task_dailyswitch_countm = m;
					uint32_t tt = rtcSAM3X8.get_hours() * 100 + m;
					for(uint8_t i = 0; i < DAILY_SWITCH_MAX; i++) {
						if(HP.Prof.DailySwitch[i].Device == 0) break;
						uint32_t st = HP.Prof.DailySwitch[i].TimeOn * 10;
						uint32_t end = HP.Prof.DailySwitch[i].TimeOff * 10;
						HP.dRelay[HP.Prof.DailySwitch[i].Device].set_Relay(((end >= st && tt >= st && tt <= end) || (end < st && (tt >= st || tt <= end)))
								&& !HP.NO_Power && !GETBIT(HP.Option.flags, fBackupPower) ? fR_StatusDaily : -fR_StatusDaily);
					}
				}
				STORE_DEBUG_INFO(75);
			}
			if(HP.PauseStart) {
				if(HP.PauseStart == 1) {
					restart_cnt = HP.isCommand() == pRESTART ? HP.Option.delayStartRes : HP.Option.delayRepeadStart;  // Определение времени задержки
					journal.jprintf((const char*) "Start over %d sec . . .\n", restart_cnt);
					HP.PauseStart = 2;
				} else if(restart_cnt-- == 0) {
					HP.PauseStart = 0;
					HP.sendCommand(pAUTOSTART);
				}
			}
			if(HP.startPump) {  // Если разрешена работа насоса( 0 - останов задачи, 1 - запуск, 2 - в работе (выкл), 3 - в работе (вкл))
				if(HP.startPump == 1 && HP.get_pausePump() == 0 && HP.get_workPump()) { // Постоянно работают
					goto xPumpsOn;
				} else if(HP.get_workPump()) {
					if(pump_in_pause_timer <= 1) {
						if(HP.startPump <= 2) { // включить
							pump_in_pause_timer = HP.get_workPump();
xPumpsOn:					HP.dRelay[PUMP_OUT].set_ON();                  	// включить насос отопления
							HP.Pump_HeatFloor(true);						// включить насос ТП
							HP.startPump = 3;
						} else { // выключить
							HP.dRelay[PUMP_OUT].set_OFF();                 	// выключить насос отопления
							HP.Pump_HeatFloor(false);						// выключить насос ТП
							pump_in_pause_timer = HP.get_pausePump();
							HP.startPump = 2;
						}
					} else pump_in_pause_timer--;
				}
			}
			STORE_DEBUG_INFO(76);
			Stats.CheckCreateNewFile();
		}
		STORE_DEBUG_INFO(77);
#ifdef NEXTION
		myNextion.readCommand();                 // прочитать сообщения от дисплея
		STORE_DEBUG_INFO(78);
		if(xTaskGetTickCount() - NextionTick > NEXTION_UPDATE) {
			STORE_DEBUG_INFO(79);
			myNextion.Update();                  // Обновление дисплея
			STORE_DEBUG_INFO(80);
			NextionTick = xTaskGetTickCount();
		}
#endif
		t = GetTickCount() - timer_sec;
		vTaskDelay(t < NEXTION_READ ? t : NEXTION_READ); // задержка чтения уменьшаем загрузку процессора
	}
	vTaskDelete(NULL);
}
