pav2000/ControlHeatPump/Control/HeatPump.ino

/*
 * Copyright (c) 2016-2023 by Pavel Panfilov <firstlast2007@gmail.com> skype pav2000pav
 * &                       by Vadim Kulakov vad7@yahoo.com, vad711
 * "Народный контроллер" для тепловых насосов.
 * Данное програмное обеспечение предназначено для управления
 * различными типами тепловых насосов для отопления и ГВС.
 *
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
 * This file is distributed in the hope that it will be useful,
 * but WITHOUT ANY WARRANTY; without even the implied warranty of
 * MERCHANTABILITY or FITNESS FOR A PARTICULAR PURPOSE.See the
 * GNU General Public License for more details.
 */
// --------------------------------------------------------------------------------
// Описание базового класса для работы Теплового Насоса  ==false
// --------------------------------------------------------------------------------
#include "HeatPump.h"

// Булевые константы для упрощения читаемости кода (используются только в этом файле)
const boolean _stop =  true;   // Команда останов ТН
const boolean _wait =  false;  // Команда перевода в режим ожидания ТН
const boolean _start = true;   // Команда запуска ТН
const boolean _resume = false;  // Команда возобновления работы ТН

#define PUMPS_ON          Pumps(true, DELAY_AFTER_SWITCH_RELAY)               // Включить насосы
#define PUMPS_OFF         Pumps(false, DELAY_AFTER_SWITCH_RELAY)              // Выключить насосы
// Макросы по работе с компрессором в зависимости от наличия инвертора
#define COMPRESSOR_ON   { if(dFC.get_present()) dFC.start_FC(); else dRelay[RCOMP].set_ON(); startCompressor = rtcSAM3X8.unixtime(); }  // Включить компрессор в зависимости от наличия инвертора
#define COMPRESSOR_OFF  { if(dFC.get_present()) dFC.stop_FC(); else dRelay[RCOMP].set_OFF(); stopCompressor = rtcSAM3X8.unixtime(); } // Выключить компрессор в зависимости от наличия инвертора

//struct size
//char checker(int); char checkSizeOfInt1[sizeof(HP.Option)]={checker(&checkSizeOfInt1)};

// Установка критической ошибки для класса ТН вызывает останов ТН
// Возвращает ошибку останова ТН
void set_Error(int8_t _err, char *nam)
{
	if(HP.is_compressor_on())    // СРАЗУ Если компрессор включен, выключить  ГЛАВНАЯ ЗАЩИТА
	{ // Выключить компрессор для обоих вариантов
		journal.jprintf("$Compressor protection ");
#ifdef FC_USE_RCOMP // Использовать отдельный провод для команды ход/стоп
		HP.dRelay[RCOMP].set_OFF();
#else
#ifdef MODBUS_PORT_NUM
		if(HP.dFC.write_0x06_16(FC_CONTROL, FC_C_STOP) == OK) // подать команду ход/стоп через модбас
#endif
#endif
			HP.set_stopCompressor();
	}
	//   if ((HP.get_State()==pOFF_HP)&&(HP.error!=OK)) return HP.error;  // Если ТН НЕ работает, не стартует не останавливается и уже есть ошибка то останавливать нечего и выключать нечего выходим - ошибка не обновляется - важна ПЕРВАЯ ошибка

	if(HP.error == OK) {
		HP.error = _err;
		strcpy(HP.source_error, nam);
		strcpy(HP.note_error, NowTimeToStr());       // Cтереть всю строку и поставить время
		strcat(HP.note_error, " ");
		strcat(HP.note_error, nam);                  // Имя кто сгенерировал ошибку
		strcat(HP.note_error, ": ");
		strcat(HP.note_error, noteError[abs(_err)]); // Описание ошибки
		journal.jprintf_time("$ERROR source: %s, code: %d\n", nam, _err); //journal.jprintf(", code: %d\n",_err);
		if(xTaskGetSchedulerState() == taskSCHEDULER_RUNNING) HP.save_DumpJournal(true); // вывод отладочной информации для начала  если запущена freeRTOS
		HP.message.setMessage(pMESSAGE_ERROR, HP.note_error, 0);    // сформировать уведомление об ошибке
		// Сюда ставить надо останов ТН !!!!!!!!!!!!!!!!!!!!!
		HP.process_error();
	}
}

void HeatPump::process_error(void)
{
	if(get_State() != pOFF_HP)    // Насос не ВЫКЛЮЧЕН есть что выключать
	{
		if(get_nStart() == 0) sendCommand(pSTOP); // Послать команду на останов ТН, если нет попыток повторного пуска
		else { // сюда ставить повторные пуски ТН при ошибке.
#ifdef NOT_RESTART_ON_CRITICAL_ERRORS
			for(uint8_t i; i < sizeof(CRITICAL_ERRORS)/sizeof(CRITICAL_ERRORS[0]); i++) {
				if(CRITICAL_ERRORS[i] == error) sendCommand(pSTOP);
				goto xExit;
			}
#endif
			if(num_repeat < get_nStart())                    // есть еще попытки
			{
				sendCommand(pREPEAT);                     // Повторный пуск ТН
			} else sendCommand(pSTOP);                    // Послать команду на останов ТН  БЕЗ ПОПЫТОК ПУСКА
		}
#ifdef NOT_RESTART_ON_CRITICAL_ERRORS
xExit:
#endif
		if(get_State() == pSTARTING_HP) { // Ошибка во время старта
			set_HP_error_state();
		}
	}
}

void HeatPump::initHeatPump()
{
	uint8_t i;
	NO_Power = 0;
	flags = (1<<fHP_SunNotInited);
	eraseError();

	for(i = 0; i < TNUMBER; i++) sTemp[i].initTemp(i);            // Инициализация датчиков температуры

#ifdef SENSOR_IP
	for(i=0;i<IPNUMBER;i++) sIP[i].initIP(i);               // Инициализация удаленных датчиков
#endif
	sADC[PEVA].initSensorADC(PEVA, ADC_SENSOR_PEVA, FILTER_SIZE);          // Инициализация аналогового датчика PEVA
	sADC[PCON].initSensorADC(PCON, ADC_SENSOR_PCON, FILTER_SIZE);          // Инициализация аналогового датчика TCON
#ifdef PGEO
	sADC[PGEO].initSensorADC(PGEO, ADC_SENSOR_PGEO, FILTER_SIZE_OTHER);			// Инициализация аналогового датчика PGEO
#endif
#ifdef POUT
	sADC[POUT].initSensorADC(POUT, ADC_SENSOR_POUT, FILTER_SIZE_OTHER);			// Инициализация аналогового датчика POUT
#endif

	for(i = 0; i < INUMBER; i++) sInput[i].initInput(i);           // Инициализация контактных датчиков
	for(i = 0; i < FNUMBER; i++) sFrequency[i].initFrequency(i);  // Инициализация частотных датчиков
	for(i = 0; i < RNUMBER; i++) dRelay[i].initRelay(i);           // Инициализация реле

#ifdef EEV_DEF
	dEEV.initEEV();                                           // Инициализация ЭРВ
#endif

	// Инициалаизация модбаса  перед частотником и счетчиком
	journal.jprintf("Init Modbus RTU via RS485:");
	if(Modbus.initModbus() == OK) journal.jprintf(" OK\r\n");  //  выводим сообщение об установлении связи
	else {
		journal.jprintf(" not present config\r\n");
	}         //  нет в конфигурации

	dFC.initFC();                                              // Инициализация FC
#ifdef USE_ELECTROMETER_SDM
	dSDM.initSDM();                                            // инициалаизация счетчика
#endif
	message.initMessage(MAIN_WEB_TASK);                        // Инициализация Уведомлений, параметр - номер потока сервера в котором идет отправка
#ifdef MQTT
	clMQTT.initMQTT(MAIN_WEB_TASK);                            // Инициализация MQTT, параметр - номер потока сервера в котором идет отправка
#endif

	// Графики в памяти
	for(i = 0; i < sizeof(Charts) / sizeof(Charts[0]); i++) Charts[i].init();
	clearChart();

	resetSettingHP();                                          // все переменные
}
// Стереть последнюю ошибку
void HeatPump::eraseError()
{
	strcpy(note_error, "OK");          // Строка c описанием ошибки
	strcpy(source_error, "");          // Источник ошибки
	error = OK;                         // Код ошибки
}

// Получить число ошибок чтения ВСЕХ датчиков темпеартуры
uint32_t HeatPump::get_errorReadDS18B20()
{
	uint32_t sum = 0;
	for(uint8_t i = 0; i < TNUMBER; i++) sum += sTemp[i].get_sumErrorRead();     // Суммирование ошибок по всем датчикам
	return sum;
}

void HeatPump::Reset_TempErrors()
{
	for(uint8_t i=0; i<TNUMBER; i++) sTemp[i].Reset_Errors();
}

// Установить состояние ТН, при необходимости пишем состояние в ЕЕПРОМ
// true - есть изменения false - нет изменений
boolean HeatPump::setState(TYPE_STATE_HP st)
{
  if (st==Status.State) return false;     // Состояние не меняется
  switch (st)
  {
  case pOFF_HP:       Status.State=pOFF_HP; if(GETBIT(motoHour.flags,fMH_ON))   {SETBIT0(motoHour.flags,fMH_ON);save_motoHour();}  break;  // 0 ТН выключен, при необходимости записываем в ЕЕПРОМ
  case pSTARTING_HP:  Status.State=pSTARTING_HP; break;                                                                                    // 1 Стартует
  case pSTOPING_HP:   Status.State=pSTOPING_HP;  break;                                                                                    // 2 Останавливается
  case pWORK_HP:      Status.State=pWORK_HP;if(!(GETBIT(motoHour.flags,fMH_ON))) {SETBIT1(motoHour.flags,fMH_ON);save_motoHour();}  break; // 3 Работает, при необходимости записываем в ЕЕПРОМ
  case pWAIT_HP:      Status.State=pWAIT_HP;if(!(GETBIT(motoHour.flags,fMH_ON))) {SETBIT1(motoHour.flags,fMH_ON);save_motoHour();}  break; // 4 Ожидание, при необходимости записываем в ЕЕПРОМ
  case pERROR_HP:     Status.State=pERROR_HP;    break;                                                                                    // 5 Ошибка ТН
  case pERROR_CODE:                                                                                                                        // 6 - Эта ошибка возникать не должна!
  default:            Status.State=pERROR_HP;    break;                                                                                    // Обязательно должен быть последним, добавляем ПЕРЕД!!!
  }   
 return true; 
}

// возвращает строку с найденными датчиками
void HeatPump::scan_OneWire(char *result_str)
{
	if(get_State() == pWORK_HP) {   // ТН работает
		//strcat(result_str, "-:Не доступно - ТН работает!:::;");
		return;
	}
	if(!OW_scan_flags && OW_prepare_buffers()) {
		OW_scan_flags = 1; // Идет сканирование
		journal.jprintf("Scan 1-Wire:\n");
//		char *_result_str = result_str + m_strlen(result_str);
		OneWireBus.Scan(result_str);
#ifdef ONEWIRE_DS2482_SECOND
		OneWireBus2.Scan(result_str);
#endif
#ifdef ONEWIRE_DS2482_THIRD
		OneWireBus3.Scan(result_str);
#endif
#ifdef ONEWIRE_DS2482_FOURTH
		OneWireBus4.Scan(result_str);
#endif
		journal.jprintf("Found: %d\n", OW_scanTableIdx);
//		while(strlen(_result_str)) {
//			journal.jprintf(_result_str);
//			uint16_t l = strlen(_result_str);
//			_result_str += l > PRINTF_BUF-1 ? PRINTF_BUF-1 : l;
//		}
#ifdef RADIO_SENSORS
		journal.jprintf("Radio found(%d): ", radio_received_num);
		for(uint8_t i = 0; i < radio_received_num; i++) {
			OW_scanTable[OW_scanTableIdx].num = OW_scanTableIdx + 1;
			OW_scanTable[OW_scanTableIdx].bus = tRadio_Bus;
			memset(&OW_scanTable[OW_scanTableIdx].address, 0, sizeof(OW_scanTable[0].address));
			OW_scanTable[OW_scanTableIdx].address[0] = tRadio;
			memcpy(&OW_scanTable[OW_scanTableIdx].address[1], &radio_received[i].serial_num, sizeof(radio_received[0].serial_num));
			char *p = result_str + strlen(result_str);
			m_snprintf(p, 64, "%d:RADIO %.1dV/%c:%.2d:%u:%d;", OW_scanTable[OW_scanTableIdx].num, radio_received[i].battery, Radio_RSSI_to_Level(radio_received[i].RSSI), radio_received[i].Temp, radio_received[i].serial_num, tRadio_Bus+1);
			journal.jprintf("%s", p);
			if(++OW_scanTableIdx >= OW_scanTable_max) break;
		}
		journal.jprintf("\n");
#endif
#ifdef TNTC
		journal.jprintf("NTC found: ");
		for(uint8_t i = 0; i < TNTC; i++) {
			if(TNTC_Value[i] > TNTC_Value_Max) continue;
			OW_scanTable[OW_scanTableIdx].num = OW_scanTableIdx + 1;
			OW_scanTable[OW_scanTableIdx].bus = tADC_Bus;
			memset(&OW_scanTable[OW_scanTableIdx].address, 0, sizeof(OW_scanTable[0].address));
			OW_scanTable[OW_scanTableIdx].address[0] = tADC;
			OW_scanTable[OW_scanTableIdx].address[1] = '0' + i;
			char *p = result_str + strlen(result_str);
			m_snprintf(p, 64, "%d:NTC:%.2d:AD%d:%d;", OW_scanTable[OW_scanTableIdx].num, sTemp->Read_NTC(TNTC_Value[i]), TADC[i], tADC_Bus+1);
			journal.jprintf("%s", p);
			if(++OW_scanTableIdx >= OW_scanTable_max) break;
		}
		journal.jprintf("\n");
#endif
#ifdef TNTC_EXT

#endif
		OW_scan_flags = 0;
	}
}

// Установить синхронизацию по NTP
void HeatPump::set_updateNTP(boolean b)   
{
	if (b) SETBIT1(DateTime.flags,fUpdateNTP); else SETBIT0(DateTime.flags,fUpdateNTP);
}

// Получить флаг возможности синхронизации по NTP
boolean HeatPump::get_updateNTP()
{
  return GETBIT(DateTime.flags,fUpdateNTP);
}

// Установить значение текущий режим работы
void HeatPump::set_testMode(TEST_MODE b)
{
  int i=0; 
  for(i=0;i<TNUMBER;i++) sTemp[i].set_testMode(b);         // датчики температуры
  for(i=0;i<ANUMBER;i++) sADC[i].set_testMode(b);          // Датчик давления
  for(i=0;i<INUMBER;i++) sInput[i].set_testMode(b);        // Датчики сухой контакт
  for(i=0;i<FNUMBER;i++) sFrequency[i].set_testMode(b);    // Частотные датчики
  
  for(i=0;i<RNUMBER;i++) dRelay[i].set_testMode(b);        // Реле
  #ifdef EEV_DEF
  dEEV.set_testMode(b);                                    // ЭРВ
  #endif
  dFC.set_testMode(b);                                     // Частотник
  testMode=b; 
  // новый режим начинаем без ошибок - не надо при старте ошибки трутся
//  eraseError();
}

// Получить источник загрузки веб морды
TYPE_SOURSE_WEB HeatPump::get_SourceWeb()
{
#ifndef SD_ONLY
	if(get_WebStoreOnSPIFlash()) {
		switch (get_fSPIFlash())
		{
		case 0:
			if(get_fSD() == 2) return pSD_WEB;
			break;
		case 2:
			return pFLASH_WEB;
		}
		return pMIN_WEB;
	}
#endif
	// SD_ONLY либо настройка = хранение на SD карте: грузим морду с карты
	switch (get_fSD())
	{
	case 0:
		if(get_fSPIFlash() == 2) return pFLASH_WEB;
		break;
	case 2:
		return pSD_WEB;
	}
	return pMIN_WEB;
}

// -------------------------------------------------------------------------
// СОХРАНЕНИЕ ВОССТАНОВЛЕНИЕ  ----------------------------------------------
// -------------------------------------------------------------------------
// Обновить ВСЕ привязки удаленных датчиков
// Вызывается  при восстановлении настроек и изменении привязки, для упрощения сделана перепривязка Всех датчиков
#ifdef SENSOR_IP
   boolean HeatPump::updateLinkIP()     
    {
    uint8_t i;
    for(i=0;i<TNUMBER;i++) sTemp[i].devIP=NULL;                 // Ссылка на привязаный датчик (класс) если NULL привявязки нет
    for(i=0;i<IPNUMBER;i++)
         {
          if ((sIP[i].get_fUse())&&(sIP[i].get_link()!=-1))              // включено использование
            if ((sIP[i].get_link()>=0)&&(sIP[i].get_link()<TNUMBER))     // находится в диапазоне можно привязывать
                   sTemp[sIP[i].get_link()].devIP= &sIP[i];    
         }
    return true;     
    }
#endif

// РАБОТА с НАСТРОЙКАМИ ТН -----------------------------------------------------
// Записать настройки в память i2c: <size all><Option><DateTime><Network><message><dFC> <TYPE_sTemp><sTemp[TNUMBER]><TYPE_sADC><sADC[ANUMBER]><TYPE_sInput><sInput[INUMBER]>...<0x0000><CRC16>
// старотвый адрес I2C_SETTING_EEPROM
// Возвращает ошибку или число записанных байт
int32_t HeatPump::save(void)
{
	uint16_t crc = 0xFFFF;
	uint32_t addr = I2C_SETTING_EEPROM + 2; // +size all
	Option.numProf = Prof.get_idProfile();      // Запомнить текущий профиль, его записываем ЭТО обязательно!!!! нужно для восстановления настроек
	uint8_t tasks_suspended = TaskSuspendAll(); // Запрет других задач
	if(error == ERR_SAVE_EEPROM || error == ERR_LOAD_EEPROM || error == ERR_CRC16_EEPROM) error = OK;
	journal.jprintf(" Save settings ");
	DateTime.saveTime = rtcSAM3X8.unixtime();   // запомнить время сохранения настроек
	while(1) {
		// Сохранить параметры и опции отопления и бойлер, уведомления
		Option.ver = VER_SAVE;
		if(save_struct(addr, (uint8_t *) &Option, sizeof(Option), crc)) break;
		if(save_struct(addr, (uint8_t *) &DateTime, sizeof(DateTime), crc)) break;
		if(save_struct(addr, (uint8_t *) &Network, sizeof(Network), crc)) break;
		if(save_struct(addr, message.get_save_addr(), message.get_save_size(), crc)) break;
		if(save_struct(addr, dFC.get_save_addr(), dFC.get_save_size(), crc)) break; // Сохранение FC
		// Сохранение отдельных объектов ТН
		if(save_2bytes(addr, SAVE_TYPE_sTemp, crc)) break;
		for(uint8_t i = 0; i < TNUMBER; i++) if(save_struct(addr, sTemp[i].get_save_addr(), sTemp[i].get_save_size(), crc)) break; // Сохранение датчиков температуры
		if(error == ERR_SAVE_EEPROM) break;
		if(save_2bytes(addr, SAVE_TYPE_sADC, crc)) break;
		for(uint8_t i = 0; i < ANUMBER; i++) if(save_struct(addr, sADC[i].get_save_addr(), sADC[i].get_save_size(), crc)) break; // Сохранение датчика давления
		if(error == ERR_SAVE_EEPROM) break;
		if(save_2bytes(addr, SAVE_TYPE_sInput, crc)) break;
		for(uint8_t i = 0; i < INUMBER; i++) if(save_struct(addr, sInput[i].get_save_addr(), sInput[i].get_save_size(), crc)) break; // Сохранение контактных датчиков
		if(error == ERR_SAVE_EEPROM) break;
		if(save_2bytes(addr, SAVE_TYPE_sFrequency, crc)) break;
		for(uint8_t i = 0; i < FNUMBER; i++) if(save_struct(addr, sFrequency[i].get_save_addr(), sFrequency[i].get_save_size(), crc)) break; // Сохранение контактных датчиков
		if(error == ERR_SAVE_EEPROM) break;
		#ifdef SENSOR_IP
		if(save_2bytes(addr, SAVE_TYPE_sIP, crc)) break;
		for(uint8_t i = 0; i < IPNUMBER; i++) if(save_struct(addr, sIP[i].get_save_addr(), sIP[i].get_save_size(), crc)) break; // Сохранение удаленных датчиков
		if(error == ERR_SAVE_EEPROM) break;
		#endif
		#ifdef EEV_DEF
		if(save_2bytes(addr, SAVE_TYPE_dEEV, crc)) break;
		if(save_struct(addr, dEEV.get_save_addr(), dEEV.get_save_size(), crc)) break; // Сохранение ЭВР
		#endif
		#ifdef USE_ELECTROMETER_SDM
		if(save_2bytes(addr, SAVE_TYPE_dSDM, crc)) break;
		if(save_struct(addr, dSDM.get_save_addr(), dSDM.get_save_size(), crc)) break; // Сохранение SDM
		#endif
		#ifdef MQTT
		if(save_2bytes(addr, SAVE_TYPE_clMQTT, crc)) break;
		if(save_struct(addr, clMQTT.get_save_addr(), clMQTT.get_save_size(), crc)) break; // Сохранение MQTT
		#endif
		#ifdef CORRECT_POWER220
		if(save_2bytes(addr, SAVE_TYPE_PwrCorr, crc)) break;
		if(save_struct(addr, (uint8_t*)&correct_power220, sizeof(correct_power220), crc)) break; // Сохранение correct_power220
		#endif
		if(save_2bytes(addr, SAVE_TYPE_END, crc)) break;
		if(writeEEPROM_I2C(addr, (uint8_t *) &crc, sizeof(crc))) { error = ERR_SAVE_EEPROM; break; } // CRC
		addr = addr + sizeof(crc) - (I2C_SETTING_EEPROM + 2);
		if(writeEEPROM_I2C(I2C_SETTING_EEPROM, (uint8_t *) &addr, 2)) { error = ERR_SAVE_EEPROM; break; } // size all
		int8_t _err;
		if((_err = check_crc16_eeprom(I2C_SETTING_EEPROM + 2, addr - 2)) != OK) {
			error = _err;
			journal.jprintf("- Verify Error!\n");
			break;
		}
		addr += 2;
		journal.jprintf("OK, wrote: %d bytes, crc: %04x\n", addr, crc);
		break;
	}
	if(tasks_suspended) xTaskResumeAll(); // Разрешение других задач

	if(error == ERR_SAVE_EEPROM || error == ERR_LOAD_EEPROM || error == ERR_CRC16_EEPROM) {
		set_Error(error, (char*)__FUNCTION__);
		return error;
	}
	// суммарное число байт
	return addr;
}

// Считать настройки из памяти i2c или из RAM, если не NULL, на выходе длина или код ошибки (меньше нуля)
int32_t HeatPump::load(uint8_t *buffer, uint8_t from_RAM)
{
	uint16_t size;
	journal.jprintf(" Load settings from ");
	if(from_RAM == 0) {
		journal.jprintf("I2C");
		if(readEEPROM_I2C(I2C_SETTING_EEPROM, (byte*) &size, sizeof(size))) {
x_ReadError:
			error = ERR_CRC16_EEPROM;
x_Error:
			journal.jprintf(" - read error %d!\n", error);
			return error;
		}
		if(size > I2C_PROFILE_EEPROM - I2C_SETTING_EEPROM) { error = ERR_BAD_LEN_EEPROM; goto x_Error; }
		if(readEEPROM_I2C(I2C_SETTING_EEPROM + sizeof(size), buffer, size)) goto x_ReadError;
	} else {
		journal.jprintf("FILE");
		size = *((uint16_t *) buffer);
		buffer += sizeof(size);
	}
	journal.jprintf(", size %d, crc: ", size + 2); // sizeof(crc)
	size -= 2;
#ifdef LOAD_VERIFICATION
	
	uint16_t crc = 0xFFFF;
	for(uint16_t i = 0; i < size; i++)  crc = _crc16(crc, buffer[i]);
	if(crc != *((uint16_t *)(buffer + size))) {
		journal.jprintf("Error: %04x != %04x!\n", crc, *((uint16_t *)(buffer + size)));
		return error = ERR_CRC16_EEPROM;
	}
	journal.jprintf("%04x", crc);
#else
	journal.jprintf("*No verification");
#endif
	uint8_t *buffer_max = buffer + size;
	size += 2;
	load_struct(&Option, &buffer, sizeof(Option));
	journal.jprintf(", v.%d ", Option.ver);  // вывести версию сохранения
	load_struct(&DateTime, &buffer, sizeof(DateTime));
	load_struct(&Network, &buffer, sizeof(Network));
	load_struct(message.get_save_addr(), &buffer, message.get_save_size());
	load_struct(dFC.get_save_addr(), &buffer,  dFC.get_save_size());
	int16_t type = SAVE_TYPE_LIMIT;
	while(buffer_max > buffer) { // динамические структуры
		if(*((int16_t *) buffer) <= SAVE_TYPE_END && *((int16_t *) buffer) > SAVE_TYPE_LIMIT) {
			type = *((int16_t *) buffer);
			buffer += 2;
		}
		// массивы, длина структуры должна быть меньше 128 байт, <size[1]><<number>struct>
		uint8_t n = buffer[1]; // номер элемента
		if(type == SAVE_TYPE_sTemp) { // первый в структуре идет номер датчика
			if(n < TNUMBER) { load_struct(sTemp[n].get_save_addr(), &buffer, sTemp[n].get_save_size());	sTemp[n].after_load(); } else goto xSkip;
		} else if(type == SAVE_TYPE_sADC) {
			if(n < ANUMBER) { load_struct(sADC[n].get_save_addr(), &buffer, sADC[n].get_save_size()); sADC[n].after_load(); } else goto xSkip;
		} else if(type == SAVE_TYPE_sInput) {
			if(n < INUMBER) load_struct(sInput[n].get_save_addr(), &buffer, sInput[n].get_save_size()); else goto xSkip;
		} else if(type == SAVE_TYPE_sFrequency) {
			if(n < FNUMBER) load_struct(sFrequency[n].get_save_addr(), &buffer, sFrequency[n].get_save_size()); else goto xSkip;
#ifdef SENSOR_IP
		} else if(type == SAVE_TYPE_sIP) {
			if(n < IPNUMBER) { load_struct(sIP[n].get_save_addr(), &buffer, sIP[n].get_save_size()); sIP[n].after_load(); } else goto xSkip;
#endif
		// не массивы <size[1|2]><struct>
#ifdef EEV_DEF
		} else if(type == SAVE_TYPE_dEEV) {
			load_struct(dEEV.get_save_addr(), &buffer, dEEV.get_save_size()); dEEV.after_load();
#endif
#ifdef USE_ELECTROMETER_SDM
		} else if(type == SAVE_TYPE_dSDM) {
			load_struct(dSDM.get_save_addr(), &buffer, dSDM.get_save_size());
#endif
#ifdef MQTT
		} else if(type == SAVE_TYPE_clMQTT) {
			load_struct(clMQTT.get_save_addr(), &buffer, clMQTT.get_save_size());
#endif
#ifdef CORRECT_POWER220
		} else if(type == SAVE_TYPE_PwrCorr) {
			load_struct((uint8_t*)&correct_power220, &buffer, sizeof(correct_power220));
#endif
		} else if(type == SAVE_TYPE_END) {
			break;
		} else {
xSkip:		load_struct(NULL, &buffer, 0); // skip unknown type
		}
	}
#ifdef SENSOR_IP
	updateLinkIP();
#endif
	journal.jprintf("OK\n");
//	if(Option.ver <= 133) {
//#ifdef USE_ELECTROMETER_SDM
//		if(dSDM.get_readState(3) == OK) {
//			motoHour.E1 = (dSDM.get_Energy() - motoHour.E1_f) * 1000;
//			motoHour.E2 = (dSDM.get_Energy() - motoHour.E2_f) * 1000;
//		} else
//#endif
//		{
//			motoHour.E1 = 0;
//			motoHour.E2 = 0;
//		}
//	}
	return size + sizeof(crc);
}

// Проверить контрольную сумму в EEPROM для данных на выходе ошибка, длина определяется из заголовка
int8_t HeatPump::check_crc16_eeprom(int32_t addr, uint16_t size)
{
	uint8_t x;
	uint16_t crc = 0xFFFF;
	while(size--) {
		if(readEEPROM_I2C(addr++, &x, sizeof(x))) return ERR_LOAD_EEPROM;
		crc = _crc16(crc, x);
	}
	uint16_t crc2;
	if(readEEPROM_I2C(addr, (uint8_t *)&crc2, sizeof(crc2))) return ERR_LOAD_EEPROM;   // чтение -2 за вычетом CRC16 из длины
	if(crc == crc2) return OK; else return ERR_CRC16_EEPROM;
}

// СЧЕТЧИКИ -----------------------------------
// запись счетчиков теплового насоса в I2C память
int8_t HeatPump::save_motoHour()
{
	motoHour.Header = I2C_COUNT_EEPROM_HEADER;
	uint32_t ptr = 0;
	do {
		while(ptr < sizeof(motoHour)) if(((uint8_t*)&motoHour)[ptr] == ((uint8_t*)&motoHour_saved)[ptr]) ptr++; else break;
		if(ptr == sizeof(motoHour)) break;
		uint32_t ptre = ptr + 1;
xNotEqual:
		while(ptre < sizeof(motoHour)) if(((uint8_t*)&motoHour)[ptre] != ((uint8_t*)&motoHour_saved)[ptre]) ptre++; else break;
		if(ptre < sizeof(motoHour)) {
			uint32_t ptrz = ptre + 1;
			while(ptrz < sizeof(motoHour)) if(((uint8_t*)&motoHour)[ptrz] == ((uint8_t*)&motoHour_saved)[ptrz]) ptrz++; else break;
			if(ptrz < sizeof(motoHour)) {
				if(ptrz - ptre <= 4) {
					ptre = ptrz + 1;
					goto xNotEqual;
				}
			}
		}
		uint8_t errcode;
		if((errcode = writeEEPROM_I2C(I2C_COUNT_EEPROM + ptr, (byte*)&motoHour + ptr, ptre - ptr))) {
			journal.jprintf(" ERROR %d save counters!\n", errcode);
			set_Error(ERR_SAVE2_EEPROM, (char*) __FUNCTION__);
			return ERR_SAVE2_EEPROM;
		}
		ptr = ptre;
	} while(ptr < sizeof(motoHour));
	memcpy(&motoHour_saved, &motoHour, sizeof(motoHour_saved));
	return OK;
}

// чтение счетчиков теплового насоса в ЕЕПРОМ
int8_t HeatPump::load_motoHour()          
{
	if(readEEPROM_I2C(I2C_COUNT_EEPROM, &motoHour.Header, sizeof(motoHour.Header))) { // прочитать заголовок
		set_Error(ERR_LOAD2_EEPROM, (char*) __FUNCTION__);
		return ERR_LOAD2_EEPROM;
	}
	if(motoHour.Header != I2C_COUNT_EEPROM_HEADER) { // заголовок плохой
		journal.jprintf("Bad header counters, skip load\n");
		return ERR_HEADER2_EEPROM;
	}
	if(readEEPROM_I2C(I2C_COUNT_EEPROM + sizeof(motoHour.Header), (byte*) &motoHour + sizeof(motoHour.Header), sizeof(motoHour) - sizeof(motoHour.Header))) { // прочитать счетчики
		set_Error(ERR_LOAD2_EEPROM, (char*) __FUNCTION__);
		return ERR_LOAD2_EEPROM;
	}
	if(Option.ver <= 138) {
		memcpy(&motoHour_saved, &motoHour, sizeof(motoHour_saved));
		type_motoHour_old *p = (type_motoHour_old*)&motoHour_saved;
		motoHour.D1 = p->D1;
		motoHour.D2 = p->D2;
		motoHour.E1 = p->E1;
		motoHour.E2 = p->E2;
		motoHour.P1 = p->P1;
		motoHour.P2 = p->P2;
	}
 /* 
   // Код можно убрать в июле 2020 когда все перейдут 
   // Восстановление значений счетчиков, требуется при переходе с 1.043 на 1.053 версию от 06.01.2020, 
   // в старой версии записываем значения и потом здесь вводим, после обновления, этот фрагмент кода удаляем 
   // перевод дата в юникс формат https://www.cy-pr.com/tools/time/
   motoHour.D1 =       1510999774;  // Дата сброса общих счетчиков
   motoHour.D2 =       1570437710;  // дата сброса сезонных счетчиков
   motoHour.H1 =       18745.4*60;  // моточасы ТН ВСЕГО в минутах (часы умножаем на 60)
   motoHour.H2 =        2405.8*60;  // моточасы ТН сбрасываемый счетчик (сезон)
   motoHour.C1 =        8901.0*60;  // моточасы компрессора ВСЕГО
   motoHour.C2 =        1791.8*60;  // моточасы компрессора сбрасываемый счетчик (сезон)
   motoHour.E1 =  7102.33*1000000;  // Значение потребленной энергии ВСЕГО (кВт*ч умножаем на 1 млн.)
   motoHour.E2 =   699.36*1000000;  // Значение потребленной энергии в начале сезона 
   motoHour.P1 = 30317.47*1000000;  // выработанное тепло  ВСЕГО
   motoHour.P2 =  5304.80*1000000;  // выработанное тепло  сбрасываемый счетчик (сезон)
   save_motoHour();
 */ 	
	memcpy(&motoHour_saved, &motoHour, sizeof(motoHour_saved));
	journal.printf(" Load counters OK, read: %d bytes\n", sizeof(motoHour));
	return OK;
}
// Сборос сезонного счетчика моточасов
// параметр true - сброс всех счетчиков
void HeatPump::resetCount(boolean full)
{
	if(full) // Полный сброс счетчиков
	{
		motoHour.H1 = 0;
		motoHour.C1 = 0;
		motoHour.P1 = 0;
		motoHour.E1 = 0;
		motoHour.D1 = rtcSAM3X8.unixtime();           // Дата сброса общих счетчиков
	}
	// Сезон
	motoHour.H2 = 0;
	motoHour.C2 = 0;
	motoHour.P2 = 0;
	motoHour.E2 = 0;
	motoHour.D2 = rtcSAM3X8.unixtime();             // дата сброса сезонных счетчиков
	save_motoHour();  // записать счетчики
	motohour_OUT_work = 0;
	motohour_IN_work = 0;
}

// Обновление счетчиков моточасов, вызывается раз в минуту
// Электрическая энергия не обновляется, Тепловая энергия обновляется
void HeatPump::updateCount()
{
	if(is_compressor_on()) {
		motoHour.C1++;      // моточасы компрессора ВСЕГО
		motoHour.C2++;      // моточасы компрессора сбрасываемый счетчик (сезон)
	}
	if(get_State() == pWORK_HP) {
		motoHour.H1++;          // моточасы ТН ВСЕГО
		motoHour.H2++;          // моточасы ТН сбрасываемый счетчик (сезон)
	}
	int32_t p;
	//taskENTER_CRITICAL();
	p = motohour_IN_work;
	motohour_IN_work = 0;
	//taskEXIT_CRITICAL();
	motoHour.E1 += p;
	motoHour.E2 += p;
	//taskENTER_CRITICAL();
	p = motohour_OUT_work;
	motohour_OUT_work = 0;
	//taskEXIT_CRITICAL();
	motoHour.P1 += p;
	motoHour.P2 += p;
}

// После любого изменения часов необходимо пересчитать все времна которые используются
// параметр изменение времени - корректировка
void HeatPump::updateDateTime(int32_t dTime)
{
	if(dTime != 0 && dTime != int32_t(0x80000000))                                   // было изменено время, надо скорректировать переменные времени
	{
		Prof.SaveON.startTime = Prof.SaveON.startTime + dTime; // время пуска ТН (для организации задержки включения включение ЭРВ)
		if(timeON > 0) timeON = timeON + dTime;                               // время включения контроллера для вычисления UPTIME
		if(startCompressor > 0) startCompressor = startCompressor + dTime;             // время пуска компрессора
		if(stopCompressor > 0) stopCompressor = stopCompressor + dTime;               // время останова компрессора
		if(countNTP > 0) countNTP = countNTP + dTime;                           // число секунд с последнего обновления по NTP
		if(offBoiler > 0) offBoiler = offBoiler + dTime;                         // время выключения нагрева ГВС ТН (необходимо для переключения на другие режимы на ходу)
		if(startDefrost > 0) startDefrost = startDefrost + dTime;                   // время срабатывания датчика разморозки
		if(startSalmonella > 0) startSalmonella = startSalmonella + dTime;             // время начала обеззараживания

	}
}
      

// -------------------------------------------------------------------------
// НАСТРОЙКИ ТН ------------------------------------------------------------
// -------------------------------------------------------------------------
// Сброс настроек теплового насоса
void HeatPump::resetSettingHP()
{  
	Prof.initProfile();                           // Инициализировать профиль по умолчанию

	Status.modWork = pOFF;                          // Что сейчас делает ТН (7 стадий)
	Status.State = pOFF_HP;                         // Сотояние ТН - выключен
	Status.ret = pNone;                             // точка выхода алгоритма
	motoHour.Header = I2C_COUNT_EEPROM_HEADER;
	motoHour.flags = 0;								// насос выключен
	motoHour.H1 = 0;                                // моточасы ТН ВСЕГО
	motoHour.H2 = 0;                                // моточасы ТН сбрасываемый счетчик (сезон)
	motoHour.C1 = 0;                                // моточасы компрессора ВСЕГО
	motoHour.C2 = 0;                                // моточасы компрессора сбрасываемый счетчик (сезон)
	motoHour.E1 = 0.0;                              // Значение потреленный энергии в момент пуска  актуально при использовании счетчика SDM120 (вычитаем текущее и получам итого)
	motoHour.E2 = 0.0;                              // Значение потреленный энергии в начале сезона актуально при использовании счетчика SDM120 (вычитаем текущее и получам итого)
	motoHour.D1 = motoHour.D2 = rtcSAM3X8.unixtime(); // Дата сброса счетчиков

	startPump = false;                              // Признак работы задачи насос
	flagRBOILER = false;                            // не идет нагрев бойлера
	HeatBoilerUrgently = 0;
	fSD = false;                                    // СД карта не рабоатет
	fSPIFlash = false;                              // Признак наличия (физического) spi диска - диска нет по умолчанию

	startWait = false;                              // Начало работы с ожидания
	onBoiler = false;                               // Если true то идет нагрев бойлера
	onSalmonella = false;                           // Если true то идет Обеззараживание
	command = pEMPTY;                               // Команд на выполнение нет
	next_command = pEMPTY;
	PauseStart = 0;                                 // начать отсчет задержки пред стартом с начала
	startRAM = 0;                                   // Свободная память при старте FREE Rtos - пытаемся определить свободную память при работе
	lastEEV = -1;                                   // значение шагов ЭРВ перед выключением  -1 - первое включение
	num_repeat = 0;                                 // текушее число попыток 0 - т.е еще не было работы
	num_resW5200 = 0;                               // текущее число сбросов сетевого чипа
	num_resMutexSPI = 0;                            // текущее число сброса митекса SPI
	num_resMutexI2C = 0;                            // текущее число сброса митекса I2C
	num_resMQTT = 0;                                // число повторных инициализация MQTT клиента
	num_resPing = 0;                                // число не прошедших пингов

	fullCOP = -1000;                                // Полный СОР  сотые -1000 признак невозможности расчета
	COP = -1000;                                    // Чистый COP сотые  -1000 признак невозможности расчета

	// Инициализациия различных времен
	DateTime.saveTime = 0;                          // дата и время сохранения настроек в eeprom
	timeON = 0;                                     // время включения контроллера для вычисления UPTIME
	countNTP = 0;                                   // число секунд с последнего обновления по NTP
	startCompressor = 0;                            // время пуска компрессора
	stopCompressor = 0;                             // время останова компрессора
	offBoiler = 0;                                  // время выключения нагрева ГВС ТН (необходимо для переключения на другие режимы на ходу)
	startDefrost = 0;                               // время срабатывания датчика разморозки
	timeNTP = 0;                                    // Время обновления по NTP в тиках (0-сразу обновляемся)
	startSalmonella = 0;                            // время начала обеззараживания
	command_completed = 0;
	time_Sun = 0;
	compressor_in_pause = false;

	safeNetwork = false;                            // режим safeNetwork

	// Установка сетевых параметров по умолчанию
	if(defaultDHCP) SETBIT1(Network.flags, fDHCP);
	else SETBIT0(Network.flags, fDHCP); // использование DHCP
	Network.ip = IPAddress(defaultIP);              // ip адрес
	Network.sdns = IPAddress(defaultSDNS);          // сервер dns
	Network.gateway = IPAddress(defaultGateway);    // шлюз
	Network.subnet = IPAddress(defaultSubnet);      // подсеть
	Network.port = defaultPort;                     // порт веб сервера по умолчанию
	memcpy(Network.mac, defaultMAC, 6);             // mac адрес
	Network.resSocket = 30;                         // Время очистки сокетов
	Network.resW5200 = 0;                           // Время сброса чипа
	countResSocket = 0;                             // Число сбросов сокетов
	SETBIT1(Network.flags, fInitW5200);           // Ежеминутный контроль SPI для сетевого чипа
	SETBIT0(Network.flags, fPass);                 // !save! Использование паролей
	strcpy(Network.passUser, "user");              // !save! Пароль пользователя
	strcpy(Network.passAdmin, "admin");            // !save! Пароль администратора
	Network.sizePacket = 1465;                      // !save! размер пакета для отправки
	SETBIT0(Network.flags, fNoAck);                // !save! флаг Не ожидать ответа ACK
	Network.delayAck = 10;                          // !save! задержка мсек перед отправкой пакета
	strcpy(Network.pingAdr, PING_SERVER);         // !save! адрес для пинга
	Network.pingTime = 60 * 60;                       // !save! время пинга в секундах
	SETBIT0(Network.flags, fNoPing);               // !save! Запрет пинга контроллера

	// Время
	SETBIT1(DateTime.flags, fUpdateNTP);           // Обновление часов по NTP
	SETBIT1(DateTime.flags, fUpdateI2C);           // Обновление часов I2C

	strcpy(DateTime.serverNTP, (char*) NTP_SERVER);  // NTP сервер по умолчанию

	// Опции теплового насоса
	// Временные задержки
	Option.ver = VER_SAVE;
	Option.delayOnPump = DEF_DELAY_ON_PUMP;
	Option.delayOffPump = DEF_DELAY_OFF_PUMP;
	Option.delayStartRes = DEF_DELAY_START_RES;
	Option.delayRepeadStart = DEF_DELAY_REPEAD_START;
	Option.delayDefrostOn = DEF_DELAY_DEFROST_ON;
	Option.delayDefrostOff = DEF_DELAY_DEFROST_OFF;
	Option.delayR4WAY = DEF_DELAY_R4WAY;
	Option.delayBoilerSW = DEF_DELAY_BOILER_SW;
	Option.delayBoilerOff = DEF_DELAY_BOILER_OFF;
	Option.numProf = Prof.get_idProfile(); //  Профиль не загружен по дефолту 0 профиль
	Option.nStart = 3;                   //  Число попыток пуска компрессора
	Option.tempRHEAT = 1000;             //  Значение температуры для управления RHEAT (по умолчанию режим резерв - 10 градусов в доме)
	Option.pausePump = 600;              //  Время паузы  насоса при выключенном компрессоре, сек
	Option.workPump = 15;                //  Время работы  насоса при выключенном компрессоре, сек
	Option.tChart = 10;                  //  период накопления статистики по умолчанию 60 секунд
	SETBIT0(Option.flags, fAddHeat);      //  Использование дополнительного тена при нагреве НЕ ИСПОЛЬЗОВАТЬ
	SETBIT0(Option.flags, fTypeRHEAT);    //  Использование дополнительного тена по умолчанию режим резерв
	SETBIT1(Option.flags, fBeep);         //  Звук
	SETBIT1(Option.flags, fNextion);      //  дисплей Nextion
	SETBIT0(Option.flags, fHistory);      //  Сброс статистика на карту
	SETBIT0(Option.flags, fSaveON);       //  флаг записи в EEPROM включения ТН
	Option.sleep = 5;                    //  Время засыпания минуты
	Option.dim = 80;                     //  Якрость %
	Option.pause = 5 * 60;               // Минимальное время простоя компрессора, секунды
#ifdef USE_SUN_COLLECTOR
	Option.SunTDelta = SUN_TDELTA;
	Option.SunGTDelta = SUNG_TDELTA;
	Option.SunMinWorktime = SUN_MIN_WORKTIME;
	Option.SunMinPause = SUN_MIN_PAUSE;
#endif
    SETBIT0(Option.flags, fBackupPower); // Использование резервного питания от генератора (ограничение мощности) 
	Option.maxBackupPower=3000;          // Максимальная мощность при питании от генератора (Вт)

}

// --------------------------------------------------------------------
// ФУНКЦИИ РАБОТЫ С НАСТРОЙКАМИ ТН ------------------------------------
// --------------------------------------------------------------------
// Сетевые настройки --------------------------------------------------
//Установить параметр из строки
boolean HeatPump::set_network(char *var, char *c)
{ 
 int32_t x = atoi(c);
 if(strcmp(var,net_IP)==0){          return parseIPAddress(c, '.', Network.ip);                 }else  
 if(strcmp(var,net_DNS)==0){        return parseIPAddress(c, '.', Network.sdns);               }else
 if(strcmp(var,net_GATEWAY)==0){     return parseIPAddress(c, '.', Network.gateway);            }else                
 if(strcmp(var,net_SUBNET)==0){      return parseIPAddress(c, '.', Network.subnet);             }else  
 if(strcmp(var,net_DHCP)==0){        if (strcmp(c,cZero)==0) { SETBIT0(Network.flags,fDHCP); return true;}
                                    else if (strcmp(c,cOne)==0) { SETBIT1(Network.flags,fDHCP);  return true;}
                                    else return false;  
                                    }else  
 if(strcmp(var,net_MAC)==0){         return parseBytes(c, ':', Network.mac, 6, 16);             }else  
 if(strcmp(var,net_RES_SOCKET)==0){ switch (x)
			                       {
			                        case 0: Network.resSocket=0;     return true;  break;
			                        case 1: Network.resSocket=10;    return true;  break;
			                        case 2: Network.resSocket=30;    return true;  break;
			                        case 3: Network.resSocket=90;    return true;  break;
			                        default:                    return false; break;   
			                       }                                          }else  
 if(strcmp(var,net_RES_W5200)==0){ switch (x)
			                       {
			                        case 0: Network.resW5200=0;        return true;  break;
			                        case 1: Network.resW5200=60*60*6;  return true;  break;   // 6 часов хранение в секундах
			                        case 2: Network.resW5200=60*60*24; return true;  break;   // 24 часа
			                        default:                      return false; break;   
			                       }                                          }else   
 if(strcmp(var,net_PASS)==0){        if (x == 0) { SETBIT0(Network.flags,fPass); return true;}
                                    else if (x == 1) {SETBIT1(Network.flags,fPass);  return true;}
                                    else return false;  
                                    }else
 if(strcmp(var,net_PASSUSER)==0){    strncpy(Network.passUser,c, PASS_LEN);set_hashUser(); return true;   }else
 if(strcmp(var,net_PASSADMIN)==0){   strncpy(Network.passAdmin,c, PASS_LEN);set_hashAdmin(); return true; }else
 if(strcmp(var, net_fWebLogError) == 0) { Network.flags = (Network.flags & ~(1<<fWebLogError)) | ((x == 1)<<fWebLogError); return true; } else
 if(strcmp(var, net_fWebFullLog) == 0) { Network.flags = (Network.flags & ~(1<<fWebFullLog)) | ((x == 1)<<fWebFullLog); return true; } else
 if(strcmp(var,net_SIZE_PACKET)==0){
                                    if((x<64)||(x>2048)) return   false;
                                    else Network.sizePacket=x; return true;
                                    }else  
 if(strcmp(var,net_INIT_W5200)==0){    // флаг Ежеминутный контроль SPI для сетевого чипа
                       if (x == 0) { SETBIT0(Network.flags,fInitW5200); return true;}
                       else if (x == 1) { SETBIT1(Network.flags,fInitW5200);  return true;}
                       else return false;  
                       }else 
 if(strcmp(var,net_PORT)==0){
                       if((x<1)||(x>65535)) return false;
                       else Network.port=x; return  true;
                       }else     
 if(strcmp(var,net_NO_ACK)==0){      if (x == 0) { SETBIT0(Network.flags,fNoAck); return true;}
                       else if (x == 1) { SETBIT1(Network.flags,fNoAck);  return true;}
                       else return false;  
                       }else  
 if(strcmp(var,net_DELAY_ACK)==0){
                       if((x<1)||(x>50)) return        false;
                       else Network.delayAck=x; return  true;
                       }else         
 if(strcmp(var,net_PING_ADR)==0){     if (strlen(c)<sizeof(Network.pingAdr)) { strcpy(Network.pingAdr,c); return true;} else return false; }else    
 if(strcmp(var,net_PING_TIME)==0){switch (x)
			                       {
			                        case 0: Network.pingTime=0;        return true;  break;
			                        case 1: Network.pingTime=1*60;     return true;  break;
			                        case 2: Network.pingTime=5*60;     return true;  break;
			                        case 3: Network.pingTime=20*60;    return true;  break;
			                        case 4: Network.pingTime=60*60;    return true;  break;
			                        case 5: Network.pingTime=120*60;    return true;  break;
			                        default:                           return false; break;   
			                       }                                          }else   
 if(strcmp(var,net_NO_PING)==0){     if (x == 0) { SETBIT0(Network.flags,fNoPing);      pingW5200(get_NoPing()); return true;}
                       else if (x == 1) { SETBIT1(Network.flags,fNoPing); pingW5200(get_NoPing()); return true;}
                       else return false;  
                       }else                                                                                                                                                                               
   return false;
}
// Сетевые настройки --------------------------------------------------
//Получить параметр из строки
char* HeatPump::get_network(char *var,char *ret)
{
 if(strcmp(var,net_IP)==0){   return strcat(ret,IPAddress2String(Network.ip));          }else  
 if(strcmp(var,net_DNS)==0){      return strcat(ret,IPAddress2String(Network.sdns));   }else
 if(strcmp(var,net_GATEWAY)==0){   return strcat(ret,IPAddress2String(Network.gateway));}else                
 if(strcmp(var,net_SUBNET)==0){    return strcat(ret,IPAddress2String(Network.subnet)); }else  
 if(strcmp(var,net_DHCP)==0){      if (GETBIT(Network.flags,fDHCP)) return  strcat(ret,(char*)cOne);
                                   else      return  strcat(ret,(char*)cZero);          }else
 if(strcmp(var,net_MAC)==0){       return strcat(ret,MAC2String(Network.mac));          }else  
 if(strcmp(var,net_RES_SOCKET)==0){
 	return web_fill_tag_select(ret, "never:0;10 sec:0;30 sec:0;90 sec:0;",
				Network.resSocket == 0 ? 0 :
				Network.resSocket == 10 ? 1 :
				Network.resSocket == 30 ? 2 :
				Network.resSocket == 90 ? 3 : 4);
 }else if(strcmp(var,net_RES_W5200)==0){
	 	return web_fill_tag_select(ret, "never:0;6 hours:0;24 hours:0;",
					Network.resW5200 == 0 ? 0 :
					Network.resW5200 == 60*60*6 ? 1 :
					Network.resW5200 == 60*60*24 ? 2 : 3);
  }else if(strcmp(var,net_PASS)==0){      if (GETBIT(Network.flags,fPass)) return  strcat(ret,(char*)cOne);
                                    else      return  strcat(ret,(char*)cZero);               }else
  if(strcmp(var, net_fWebLogError) == 0) { return strcat(ret, (char*)(Network.flags & (1<<fWebLogError) ? cOne : cZero)); } else
  if(strcmp(var, net_fWebFullLog) == 0) { return strcat(ret, (char*)(Network.flags & (1<<fWebFullLog) ? cOne : cZero)); } else
  if(strcmp(var,net_PASSUSER)==0){  return strcat(ret,Network.passUser);                      }else                 
  if(strcmp(var,net_PASSADMIN)==0){ return strcat(ret,Network.passAdmin);                     }else   
  if(strcmp(var,net_SIZE_PACKET)==0){return _itoa(Network.sizePacket,ret);          }else   
    if(strcmp(var,net_INIT_W5200)==0){if (GETBIT(Network.flags,fInitW5200)) return  strcat(ret,(char*)cOne);       // флаг Ежеминутный контроль SPI для сетевого чипа
                                      else      return  strcat(ret,(char*)cZero);               }else      
    if(strcmp(var,net_PORT)==0){return _itoa(Network.port,ret);                       }else    // Порт веб сервера
    if(strcmp(var,net_NO_ACK)==0){    if (GETBIT(Network.flags,fNoAck)) return  strcat(ret,(char*)cOne);
                                      else      return  strcat(ret,(char*)cZero);          }else     
    if(strcmp(var,net_DELAY_ACK)==0){return _itoa(Network.delayAck,ret);         }else    
    if(strcmp(var,net_PING_ADR)==0){  return strcat(ret,Network.pingAdr);                  }else
    if(strcmp(var,net_PING_TIME)==0){
    	return web_fill_tag_select(ret, "never:0;1 min:0;5 min:0;20 min:0;60 min:0;120 min:0;",
					Network.pingTime == 0 ? 0 :
					Network.pingTime == 1*60 ? 1 :
					Network.pingTime == 5*60 ? 2 :
					Network.pingTime == 20*60 ? 3 :
					Network.pingTime == 60*60 ? 4 :
					Network.pingTime == 120*60 ? 5 : 6);
    } else if(strcmp(var,net_NO_PING)==0){if (GETBIT(Network.flags,fNoPing)) return  strcat(ret,(char*)cOne);
                                   else      return  strcat(ret,(char*)cZero);                        }else                                                                                          

 return strcat(ret,(char*)cInvalid);
}

// Установить параметр дата и время из строки
boolean HeatPump::set_datetime(char *var, char *c)
{
	int16_t buf[3];
	uint32_t oldTime = rtcSAM3X8.unixtime(); // запомнить время
	int32_t dTime = 0;
	if(strcmp(var, time_TIME) == 0) {
		if(!parseInt16_t(c, ':', buf, 2, 10)) return false;
		rtcSAM3X8.set_time(buf[0], buf[1], 0);  // внутренние
		setTime_RtcI2C(rtcSAM3X8.get_hours(), rtcSAM3X8.get_minutes(), rtcSAM3X8.get_seconds()); // внешние
		dTime = rtcSAM3X8.unixtime() - oldTime; // получить изменение времени
	} else if(strcmp(var, time_DATE) == 0) {
		uint8_t i = 0, f = 0;
		char ch;
		do { // ищем разделитель чисел
			ch = c[i++];
			if(ch >= '0' && ch <= '9') f = 1;
			else if(f == 1) {
				f = 2;
				break;
			}
		} while(ch != '\0');
		if(f != 2 || !parseInt16_t(c, ch, buf, 3, 10)) return false;
		rtcSAM3X8.set_date(buf[0], buf[1], buf[2]); // внутренние
		setDate_RtcI2C(rtcSAM3X8.get_days(), rtcSAM3X8.get_months(), rtcSAM3X8.get_years()); // внешние
		dTime = rtcSAM3X8.unixtime() - oldTime; // получить изменение времени
	} else if(strcmp(var, time_NTP) == 0) {
		if(strlen(c) == 0) return false;                                                 // пустая строка
		if(strlen(c) > NTP_SERVER_LEN) return false;                                     // слишком длиная строка
		else {
			strcpy(DateTime.serverNTP, c);
			return true;
		}                           // ок сохраняем
	} else if(strcmp(var, time_UPDATE) == 0) {
		if(strcmp(c, cZero) == 0) {
			SETBIT0(DateTime.flags, fUpdateNTP);
			return true;
		} else if(strcmp(c, cOne) == 0) {
			SETBIT1(DateTime.flags, fUpdateNTP);
			countNTP = 0;
			return true;
		} else return false;
	} else if(strcmp(var, time_UPDATE_I2C) == 0) {
		if(strcmp(c, cZero) == 0) {
			SETBIT0(DateTime.flags, fUpdateI2C);
			return true;
		} else if(strcmp(c, cOne) == 0) {
			SETBIT1(DateTime.flags, fUpdateI2C);
			countNTP = 0;
			return true;
		} else return false;
	} else return false;

	updateDateTime(dTime);    // было изменено время, надо скорректировать переменные времени
	return true;
}

// Получить параметр дата и время из строки
void HeatPump::get_datetime(char *var, char *ret)
{
	if(strcmp(var, time_TIME) == 0) {
		ret += strlen(ret);
		NowTimeToStr(ret);
		ret[5] = '\0';
	} else if(strcmp(var, time_DATE) == 0) {
		strcat(ret, NowDateToStr());
	} else if(strcmp(var, time_NTP) == 0) {
		strcat(ret, DateTime.serverNTP);
	} else if(strcmp(var, time_UPDATE) == 0) {
		if(GETBIT(DateTime.flags, fUpdateNTP)) strcat(ret, (char*) cOne); else strcat(ret, (char*) cZero);
	} else if(strcmp(var, time_UPDATE_I2C) == 0) {
		if(GETBIT(DateTime.flags, fUpdateI2C)) strcat(ret, (char*) cOne);
		else strcat(ret, (char*) cZero);
	} else strcat(ret, (char*) cInvalid);
}

// Установить опции ТН из числа (float), "set_oHP"
boolean HeatPump::set_optionHP(char *var, float x)   
{
	if(strcmp(var,option_ADD_HEAT)==0)         {switch ((int)x)  //использование дополнительного нагревателя (значения 1 и 0)
												   {
													case 0:  SETBIT0(Option.flags,fAddHeat);                                    return true; break;  // использование запрещено
													case 1:  SETBIT1(Option.flags,fAddHeat);SETBIT0(Option.flags,fTypeRHEAT);   return true; break;  // резерв
													case 2:  SETBIT1(Option.flags,fAddHeat);SETBIT1(Option.flags,fTypeRHEAT);   return true; break;  // бивалент
													default: SETBIT1(Option.flags,fAddHeat);SETBIT0(Option.flags,fTypeRHEAT);   return true; break;  // Исправить по умолчанию
												   } }else  // бивалент
	if(strcmp(var,option_TEMP_RHEAT)==0)       {if ((x>=-30.0)&&(x<=30.0))  {Option.tempRHEAT=rd(x, 100); return true;} else return false; }else     // температура управления RHEAT (градусы)
	if(strcmp(var,option_PUMP_WORK)==0)        {if ((x>=0)&&(x<=65535)) {Option.workPump=x; return true;} else return false;}else                // работа насоса конденсатора при выключенном компрессоре МИНУТЫ
	if(strcmp(var,option_PUMP_PAUSE)==0)       {if ((x>=0)&&(x<=65535)) {Option.pausePump=x; return true;} else return false;}else               // пауза между работой насоса конденсатора при выключенном компрессоре МИНУТЫ
	if(strcmp(var,option_ATTEMPT)==0)          { if ((x>=0)&&(x<=255)) {Option.nStart=x; return true;} else return false;  }else                // число попыток пуска
	if(strcmp(var,option_TIME_CHART)==0)       { if(x>0) { if (get_State()==pWORK_HP) clearChart(); Option.tChart = x; return true; } else return false; } else // Сбросить статистистику, начать отсчет заново
	if(strcmp(var,option_Charts_when_comp_on)==0){ Charts_when_comp_on = x; return true;} else
	if(strcmp(var,option_BEEP)==0)             {if (x==0) {SETBIT0(Option.flags,fBeep); return true;} else if (x==1) {SETBIT1(Option.flags,fBeep); return true;} else return false;  }else            // Подача звукового сигнала
	if(strcmp(var, option_NEXTION) == 0) {// использование дисплея nextion
	   bool fl = x != 0;
	   if(fl != GETBIT(Option.flags, fNextion)) {
		   Option.flags = (Option.flags & ~(1 << fNextion)) | (fl << fNextion);
		   updateNextion(true);
	   }
	   return true;
	} else if(strcmp(var,option_NEXTION_WORK)==0)     { Option.flags = (Option.flags & ~(1<<fNextionOnWhileWork)) | ((x!=0)<<fNextionOnWhileWork); updateNextion(false); return true; } else            // использование дисплея nextion
	if(strcmp(var,option_NEXT_SLEEP)==0)       {if (x>=0) {Option.sleep=x; updateNextion(false); return true;} else return false;  }else       // Время засыпания секунды NEXTION минуты
#ifdef NEXTION
	if(strcmp(var,option_NEXT_DIM)==0)         {if ((x>=1)&&(x<=100)) {Option.dim=x; myNextion.set_dim(Option.dim); return true;} else return false; }else       // Якрость % NEXTION
#endif
	if(strcmp(var,option_History)==0)          {if (x==0) {SETBIT0(Option.flags,fHistory); return true;} else if (x==1) {SETBIT1(Option.flags,fHistory); return true;} else return false;       }else       // Сбрасывать статистику на карту
	if(strcmp(var,option_SDM_LOG_ERR)==0)      {if (x==0) {SETBIT0(Option.flags,fSDMLogErrors); return true;} else if (x==1) {SETBIT1(Option.flags,fSDMLogErrors); return true;} else return false;       }else
	if(strcmp(var,option_WebOnSPIFlash)==0)    { Option.flags = (Option.flags & ~(1<<fWebStoreOnSPIFlash)) | ((x!=0)<<fWebStoreOnSPIFlash); return true; } else
	if(strcmp(var,option_LogWirelessSensors)==0){ Option.flags = (Option.flags & ~(1<<fLogWirelessSensors)) | ((x!=0)<<fLogWirelessSensors); return true; } else
	if(strcmp(var,option_SAVE_ON)==0)          {if (x==0) {SETBIT0(Option.flags,fSaveON); return true;} else if (x==1) {SETBIT1(Option.flags,fSaveON); return true;} else return false;    }else             // флаг записи в EEPROM включения ТН (восстановление работы после перезагрузки)
	if(strncmp(var,option_SGL1W, sizeof(option_SGL1W)-1)==0) {
	   uint8_t bit = var[sizeof(option_SGL1W)-1] - '0' - 1;
	   if(bit <= 3) {
		   Option.flags = (Option.flags & ~(1<<(f1Wire1TSngl + bit))) | (x == 0 ? 0 : (1<<(f1Wire1TSngl + bit)));
		   return true;
	   }
	} else
	if(strcmp(var,option_SunRegGeo)==0)        { Option.flags = (Option.flags & ~(1<<fSunRegenerateGeo)) | ((x!=0)<<fSunRegenerateGeo); return true; }else
	if(strcmp(var,option_SunRegGeoTemp)==0)    { Option.SunRegGeoTemp = rd(x, 100); return true; }else
	if(strcmp(var,option_SunRegGeoTempGOff)==0){ Option.SunRegGeoTempGOff = rd(x, 100); return true; }else
	if(strcmp(var,option_SunTDelta)==0)        { Option.SunTDelta = rd(x, 100); return true; }else
	if(strcmp(var,option_SunGTDelta)==0)       { Option.SunGTDelta = rd(x, 100); return true; }else
	if(strcmp(var,option_SunMinWorktime)==0)   { Option.SunMinWorktime = x; return true; }else
	if(strcmp(var,option_SunMinPause)==0)      { Option.SunMinPause = x; return true; }else
	if(strcmp(var,option_PAUSE)==0)			  { if ((x>=0)&&(x<=200)) {Option.pause=x*60; return true;} else return false; }else             // минимальное время простоя компрессора с переводом в минуты но хранится в секундах!!!!!
	if(strcmp(var,option_MinCompressorOn)==0)  { Option.MinCompressorOn = x; return true; }else
	if(strcmp(var,option_DELAY_ON_PUMP)==0)    {if ((x>=0)&&(x<=900)) {Option.delayOnPump=x; return true;} else return false;}else        // Задержка включения компрессора после включения насосов (сек).
	if(strcmp(var,option_DELAY_OFF_PUMP)==0)   {if ((x>=0)&&(x<=900)) {Option.delayOffPump=x; return true;} else return false;}else       // Задержка выключения насосов после выключения компрессора (сек).
	if(strcmp(var,option_DELAY_START_RES)==0)  {if ((x>=0)&&(x<=6000)) {Option.delayStartRes=x; return true;} else return false;}else     // Задержка включения ТН после внезапного сброса контроллера (сек.)
	if(strcmp(var,option_DELAY_REPEAD_START)==0){if ((x>=0)&&(x<=6000)) {Option.delayRepeadStart=x; return true;} else return false;}else // Задержка перед повторным включениме ТН при ошибке (попытки пуска) секунды
	if(strcmp(var,option_DELAY_DEFROST_ON)==0) {if ((x>=0)&&(x<=600)) {Option.delayDefrostOn=x; return true;} else return false;}else     // ДЛЯ ВОЗДУШНОГО ТН Задержка после срабатывания датчика перед включением разморозки (секунды)
	if(strcmp(var,option_DELAY_DEFROST_OFF)==0){if ((x>=0)&&(x<=600)) {Option.delayDefrostOff=x; return true;} else return false;}else    // ДЛЯ ВОЗДУШНОГО ТН Задержка перед выключением разморозки (секунды)
	if(strcmp(var,option_DELAY_R4WAY)==0)      {if ((x>=0)&&(x<=600)) {Option.delayR4WAY=x; return true;} else return false;}else         // Задержка между переключением 4-х ходового клапана и включением компрессора, для выравнивания давлений (сек). Если включены эти опции (переключение тепло-холод)
	if(strcmp(var,option_DELAY_BOILER_SW)==0)  {if ((x>=0)&&(x<=1200)) {Option.delayBoilerSW=x; return true;} else return false;}else     // Пауза (сек) после переключение ГВС - выравниваем температуру в контуре отопления/ГВС что бы сразу защиты не сработали
	if(strcmp(var,option_DELAY_BOILER_OFF)==0) {if ((x>=0)&&(x<=1200)) {Option.delayBoilerOff=x; return true;} else return false;}        // Время (сек) на сколько блокируются защиты при переходе с ГВС на отопление и охлаждение слишком горяче после ГВС
	if(strcmp(var,option_fBackupPower)==0)     {if (x==0) {SETBIT0(Option.flags,fBackupPower); return true;} else if (x==1) {SETBIT1(Option.flags,fBackupPower); return true;} else return false;}else // флаг Использование резервного питания от генератора (ограничение мощности)
	if(strcmp(var, option_fBackupPowerAuto) == 0) {
	#ifdef SGENERATOR
		if(x == 0) {
			SETBIT0(Option.flags2, f2BackupPowerAuto);
			return true;
		} else if(x == 1) {
			SETBIT1(Option.flags2, f2BackupPowerAuto);
			return true;
		} else return false;
	#else
		return true;
#endif
   } else
   if(strcmp(var,option_maxBackupPower)==0)   {if ((x>=0)&&(x<=10000)) {Option.maxBackupPower=x; return true;} else return false;}else       // Максимальная мощность при питании от генератора
   if(strcmp(var,option_SunTempOn)==0)   	  { Option.SunTempOn = rd(x, 100); return true;} else
   if(strcmp(var,option_SunTempOff)==0)   	  { Option.SunTempOff = rd(x, 100); return true;} else
   return false; 
}

// Получить опции ТН, результат добавляется в ret, "get_oHP"
char* HeatPump::get_optionHP(char *var, char *ret)
{
	if(strcmp(var,option_ADD_HEAT)==0)         {if(!GETBIT(Option.flags,fAddHeat))          return strcat(ret,(char*)"none:1;reserve:0;bivalent:0;");       // использование ТЭН запрещено
											   else if(!GETBIT(Option.flags,fTypeRHEAT))   return strcat(ret,(char*)"none:0;reserve:1;bivalent:0;");       // резерв
											   else                                        return strcat(ret,(char*)"none:0;reserve:0;bivalent:1;");}else  // бивалент
	if(strcmp(var,option_TEMP_RHEAT)==0)       {_ftoa(ret,(float)Option.tempRHEAT/100,1); return ret; }else                                         // температура управления RHEAT (градусы)
	if(strcmp(var,option_PUMP_WORK)==0)        {return _itoa(Option.workPump,ret);}else                                                           // работа насоса конденсатора при выключенном компрессоре МИНУТЫ
	if(strcmp(var,option_PUMP_PAUSE)==0)       {return _itoa(Option.pausePump,ret);}else                                                          // пауза между работой насоса конденсатора при выключенном компрессоре МИНУТЫ
	if(strcmp(var,option_ATTEMPT)==0)          {return _itoa(Option.nStart,ret);}else                                                             // число попыток пуска
	if(strcmp(var,option_TIME_CHART)==0)       {return _itoa(Option.tChart,ret);} else
	if(strcmp(var,option_Charts_when_comp_on)==0){return _itoa(Charts_when_comp_on, ret);} else
	if(strcmp(var,option_BEEP)==0)             {if(GETBIT(Option.flags,fBeep)) return strcat(ret,(char*)cOne); else return strcat(ret,(char*)cZero); }else            // Подача звукового сигнала
	if(strcmp(var,option_NEXTION)==0)          { return strcat(ret, (char*)(GETBIT(Option.flags,fNextion) ? cOne : cZero)); } else         // использование дисплея nextion
	if(strcmp(var,option_NEXTION_WORK)==0)     { return strcat(ret, (char*)(GETBIT(Option.flags,fNextionOnWhileWork) ? cOne : cZero)); } else         // использование дисплея nextion
	if(strcmp(var,option_History)==0)          {if(GETBIT(Option.flags,fHistory)) return strcat(ret,(char*)cOne); else return strcat(ret,(char*)cZero);   }else            // Сбрасывать статистику на карту
	if(strcmp(var,option_SDM_LOG_ERR)==0)      {if(GETBIT(Option.flags,fSDMLogErrors)) return strcat(ret,(char*)cOne); else return strcat(ret,(char*)cZero);   }else
	if(strcmp(var,option_WebOnSPIFlash)==0)    { return strcat(ret, (char*)(GETBIT(Option.flags,fWebStoreOnSPIFlash) ? cOne : cZero)); } else
	if(strcmp(var,option_LogWirelessSensors)==0){ return strcat(ret, (char*)(GETBIT(Option.flags,fLogWirelessSensors) ? cOne : cZero)); } else
	if(strcmp(var,option_SAVE_ON)==0)          {if(GETBIT(Option.flags,fSaveON)) return strcat(ret,(char*)cOne); else return strcat(ret,(char*)cZero);    }else           // флаг записи в EEPROM включения ТН (восстановление работы после перезагрузки)
	if(strcmp(var,option_NEXT_SLEEP)==0)       {return _itoa(Option.sleep,ret);                                                     }else            // Время засыпания секунды NEXTION минуты
	if(strcmp(var,option_NEXT_DIM)==0)         {return _itoa(Option.dim,ret);                                                       }else            // Якрость % NEXTION
	if(strncmp(var,option_SGL1W, sizeof(option_SGL1W)-1)==0) {
	   uint8_t bit = var[sizeof(option_SGL1W)-1] - '0' - 1;
	   if(bit <= 3) {
		   return strcat(ret,(char*)(GETBIT(Option.flags, f1Wire1TSngl + bit) ? cOne : cZero));
	   }
	} else
	if(strcmp(var,option_SunRegGeo)==0)    	  {return _itoa(GETBIT(Option.flags, fSunRegenerateGeo), ret);}else
	if(strcmp(var,option_SunRegGeoTemp)==0)    {_dtoa(ret,Option.SunRegGeoTemp/10,1); return ret; }else
	if(strcmp(var,option_SunRegGeoTempGOff)==0){_dtoa(ret,Option.SunRegGeoTempGOff/10,1); return ret; }else
	if(strcmp(var,option_SunTDelta)==0)        {_dtoa(ret,Option.SunTDelta/10,1); return ret; }else
	if(strcmp(var,option_SunGTDelta)==0)       {_dtoa(ret,Option.SunGTDelta/10,1); return ret; }else
	if(strcmp(var,option_SunMinWorktime)==0)   {return _itoa(Option.SunMinWorktime, ret); } else
	if(strcmp(var,option_SunMinPause)==0)      {return _itoa(Option.SunMinPause, ret); } else
	if(strcmp(var,option_PAUSE)==0)            {return _itoa(Option.pause/60,ret); } else        // минимальное время простоя компрессора с переводом в минуты но хранится в секундах!!!!!
	if(strcmp(var,option_MinCompressorOn)==0)  {return _itoa(Option.MinCompressorOn, ret); } else
	if(strcmp(var,option_DELAY_ON_PUMP)==0)    {return _itoa(Option.delayOnPump,ret);}else       // Задержка включения компрессора после включения насосов (сек).
	if(strcmp(var,option_DELAY_OFF_PUMP)==0)   {return _itoa(Option.delayOffPump,ret);}else      // Задержка выключения насосов после выключения компрессора (сек).
	if(strcmp(var,option_DELAY_START_RES)==0)  {return _itoa(Option.delayStartRes,ret);}else     // Задержка включения ТН после внезапного сброса контроллера (сек.)
	if(strcmp(var,option_DELAY_REPEAD_START)==0){return _itoa(Option.delayRepeadStart,ret);}else // Задержка перед повторным включениме ТН при ошибке (попытки пуска) секунды
	if(strcmp(var,option_DELAY_DEFROST_ON)==0) {return _itoa(Option.delayDefrostOn,ret);}else    // ДЛЯ ВОЗДУШНОГО ТН Задержка после срабатывания датчика перед включением разморозки (секунды)
	if(strcmp(var,option_DELAY_DEFROST_OFF)==0){return _itoa(Option.delayDefrostOff,ret);}else   // ДЛЯ ВОЗДУШНОГО ТН Задержка перед выключением разморозки (секунды)
	if(strcmp(var,option_DELAY_R4WAY)==0)      {return _itoa(Option.delayR4WAY,ret);}else        // Задержка между переключением 4-х ходового клапана и включением компрессора, для выравнивания давлений (сек). Если включены эти опции (переключение тепло-холод)
	if(strcmp(var,option_DELAY_BOILER_SW)==0)  {return _itoa(Option.delayBoilerSW,ret);}else     // Пауза (сек) после переключение ГВС - выравниваем температуру в контуре отопления/ГВС что бы сразу защиты не сработали
	if(strcmp(var,option_DELAY_BOILER_OFF)==0) {return _itoa(Option.delayBoilerOff,ret);}        // Время (сек) на сколько блокируются защиты при переходе с ГВС на отопление и охлаждение слишком горяче после ГВС
	if(strcmp(var,option_fBackupPower)==0)     {if(GETBIT(Option.flags,fBackupPower)) return strcat(ret,(char*)cOne); else return strcat(ret,(char*)cZero);}else // флаг Использование резервного питания от генератора (ограничение мощности)
	if(strcmp(var,option_fBackupPowerInfo)==0) { // Работа от генератора
	   if(GETBIT(Option.flags,fBackupPower)
	#ifdef USE_UPS
		   && !NO_Power
	#endif
		   ) return strcat(ret,(char*)cOne); else return strcat(ret,(char*)cZero);
	} else
	if(strcmp(var, option_fBackupPowerAuto) == 0) {
	#ifdef SGENERATOR
	   if(GETBIT(Option.flags2, f2BackupPowerAuto)) return strcat(ret, (char*) cOne); else return strcat(ret, (char*) cZero);
#else
	   return strcat(ret, (char*) cZero);
#endif
   } else
	if(strcmp(var,option_maxBackupPower)==0)   {return _itoa(Option.maxBackupPower,ret);}else    // Максимальная мощность при питании от генератора
	if(strcmp(var,option_SunTempOn)==0)        {_dtoa(ret,Option.SunTempOn/10, 1); return ret; } else
	if(strcmp(var,option_SunTempOff)==0)       {_dtoa(ret,Option.SunTempOff/10, 1); return ret; }
   return strcat(ret,(char*)cInvalid);
}


// Установить рабочий профиль по текущему Prof
void HeatPump::set_profile()
{
	Option.numProf = Prof.get_idProfile();
}

// --------------------------------------------------------------------
// ФУНКЦИИ РАБОТЫ С ГРАФИКАМИ ТН -----------------------------------
// --------------------------------------------------------------------

// получить список доступных графиков в виде строки
// cat true - список добавляется в конец, false - строка обнуляется и список добавляется
void HeatPump::get_listChart(char* ret, const char *delimiter)
{
	for(uint8_t index = 0; index < sizeof(ChartsModSetup) / sizeof(ChartsModSetup[0]); index++) {
		if(ChartsModSetup[index].object == STATS_OBJ_Temp) strcat(ret, sTemp[ChartsModSetup[index].number].get_note());
		else if(ChartsModSetup[index].object == STATS_OBJ_Press) strcat(ret, sADC[ChartsModSetup[index].number].get_note());
		else if(ChartsModSetup[index].object == STATS_OBJ_PressTemp) {
			strcat(ret, sADC[ChartsModSetup[index].number].get_note());
			strcat(ret, ", °C");
		} else if(ChartsModSetup[index].object == STATS_OBJ_Flow) strcat(ret, sFrequency[ChartsModSetup[index].number].get_note());
		else strcat(ret, STATS_OBJ_names[ChartsModSetup[index].object]);
		strcat(ret, delimiter);
	}
	for(uint8_t index = 0; index < sizeof(ChartsConstSetup) / sizeof(ChartsConstSetup[0]); index++) {
		strcat(ret, ChartsConstSetup[index].name);
		strcat(ret, delimiter);
	}
	for(uint8_t index = 0; index < sizeof(ChartsOnFlySetup) / sizeof(ChartsOnFlySetup[0]); index++) {
		strcat(ret, ChartsOnFlySetup[index].name);
		strcat(ret, delimiter);
	}
}

// сбросить графики в ОЗУ
void HeatPump::clearChart()
{
    Chart_PressTemp_PCON = Chart_Temp_TCONOUT = Chart_Temp_TCOMP = Chart_Temp_TCONOUTG = Chart_Temp_TCONING = Chart_Temp_TEVAING = Chart_Temp_TEVAOUTG = Chart_Flow_FLOWCON = Chart_Flow_FLOWEVA = 0;
	for(uint8_t i = 0; i < sizeof(Charts) / sizeof(Charts[0]); i++) {
		Charts[i].clear();
		if(i < sizeof(ChartsModSetup) / sizeof(ChartsModSetup[0])) {
			if(ChartsModSetup[i].object == STATS_OBJ_PressTemp && ChartsModSetup[i].number == PCON) Chart_PressTemp_PCON = i;
			else if(ChartsModSetup[i].object == STATS_OBJ_Temp) {
				if(ChartsModSetup[i].number == TCONOUT) Chart_Temp_TCONOUT = i;
				else if(ChartsModSetup[i].number == TCOMP) Chart_Temp_TCOMP = i;
				else if(ChartsModSetup[i].number == TCONOUTG) Chart_Temp_TCONOUTG = i;
				else if(ChartsModSetup[i].number == TCONING) Chart_Temp_TCONING = i;
				else if(ChartsModSetup[i].number == TEVAING) Chart_Temp_TEVAING = i;
				else if(ChartsModSetup[i].number == TEVAOUTG) Chart_Temp_TEVAOUTG = i;
			} else if(ChartsModSetup[i].object == STATS_OBJ_Flow) {
#ifdef FLOWCON
				if(ChartsModSetup[i].number == FLOWCON) Chart_Flow_FLOWCON = i;
				else
#endif
#ifdef FLOWEVA
					if(ChartsModSetup[i].number == FLOWEVA) Chart_Flow_FLOWEVA = i;
#else
					{}
#endif
			}
		}
	}
}

// обновить статистику, добавить одну точку и если надо записать ее на карту.
// Все значения в графиках целочислены (сотые), выводятся в формате 0.01
void  HeatPump::updateChart()
{
	for(uint8_t i = 0; i < sizeof(ChartsModSetup) / sizeof(ChartsModSetup[0]); i++) {
		if(ChartsModSetup[i].object == STATS_OBJ_Temp) Charts[i].add_Point(sTemp[ChartsModSetup[i].number].get_Temp());
		else if(ChartsModSetup[i].object == STATS_OBJ_Press) Charts[i].add_Point(sADC[ChartsModSetup[i].number].get_Value());
		else if(ChartsModSetup[i].object == STATS_OBJ_PressTemp) Charts[i].add_Point(PressToTemp(ChartsModSetup[i].number));
		else if(ChartsModSetup[i].object == STATS_OBJ_Flow) Charts[i].add_Point(sFrequency[ChartsModSetup[i].number].get_Value() / 10);
	}
	for(uint8_t i = 0; i < sizeof(ChartsConstSetup) / sizeof(ChartsConstSetup[0]); i++) {
		uint8_t j = sizeof(ChartsModSetup) / sizeof(ChartsModSetup[0]) + i;
		if(ChartsConstSetup[i].object == STATS_OBJ_Overheat) Charts[j].add_Point(dEEV.get_Overheat());
#ifdef EEV_DEF
#ifdef EEV_PREFER_PERCENT
		else if(ChartsConstSetup[i].object == STATS_OBJ_EEV) Charts[j].add_Point(dEEV.calc_percent(dEEV.get_EEV()));
#else
		else if(ChartsConstSetup[i].object == STATS_OBJ_EEV) Charts[j].add_Point(dEEV.get_EEV());
#endif
		else if(ChartsConstSetup[i].object == STATS_OBJ_Overheat2) Charts[j].add_Point(GETBIT(dEEV.get_flags(), fEEV_DirectAlgorithm) ? dEEV.OverheatTCOMP : dEEV.get_tOverheat());
#endif
		else if(ChartsConstSetup[i].object == STATS_OBJ_Compressor) Charts[j].add_Point(dFC.get_frequency());
		else if(ChartsConstSetup[i].object == STATS_OBJ_Power_FC) Charts[j].add_Point(dFC.get_power() / 10);
		else if(ChartsConstSetup[i].object == STATS_OBJ_Current_FC) Charts[j].add_Point(dFC.get_current());
#ifdef USE_ELECTROMETER_SDM
		else if(ChartsConstSetup[i].object == STATS_OBJ_Voltage) Charts[j].add_Point(dSDM.get_Voltage() * 100);
		else if(ChartsConstSetup[i].object == STATS_OBJ_Power) Charts[j].add_Point((int32_t)power220 / 10);
		else if(ChartsConstSetup[i].object == STATS_OBJ_COP_Full) Charts[j].add_Point(fullCOP);
#endif
	}
}

// получить данные графика  в виде строки, данные ДОБАВЛЯЮТСЯ к str
void HeatPump::get_Chart(int index, char *str)
{
	if(--index < 0 || index > int(sizeof(Charts) / sizeof(Charts[0]) + sizeof(ChartsOnFlySetup) / sizeof(ChartsOnFlySetup[0]))) return;
	uint8_t obj, idx = index;
	if(idx < int(sizeof(ChartsModSetup) / sizeof(ChartsModSetup[0]))) {
		obj = ChartsModSetup[idx].object;
	} else {
		idx -= sizeof(ChartsModSetup) / sizeof(ChartsModSetup[0]);
		if(idx < int(sizeof(ChartsConstSetup) / sizeof(ChartsConstSetup[0]))) {
			obj = ChartsConstSetup[idx].object;
		} else obj = ChartsOnFlySetup[idx - sizeof(ChartsConstSetup) / sizeof(ChartsConstSetup[0])].object;
	}
	_itoa(obj, str);
	strcat(str, ";");
	switch (obj) {
#ifndef EEV_PREFER_PERCENT
	case STATS_OBJ_EEV:
		Charts[index].get_PointsStr(str);
		break;
#endif
#ifdef TCONOUT
	case STATS_OBJ_Overcool:
		if(Chart_PressTemp_PCON && Chart_Temp_TCONOUT) Charts[Chart_PressTemp_PCON].get_PointsStrSubDiv100(str, &Charts[Chart_Temp_TCONOUT]);
		break;
#endif
	case STATS_OBJ_TCOMP_TCON:
		if(Chart_Temp_TCOMP && Chart_PressTemp_PCON) Charts[Chart_Temp_TCOMP].get_PointsStrSubDiv100(str, &Charts[Chart_PressTemp_PCON]);
		break;
	case STATS_OBJ_Delta_GEO:
		if(Chart_Temp_TEVAING && Chart_Temp_TEVAOUTG) Charts[Chart_Temp_TEVAING].get_PointsStrSubDiv100(str, &Charts[Chart_Temp_TEVAOUTG]);
		break;
	case STATS_OBJ_Delta_OUT:
		if(Chart_Temp_TCONOUTG && Chart_Temp_TCONING) Charts[Chart_Temp_TCONOUTG].get_PointsStrSubDiv100(str, &Charts[Chart_Temp_TCONING]);
		break;
#ifdef FLOWEVA
	case STATS_OBJ_Power_GEO:
		if(Chart_Flow_FLOWEVA && Chart_Temp_TEVAOUTG && Chart_Temp_TEVAING) Charts[Chart_Flow_FLOWEVA].get_PointsStrPower(str, &Charts[Chart_Temp_TEVAOUTG], &Charts[Chart_Temp_TEVAING], sFrequency[FLOWEVA].get_Capacity());
		break;
#endif
#ifdef FLOWCON
	case STATS_OBJ_Power_OUT:
		if(Chart_Flow_FLOWCON && Chart_Temp_TCONING && Chart_Temp_TCONOUTG) Charts[Chart_Flow_FLOWCON].get_PointsStrPower(str, &Charts[Chart_Temp_TCONING], &Charts[Chart_Temp_TCONOUTG], sFrequency[FLOWCON].get_Capacity());
		break;
#endif
	default:
		Charts[index].get_PointsStrDiv100(str);
	}
}

// расчитать хеш для пользователя возвращает длину хеша
uint8_t HeatPump::set_hashUser()
{
	char buf[20];
	strcpy(buf, NAME_USER);
	strcat(buf, ":");
	strcat(buf, Network.passUser);
	base64_encode(Security.hashUser, buf, strlen(buf));
	Security.hashUserLen = strlen(Security.hashUser);
	journal.jprintf(" Hash user: %s\n", Security.hashUser);
	return Security.hashUserLen;
}
// расчитать хеш для администратора возвращает длину хеша
uint8_t HeatPump::set_hashAdmin()
{
	char buf[20];
	strcpy(buf, NAME_ADMIN);
	strcat(buf, ":");
	strcat(buf, Network.passAdmin);
	base64_encode(Security.hashAdmin, buf, strlen(buf));
	Security.hashAdminLen = strlen(Security.hashAdmin);
	journal.jprintf(" Hash admin: %s\n", Security.hashAdmin);
	return Security.hashAdminLen;
}

// Обновить настройки дисплея Nextion
void HeatPump::updateNextion(bool need_init)
{
#ifdef NEXTION
	if(GETBIT(Option.flags, fNextion))  // Дисплей подключен
	{
		if(need_init) {
			journal.jprintf("Nextion init:");
			myNextion.init();
		}
		myNextion.init_display();
		myNextion.set_need_refresh();
	} else                        // Дисплей выключен
	{
//		myNextion.sendCommand("sleep=1");
	}
#endif
}

// Переключение на следующий режим работы отопления (последовательный перебор режимов)
void HeatPump::set_nextMode()
{
   switch ((MODE_HP)get_modeHouse() )
    {
      case  pOFF:   Prof.SaveON.mode=pHEAT;  break;
      case  pHEAT:  Prof.SaveON.mode=pCOOL;  break;
      case  pCOOL:  Prof.SaveON.mode=pOFF;   break;
      default: break;
    }
}

// Изменить целевую температуру с провекой допустимости значений
// Параметр само ИЗМЕНЕНИЕ температуры
int16_t HeatPump::setTargetTemp(int16_t dt)
{
	switch((int)get_modeHouse())   // проверка для режима ДОМА
	{
	case pOFF:
		break;
	case pHEAT:
		if(GETBIT(Prof.Heat.flags,fTarget) == 0 || get_ruleHeat() == pHYBRID) {
			if((Prof.Heat.Temp1 + dt >= 0) && (Prof.Heat.Temp1 + dt <= 4000)) Prof.Heat.Temp1 = Prof.Heat.Temp1 + dt;
			return Prof.Heat.Temp1;
		} else {
			if((Prof.Heat.Temp2 + dt >= 1000) && (Prof.Heat.Temp2 + dt <= 5000)) Prof.Heat.Temp2 = Prof.Heat.Temp2 + dt;
			return Prof.Heat.Temp2;
		}
		break;
	case pCOOL:
		if(GETBIT(Prof.Cool.flags, fTarget) || get_ruleCool() == pHYBRID) {
			if((Prof.Cool.Temp1 + dt >= 0) && (Prof.Cool.Temp1 + dt <= 3000)) Prof.Cool.Temp1 = Prof.Cool.Temp1 + dt;
			return Prof.Cool.Temp1;
		} else {
			if((Prof.Cool.Temp2 + dt >= 0) && (Prof.Cool.Temp2 + dt <= 5000)) Prof.Cool.Temp2 = Prof.Cool.Temp2 + dt;
			return Prof.Cool.Temp2;
		}
		break;
	}
	return 0;
}

int16_t HeatPump::get_targetTempCool()
{
	int16_t T;
	if(get_ruleCool() == pHYBRID) T = Prof.Cool.Temp1;
	else if(!(GETBIT(Prof.Cool.flags, fTarget))) T = Prof.Cool.Temp1;
	else T = Prof.Cool.Temp2;
	T += Schdlr.get_temp_change();
	return T;
}

int16_t HeatPump::get_targetTempHeat()
{
	int16_t T;
	if(get_ruleHeat() == pHYBRID) T = Prof.Heat.Temp1;
	else if(!(GETBIT(Prof.Heat.flags, fTarget))) T = Prof.Heat.Temp1;
	else T = Prof.Heat.Temp2;
	if(Prof.Heat.add_delta_temp != 0) {
		int8_t h = rtcSAM3X8.get_hours();
		if((Prof.Heat.add_delta_end_hour >= Prof.Heat.add_delta_hour && h >= Prof.Heat.add_delta_hour && h <= Prof.Heat.add_delta_end_hour)
			|| (Prof.Heat.add_delta_end_hour < Prof.Heat.add_delta_hour && (h >= Prof.Heat.add_delta_hour || h <= Prof.Heat.add_delta_end_hour)))
			T += Prof.Heat.add_delta_temp;
	}

	if(Prof.Heat.kWeatherTarget != 0) { // Погодозависимость
		int32_t tmp = Prof.Heat.kWeatherTarget * (Prof.Heat.WeatherBase * 100 - sTemp[TOUT].get_Temp()) / 1000;
		int32_t tmp_r = Prof.Heat.WeatherTargetRange * 10;
		if(tmp > tmp_r) tmp = tmp_r;
		else if(tmp < -tmp_r) tmp = -tmp_r;
		T += tmp;
	}
	T += Schdlr.get_temp_change();
	return T;
}

// ИЗМЕНИТЬ целевую температуру бойлера с провекой допустимости значений
int16_t HeatPump::setTempTargetBoiler(int16_t dt)
{
  if ((Prof.Boiler.TempTarget+dt>=5.0*100)&&(Prof.Boiler.TempTarget+dt<=90.0*100))   Prof.Boiler.TempTarget=Prof.Boiler.TempTarget+dt;
  return Prof.Boiler.TempTarget;     
}

// Получить целевую температуру бойлера с учетом корректировки
int16_t HeatPump::get_boilerTempTarget()
{
	 if(Prof.Boiler.add_delta_temp != 0) {
		int8_t h = rtcSAM3X8.get_hours();
		if((Prof.Boiler.add_delta_end_hour >= Prof.Boiler.add_delta_hour && h >= Prof.Boiler.add_delta_hour && h <= Prof.Boiler.add_delta_end_hour)
			|| (Prof.Boiler.add_delta_end_hour < Prof.Boiler.add_delta_hour && (h >= Prof.Boiler.add_delta_hour || h <= Prof.Boiler.add_delta_end_hour)))
			return Prof.Boiler.TempTarget + Prof.Boiler.add_delta_temp;
	 }
	 return Prof.Boiler.TempTarget;
}

// Получить целевую температуру отопления
void HeatPump::getTargetTempStr(char *rstr)
{
	switch(get_modeHouse())   // проверка отопления
	{
	case pHEAT:
		rstr = dptoa(rstr, get_targetTempHeat(), 2);
		break;
	case pCOOL:
		rstr = dptoa(rstr, get_targetTempCool(), 2);
		break;
	default:
		strcpy(rstr, "-.-");
		return;
	}
	*--rstr = '\0';
}

// --------------------------------------------------------------------------------------------------------
// ---------------------------------- ОСНОВНЫЕ ФУНКЦИИ РАБОТЫ ТН ------------------------------------------
// --------------------------------------------------------------------------------------------------------

// Все реле выключить
void HeatPump::relayAllOFF()
{
  uint8_t i;
  journal.jprintf(" All relay off\n");
  for(i=0;i<RNUMBER;i++)  dRelay[i].set_OFF();         // Выключить все реле;
}                               

// Переключение на бойлер или обратно (true-бойлер false-отопление/охлаждение) возврат onBoiler
// в зависимости от режима, не забываем менять onBoiler по нему определяется включение ГВС
// Функция вызывается на работающем компрессоре
boolean HeatPump::switchBoiler(boolean b)
{
//#ifdef R3WAY
//	if((b == onBoiler)&&(b==dRelay[R3WAY].get_Relay())) return onBoiler; // Нечего делать выходим
//#else
//  if(b == onBoiler) return onBoiler;                                   // Нечего делать выходим
//#endif
	
#ifdef DEBUG_MODWORK
	journal.printf(" swBoiler(%d): %X, mW:%d\n", b, onBoiler, get_modWork());
#endif
#ifdef R3WAY
	dRelay[R3WAY].set_Relay(b);            // Установить в нужное положение 3-х ходового
	Pump_HeatFloor(b);
#else // Нет трехходового - схема с двумя насосами
	// ставим сюда код переключения ГВС/отопление в зависимости от onBoiler=true - ГВС
	if(b) { // переключение на ГВС
#ifdef RPUMPBH
		dRelay[RPUMPBH].set_ON();    // ГВС - включить
#endif
		Pump_HeatFloor(false);		 // выключить насос ТП
		dRelay[RPUMPO].set_OFF();    // файнкойлы выключить
		
	} else { // Переключение с ГВС на Отопление/охлаждение идет анализ по режиму работы дома
#ifdef RPUMPBH
		if(!GETBIT(flags, fHP_BoilerTogetherHeat)) dRelay[RPUMPBH].set_OFF();    // ГВС надо выключить
#endif
		if((Status.modWork != pOFF) && (get_modeHouse() != pOFF) && (get_State() != pSTOPING_HP)) { // Если не пауза И отопление/охлаждение дома НЕ выключено И нет процесса выключения ТН то надо включаться
			dRelay[RPUMPO].set_ON();     // файнкойлы
			Pump_HeatFloor(true);
		//    if (Status.modWork == pBOILER)  return onBoiler; // Идет сброс тепла паузу на переключение делать не надо ***
		} else { // пауза ИЛИ работа дома не задействована - все выключить
			Pump_HeatFloor(false);
			dRelay[RPUMPO].set_OFF();     // файнкойлы
		}
	}
#endif // закрытие Нет трехходового - схема с двумя насосами
	if(onBoiler && get_State() == pWORK_HP) { // Если грели бойлер и теперь ТН работает, то обеспечить дополнительное время (delayBoilerSW сек) для прокачивания гликоля - т.к разные уставки по температуре подачи
		journal.jprintf(" Pause %ds, Boiler->House\n", Option.delayBoilerSW);
		_delay(Option.delayBoilerSW * 1000); // выравниваем температуру в контуре отопления/ГВС что бы сразу защиты не сработали
	}
	offBoiler = b ? 0 : rtcSAM3X8.unixtime(); // запомнить время выключения ГВС (нужно для переключения)
	return onBoiler = b;
}
// Проверка и если надо включение EVI если надо то выключение возвращает состояние реле
// Если реле нет то ничего не делает возвращает false
// Проверяет паузу 60 секунд после включения компрессора, и только после этого начинает управлять EVI
#ifdef REVI
boolean HeatPump::checkEVI()
{
  if (!dRelay[REVI].get_present())  return false;                                                                            // Реле отсутвует в конфигурации ничего не делаем
  if (!is_compressor_on())     {dRelay[REVI].set_OFF(); return dRelay[REVI].get_Relay();}                                    // Компрессор выключен и реле включено - выключить реле

  // компрессор работает
  if (rtcSAM3X8.unixtime()-startCompressor<60) return dRelay[REVI].get_Relay() ;                                            // Компрессор работает меньше одной минуты еще рано

  // проверяем условия для включения ЭВИ
  if((sTemp[TCONOUTG].get_Temp()>EVI_TEMP_CON)||(sTemp[TEVAOUTG].get_Temp()<EVI_TEMP_EVA)) { dRelay[REVI].set_ON(); return dRelay[REVI].get_Relay();}  // условия выполнены включить ЭВИ
  else  {dRelay[REVI].set_OFF(); return dRelay[REVI].get_Relay();}                                                          // выключить ЭВИ - условий нет
  return dRelay[REVI].get_Relay();
}
#endif

#ifdef RPUMPFL
void HeatPump::Pump_HeatFloor(boolean On)
{
	if(On) {
		if(!(get_modWork() & pBOILER) && ((get_modeHouse() == pHEAT && GETBIT(Prof.Heat.flags, fHeatFloor)) || (get_modeHouse() == pCOOL && GETBIT(Prof.Cool.flags, fHeatFloor))))
			dRelay[RPUMPFL].set_ON();
	} else dRelay[RPUMPFL].set_OFF();
}
#else
void HeatPump::Pump_HeatFloor(boolean) { }
#endif

// Включить или выключить насосы контуров и то что требуется для ГВС (трех-ходовой или насос) первый параметр их желаемое состояние
// Второй параметр параметр задержка после включения/выключения мсек. отдельного насоса (борьба с помехами)
// Идет проверка на необходимость изменения состояния насосов
// Генерятся задержки для защиты компрессора, есть задержки между включенимями насосов для уменьшения помех
// Не забываем что сдесь устанавливается onBoiler, по этому сначала вызывается Pumps потом switchBoiler
void HeatPump::Pumps(boolean b, uint16_t d)
{
#ifdef DEBUG_MODWORK
	journal.printf(" Pumps(%d), modWork: %X\n", b, get_modWork());
#endif

#ifdef R3WAY           // Если определен трехходовой то в начале переключаем его (при выключении что бы остыл теплообменник)
if(b && (get_modWork() & pBOILER)){
        dRelay[R3WAY].set_Relay(true);             // скорее всего это пуск ТН (не переключение) по этому надо включить ГВС
		_delay(d); 
		onBoiler = true;
		offBoiler = 0;
	} else {
		dRelay[R3WAY].set_Relay(false);            // скорее всего это выключение ТН (не переключение) по этому надо выключить ГВС     
	    if(onBoiler && get_State() == pWORK_HP) {  // Если грели бойлер и теперь ТН работает, то обеспечить дополнительное время (delayBoilerSW сек) для прокачивания гликоля - т.к разные уставки по температуре подачи
		 journal.jprintf(" Pause %ds, Boiler->Pause\n", Option.delayBoilerSW);
		_delay(Option.delayBoilerSW * 1000);    // выравниваем температуру в контуре отопления/ГВС что бы сразу защиты не сработали
	      }
    	onBoiler = false;
		offBoiler = rtcSAM3X8.unixtime();			// запомнить время выключения ГВС (нужно для переключения)
	}
#endif


	if(!b && GETBIT(dRelay[PUMP_IN].flags, fR_StatusMain)) {
		journal.jprintf(" Delay: stop IN pump.\n");
		_delay(DELAY_BEFORE_STOP_IN_PUMP * 1000); // задержка перед выключениме гео насоса после выключения компрессора (облегчение останова)
	}
	
	dRelay[PUMP_IN].set_Relay(b);             // Реле включения насоса входного контура  (геоконтур)
	
	if(!b && (GETBIT(dRelay[RPUMPO].flags, fR_StatusMain) // пауза перед выключением насосов контуров, если нужно
#ifdef RPUMPBH
			|| GETBIT(dRelay[RPUMPBH].flags, fR_StatusMain)
#endif
	)){ // Насосы выключены и будут выключены, нужна пауза идет останов компрессора (новое значение выкл  старое значение вкл)
		journal.jprintf(" Delay: stop OUT pump.\n");
		_delay(Option.delayOffPump * 1000); // задержка перед выключениме насосов после выключения компрессора (облегчение останова)
	} else {
		_delay(d);                                // Задержка на d мсек
	}
#ifdef  TWO_PUMP_IN                                                // второй насос для воздушника если есть
	if (!b) dRelay[PUMP_IN1].set_OFF();    // если насососы выключаем то второй вентилятор ВСЕГДА выключается!!
	else// а если насос включается то смотрим на условия
	{
		if(sTemp[TEVAOUT].get_Temp()<2500) {dRelay[PUMP_IN1].set_ON();} // Реле включения второго насоса входного контура для  воздушника
		else {dRelay[PUMP_IN1].set_OFF();}
	}
	_delay(d);                                 // Задержка на d мсек
#endif

#ifdef R3WAY  
	dRelay[PUMP_OUT].set_Relay(b);                 // Реле включения насоса выходного контура  (отопление и ГВС)
	_delay(d);                                     // Задержка на d мсек
#else
  #ifdef RPUMPBH									// насос бойлера
   	if(b) {
   		if((get_modWork() & pBOILER)) {
   			dRelay[RPUMPBH].set_ON();
   			onBoiler = true;
   			offBoiler = 0;
   		} else {
   		   	dRelay[RPUMPO].set_ON();               	// насос отопления
   		   	onBoiler = false;
   		}
   	} else {
   		dRelay[RPUMPBH].set_OFF();					// насос бойлера
   		dRelay[RPUMPO].set_OFF();                	// насос отопления
		onBoiler = false;
		offBoiler = rtcSAM3X8.unixtime();			// запомнить время выключения ГВС (нужно для переключения)
   	}
   	_delay(d); 										// Задержка на d мсек
  #else
   	dRelay[RPUMPO].set_Relay(b);                	// насос отопления
   	_delay(d); 										// Задержка на d мсек
  #endif
#endif // R3WAY
   	if(!b) {
   		SETBIT0(flags, fHP_BoilerTogetherHeat);
#ifdef SUPERBOILER
   		dRelay[RSUPERBOILER].set_OFF();
#endif
   	}
  	Pump_HeatFloor(b); 				  				// насос ТП

}
// Сброс инвертора если он стоит в ошибке, проверяется наличие инвертора и проверка ошибки после сброса
// Проводится различный сброс в зависимости от конфигурации
int8_t HeatPump::ResetFC()
{
	if(!dFC.get_present()) return OK;                                       // Инвертора нет выходим
// 1. Проверка наличия ошибки	
#ifdef SERRFC                                                               // Если есть вход от инвертора об ошибке
    sInput[SERRFC].Read();                                                  // Обновить значение
	if (sInput[SERRFC].get_lastErr()==OK) {                                 // Инвертор сбрасывать не надо
#ifdef DEBUG_MODWORK
		journal.jprintf(" %s: OK, no inverter reset required\n",sInput[SERRFC].get_name());
#endif
	return OK; }
#else
	if(dFC.get_err() == OK && !dFC.get_blockFC()) return OK;
#endif
// 2. Собственно сброс
#ifdef RRESET                                                               // Если есть вход от инвертора об ошибке
	dRelay[RRESET].set_ON(); _delay(100); dRelay[RRESET].set_OFF();         // Подать импульс сброса
	journal.jprintf(" Reset %s by RRESET: ",dFC.get_name());
#else
	dFC.reset_FC();                                                         // подать команду на сброс по модбас
    journal.jprintf(" Reset %s by Modbus: ",dFC.get_name());
//	if(dFC.get_blockFC()) return ERR_RESET_FC;                              // Инвертор блокирован
#endif
// 3. Проверка результатов сброса
#ifdef SERRFC                                                               // Если есть вход от инвертора об ошибке
    _delay(100);
	sInput[SERRFC].Read();
	if (sInput[SERRFC].get_lastErr()==OK) {journal.jprintf("%s\r\n",cOk);return OK;}// Инвертор сброшен
	else {journal.jprintf("%s\n",cError); return ERR_RESET_FC;}                   // Сброс не прошел
#else
   if(dFC.get_blockFC()) {journal.jprintf("%s\n",cError); return ERR_RESET_FC;}   // Инвертор блокирован
   else                  {journal.jprintf("%s\n",cOk);return OK;}                 // Инвертор сброшен
#endif
	return OK;
}
           
// проверить, Если есть ли работа для ТН - true.
boolean HeatPump::CheckAvailableWork()
{
	return Prof.SaveON.mode != pOFF || GETBIT(Prof.SaveON.flags, fBoilerON) || GETBIT(Option.flags, fSunRegenerateGeo) || Schdlr.IsShedulerOn();
}

// START/RESUME -----------------------------------------
// Функция Запуска/Продолжения работы ТН - возвращает ок или код ошибки
// Запускается ВСЕГДА отдельной задачей с приоритетом выше вебсервера
// Параметр задает что делаем true-старт, false-возобновление
void HeatPump::StartResume(boolean start)
{
#ifdef USE_UPS
	if(NO_Power) {
		NO_Power = 2; // Resume after
xGoWait:
		journal.jprintf(" Start task UpdateHP\n");
		journal.jprintf_time("%s WAIT . . .\n", (char*) nameHeatPump);
		startWait = true;                    // Начало работы с ожидания=true;
		setState(pWAIT_HP);
		Task_vUpdate_run = true;
		vTaskResume(xHandleUpdate);
		return;
	}
#endif
	// Дана команда старт - но возможно надо переходить в ожидание
	// Определяем что делать
	int8_t profile = Schdlr.calc_active_profile();
	if((profile != SCHDLR_NotActive) && (start)) { // расписание активно и дана команда
		if(profile == SCHDLR_Profile_off) {
#ifdef USE_UPS
			goto xGoWait;
#else
		journal.jprintf(" Start task UpdateHP\n");
		journal.jprintf_time("%s WAIT . . .\n", (char*) nameHeatPump);
		startWait = true;                    // Начало работы с ожидания=true;
		setState(pWAIT_HP);
		Task_vUpdate_run = true;
		vTaskResume(xHandleUpdate);
		return;
#endif			
		} else if(profile != Prof.get_idProfile()) {
			Prof.load(profile);
			set_profile();
			journal.jprintf("Profile changed to #%d\n", profile);
		}
	}
	if(startWait) {
		startWait = false;
		start = true;   // Делаем полный запуск, т.к. в положение wait переходили из стопа (расписания)
	}

	// 1. Переменные  установка, остановка ТН имеет более высокий приоритет чем пуск ! -------------------------
	if(start)  // Команда старт
	{
		if((get_State() == pWORK_HP) || (get_State() == pSTOPING_HP) || (get_State() == pSTARTING_HP)) return; // Если ТН включен или уже стартует или идет процесс остановки то ничего не делаем (исключается многократный заход в функцию)
		journal.jprintf_date( "  Start . . .\n");
	} else {
		if(get_State() != pWAIT_HP) return; // Если состяние НЕ РАВНО ожиданию то ничего не делаем, выходим восстанавливать нечего
		journal.jprintf_date( "  Resume . . .\n");
	}
	setState(pSTARTING_HP);                              // Производится старт -  устанавливаем соответсвующее состояние
	//  Если требуется сбрасываем инвертор  (проверям ошибку и пишем в журнал)
	eraseError();                                      // Обнулить ошибку только после сброса инвертора! иначе она может повторно возникнет при ошибке инвертора

	Status.ret = pNone;                                    // Состояние алгоритма
	lastEEV = -1;                                          // -1 это признак того что слежение eev еще не рабоатет (выключения компрессора  небыло)

	if(startPump)                                      // Если задача не остановлена то остановить (0 - останов задачи, 1 - запуск, 2 - в работе (выкл), 3 - в работе (вкл))
	{
		startPump = 0;                                     // Поставить признак останова задачи насос
	    if(get_workPump()) journal.jprintf(" %s: Pumps in pause %s. . .\n",(char*)__FUNCTION__, "OFF");
	}

	offBoiler = 0;                                         // Бойлер никогда не выключался
	onSalmonella = false;                                  // Если true то идет Обеззараживание
	onBoiler = false;                                      // Если true то идет нагрев бойлера
	SETBIT0(flags, fHP_BoilerTogetherHeat);

	// 2.1 Проверка конфигурации, которые можно поменять из морды, по этому проверяем всегда ----------------------------------------
	if(!CheckAvailableWork())   // Нет работы для ТН - ничего не включено
	{
		setState(pOFF_HP);  // Еще ничего не сделали по этому сразу ставим состоение выключено
		set_Error(ERR_NO_WORK, (char*) __FUNCTION__);
		return;
	}
    if(get_State() != pSTARTING_HP) return;            // Могли нажать кнопку стоп, выход из процесса запуска
#ifdef EEV_DEF
	if((!sADC[PEVA].get_present()) && (dEEV.get_ruleEEV() == TEVAOUT_PEVA))  //  Отсутвует датчик давления, и выбран алгоритм ЭРВ который его использует",
	{
		setState(pOFF_HP);    // Еще ничего не сделали по этому сразу ставим состоение выключено
		set_Error(ERR_PEVA_EEV, (char*) __FUNCTION__);        // остановить по ошибке;
		return;
	}
#endif

	// 2.2 Проверка конфигурации, которые определены конфигом (поменять нельзя), по этому проверяем один раз при страте ТН ----------------------------------------
	if(start)  // Команда старт
	{
		if(!dRelay[PUMP_OUT].get_present())  // отсутсвует насос на конденсаторе, пользователь НЕ может изменить в процессе работы проверка при старте
		{
			setState(pOFF_HP);    // Еще ничего не сделали по этому сразу ставим состоение выключено
			set_Error(ERR_PUMP_CON, (char*) __FUNCTION__);        // остановить по ошибке;
			return;
		}
		if(!dRelay[PUMP_IN].get_present())   // отсутсвует насос на испарителе, пользователь может изменить в процессе работы
		{
			setState(pOFF_HP);    // Еще ничего не сделали по этому сразу ставим состоение выключено
			set_Error(ERR_PUMP_EVA, (char*) __FUNCTION__);        // остановить по ошибке;
			return;
		}
		if((!dRelay[RCOMP].get_present()) && (!dFC.get_present()))   // отсутсвует компрессор, пользователь может изменить в процессе работы
		{
			setState(pOFF_HP);    // Еще ничего не сделали по этому сразу ставим состоение выключено
			set_Error(ERR_NO_COMPRESS, (char*) __FUNCTION__);        // остановить по ошибке;
			return;
		}
	} //  if (start)  // Команда старт

	// 3.  ПОДГОТОВКА ------------------------------------------------------------------------

	if(start)  // Команда старт - Инициализация ЭРВ и очистка графиков при восстановлени не нужны
	{
#ifdef EEV_DEF
		//journal.jprintf(" EEV init\n");
		if(get_State() != pSTARTING_HP) return;            // Могли нажать кнопку стоп, выход из процесса запуска
		else dEEV.Start();                                     // Включить ЭРВ  найти 0 по завершению позиция 0!!!
#endif

#ifdef CLEAR_CHART_HP_ON
		journal.jprintf(" Charts clear and start\n");
		if (get_State()!=pSTARTING_HP) return ;            // Могли нажать кнопку стоп, выход из процесса запуска
		else clearChart();// Запустить графики <- тут не запуск, тут очистка
#endif

	}

	// 4. Определяем что нужно делать -----------------------------------------------------------
	if(get_State() != pSTARTING_HP) return;            // Могли нажать кнопку стоп, выход из процесса запуска
	MODE_HP mod = get_Work();                                   // определяем что делаем с компрессором
	if(mod > pBOILER) mod = pOFF;                              // При первом пуске могут быть только состояния pOFF,pHEAT,pCOOL,pBOILER
	journal.jprintf(" Start modWork:%d[%s]\n", (int) mod, codeRet[Status.ret]);
	Status.modWork = mod;  // Установка режима!

	//  set_Error(ERR_PEVA_EEV,(char*)__FUNCTION__);        // остановить по ошибке для проверки EEV


	// 5. Если не старт ТН то проверка на минимальную паузу между включениями, при включении ТН паузе не будет -----------------
	if(!start)  // Команда Resume
		while(check_compressor_pause()) {
			_delay(100 * 1000);
			if(get_State() != pSTARTING_HP) return;
		}    // Могли нажать кнопку стоп, выход из процесса запуска

	//  6. Конфигурируем 3 и 4-х клапаны и включаем насосы ПАУЗА после включения насосов
	if(!configHP(Status.modWork)) return;

	// 7. Включение компрессора и запуск обновления EEV -----------------------------------------------------
	if(get_State() != pSTARTING_HP) return;            // Могли нажать кнопку стоп, выход из процесса запуска
	if(is_next_command_stop()) return;			    // следующая команда останов, выходим
#ifdef USE_ELECTROMETER_SDM
	if(!dSDM.get_link()) dSDM.uplinkSDM();
#endif

	bool start_compressor_now = mod && mod <= pBOILER; // pCOOL or pHEAT or pBOILER
	if(start_compressor_now) {
#ifndef DEMO   // проверка блокировки инвертора
		if((dFC.get_present()) && (dFC.get_blockFC()))          // есть инвертор но он блокирован
		{
			if(dFC.get_err() != ERR_485_BUZY) {
				journal.jprintf("%s: is blocked, ignore start\n", dFC.get_name());
				set_Error(ERR_MODBUS_BLOCK, (char*) __FUNCTION__);          // ВОТ ЗДЕСЬ КОМАНДА СТОП И ПРОЙДЕТ
				return;
			}
		}
#endif
	}
	if(get_errcode() != OK)                                 // ОШИБКА перед стартом
	{
		journal.jprintf(" Error %d before start compressor!\n", get_errcode());
		set_Error(ERR_COMP_ERR, (char*) __FUNCTION__);
		return;
	}
	if(start_compressor_now) compressorON(); // Компрессор включить если нет ошибок и надо включаться

	// 10. Сохранение состояния  -------------------------------------------------------------------------------
	if(get_State() != pSTARTING_HP) return;                   // Могли нажать кнопку стоп, выход из процесса запуска
	setState(pWORK_HP);

	// 11. Запуск задачи обновления ТН ---------------------------------------------------------------------------
	if(start) {
		journal.jprintf(" Start task UpdateHP\n");
		Task_vUpdate_run = true;
		vTaskResume(xHandleUpdate);                                       // Запустить задачу Обновления ТН, дальше она все доделает
		//_delay(1);
	}

	// 12. насос запущен -----------------------------------------------------------------------------------------
	journal.jprintf_time("%s ON . . .\n", (char*) nameHeatPump);

	return;
}

// STOP/WAIT -----------------------------------------
// Функция Останова/Ожидания ТН  - возвращает код ошибки
// Параметр задает что делаем true-останов, false-ожидание
void HeatPump::StopWait(boolean stop)
{  
  if (stop)
  {
    if ((get_State()==pOFF_HP)||(get_State()==pSTOPING_HP)) return;    // Если ТН выключен или выключается ничего не делаем
    journal.jprintf_date("Stopping...\n");
    setState(pSTOPING_HP);  // Состояние выключения
  } else {
    if ((get_State()==pOFF_HP)||(get_State()==pSTOPING_HP)||(get_State()==pWAIT_HP)) return;    // Если ТН выключен или выключается или ожидание ничего не делаем
    journal.jprintf_date("Switch to waiting...\n");
    setState(pSTOPING_HP);  // Состояние выключения
  }

  journal.jprintf(" modWork: %X[%s]\n", get_modWork(), codeRet[Status.ret]);
  compressorOFF();		// Останов компрессора, насосов - PUMP_OFF(), ЭРВ

  if (stop) //Обновление ТН отключаем только при останове
  {
	Task_vUpdate_run = false;					        // Остановить задачу обновления ТН vUpdate (xHandleUpdate)
    journal.jprintf(" Stop task UpdateHP\n");
#ifdef USE_SUN_COLLECTOR
	Sun_OFF();											// Выключить СК
	time_Sun = GetTickCount() - uint32_t(Option.SunMinPause * 1000);	// выключить задержку последующего включения
#endif
  }
    
  if(startPump)
  {
     startPump = 0;                                    // Поставить признак что насос выключен
     if(get_workPump()) journal.jprintf(" %s: Pumps in pause %s. . .\n",(char*)__FUNCTION__, "OFF");
  }

 // Принудительное выключение отдельных узлов ТН если они есть в конфиге
  #ifdef RBOILER  // управление дополнительным ТЭНом бойлера
     dRelay[RBOILER].set_OFF();  // выключить тен бойлера
  #endif

  #ifdef RHEAT  // управление  ТЭНом отопления
     dRelay[RHEAT].set_OFF();     // выключить тен отопления
  #endif

  #ifdef RPUMPB  // управление  насосом циркуляции ГВС
     dRelay[RPUMPB].set_OFF();     // выключить насос циркуляции ГВС
  #endif

  #ifdef RPUMPBH  // управление  насосом нагрева ГВС
     dRelay[RPUMPBH].set_OFF();
  #endif
  SETBIT0(flags, fHP_BoilerTogetherHeat);

  #ifdef CONFIG_5  // случаи бывают разные - должно работать без костылей.- но лучше перебдеть -))
   relayAllOFF(); // Все выключить, все (на всякий случай), * внимание - выключатся реле по расписанию!
  #endif 
 
  if(stop)
  {
     //journal.jprintf(" statChart stop\n");
     setState(pOFF_HP);
     journal.jprintf_time("%s OFF . . .\n",(char*)nameHeatPump);
  } else {
     setState(pWAIT_HP);
     journal.jprintf_time("%s WAIT . . .\n",(char*)nameHeatPump);
  }
#ifdef AUTO_START_GENERATOR
  dRelay[RGEN].set_OFF();
#endif
  return;
}

// Инициализировать переменные ПИД регулятора
void HeatPump::resetPID()
{
#ifdef PID_FORMULA2
	pidw.PropOnMeasure = DEF_FC_PID_P_ON_M;
	pidw.pre_err = Status.modWork & pHEAT ? Prof.Heat.tempPID - FEED : Status.modWork & pBOILER ?
#ifdef SUPERBOILER
			Prof.Boiler.tempPID - PressToTemp(PCON)
#else
			Prof.Boiler.tempPID - FEED
#endif
			: Prof.Cool.tempPID - FEED;
	pidw.sum = dFC.get_target() * 1000;
	pidw.min = dFC.get_minFreq() * 1000;
	pidw.max = dFC.get_maxFreq() * 1000;
#else
	pidw.pre_err = 0;
	pidw.sum = 0;
	pidw.max = 0;   // ПИД может менять частоту без ограничений
#endif
	updatePidTime = updatePidBoiler = xTaskGetTickCount();                // время обновления ПИДа
	// ГВС Сбросить переменные пид регулятора
}


#ifdef RBOILER  // управление дополнительным ТЭНом бойлера
// Проверка на необходимость греть бойлер дополнительным теном (true - надо греть) ВСЕ РЕЖИМЫ
boolean HeatPump::boilerAddHeat()
{
	if(get_State() != pWORK_HP) return false; // работа ТЭНа бойлера разрешена если только работает ТН, в противном случае выкл
	if (!is_BoilerHeaterAllowed())  { // если переключение на ходу на резервный источник то сбросить догрев бойлера
		flagRBOILER = false;
		return false;
	}
	int16_t T = sTemp[TBOILER].get_Temp();
	if((GETBIT(Prof.SaveON.flags, fBoilerON)) && (GETBIT(Prof.Boiler.flags, fSalmonella))) // Сальмонелла не взирая на расписание если включен бойлер (запрет ТЭНа на генераторе проверен выше)
	{
		if((rtcSAM3X8.get_day_of_week() == SALMONELLA_DAY) && (rtcSAM3X8.get_hours() == SALMONELLA_HOUR) && (rtcSAM3X8.get_minutes() <= 2) && (!onSalmonella)) { // Надо начитать процесс обеззараживания
			startSalmonella = rtcSAM3X8.unixtime();
			onSalmonella = true;
			journal.jprintf(" Cycle start salmonella, %.2dC°\n", sTemp[TBOILER].get_Temp());
		}
		if(onSalmonella) {   // Обеззараживание нужно
			if(startSalmonella + SALMONELLA_TIME > rtcSAM3X8.unixtime()) { // Время цикла еще не исчерпано
				if(T < SALMONELLA_TEMP) return true; // Включить обеззараживание
#ifdef SALMONELLA_HARD
				else if (T > SALMONELLA_TEMP+50) return false; else return dRelay[RBOILER].get_Relay(); // Вариант работы - Стабилизация температуры обеззараживания, гистерезис 0.5 градуса
#else
				else {  // Вариант работы только до достижение темперaтуpы и сразу выключение
					onSalmonella = false;
					startSalmonella = 0;
					journal.jprintf(" Salmonella cycle finished, %.2dC°\n", sTemp[TBOILER].get_Temp());
					return false;
				}
#endif
			} else {  // Время вышло, выключаем, и идем дальше по алгоритму
				onSalmonella = false;
				startSalmonella = 0;
				journal.jprintf(" Salmonella cycle end, %.2dC°\n", sTemp[TBOILER].get_Temp());
			}
		}
	} else if(onSalmonella) { // если сальмонеллу отключили на ходу выключаем и идем дальше по алгоритму
		onSalmonella = false;
		startSalmonella = 0;
		journal.jprintf(" Off salmonella\n");
	}

	// Догрев бойлера

	if(GETBIT(Prof.SaveON.flags, fBoilerON) && scheduleBoiler()) // Если разрешено греть бойлер согласно расписания И Бойлер включен
	{
		if(GETBIT(Prof.Boiler.flags, fTurboBoiler))  // Если турбо режим, то повторяем за Тепловым насосом (грет или не греть)
		{
			if(T < Prof.Boiler.tempRBOILER) return onBoiler;   // работа параллельно с ТН  если температура МЕНЬШЕ догрева то повторяем работу ТН
		}
		if(GETBIT(Prof.Boiler.flags, fAddHeating))  // Включен догрев
		{
			int16_t b_target = get_boilerTempTarget();
			if(!flagRBOILER && (T < b_target - (HeatBoilerUrgently ? 10 : Prof.Boiler.dTemp))) {  // Бойлер ниже гистерезиса - ставим признак необходимости включения Догрева (но пока не включаем ТЭН)
			    flagRBOILER = true;
				return false;
			}
			if(!flagRBOILER || onBoiler) return false; // флажка нет или работет бойлер, но догрев не включаем
			else {
				if(T < b_target && (T >= Prof.Boiler.tempRBOILER - Prof.Boiler.dAddHeat || dRelay[RBOILER].get_Relay() || GETBIT(Prof.Boiler.flags, fAddHeatingForce))) {  // Греем тэном
					return true;
				} else { // бойлер выше целевой температуры - цель достигнута или греть тэном еще рано
					flagRBOILER = false;
					return false;
				}
			}
		} else { // ТЭН не используется (сняты все флажки)
			flagRBOILER = false;
			return false;
		}
	} else { // Бойлер сейчас запрещен
		flagRBOILER = false;
		return false;
	}

}
#endif

// Проверить расписание бойлера true - нужно греть false - греть не надо, если расписание выключено то возвращает true
boolean HeatPump::scheduleBoiler()
{
	if(HeatBoilerUrgently) return true;
	if(GETBIT(Prof.Boiler.flags, fSchedule))         // Если используется расписание
	{  // Понедельник 0 воскресенье 6 это кодирование в расписании функция get_day_of_week возвращает 1-7
		boolean b = Prof.Boiler.Schedule[rtcSAM3X8.get_day_of_week() - 1] & (0x01 << rtcSAM3X8.get_hours()) ? true : false;
		if(!b) return false;             // запрещено греть бойлер согласно расписания
	}
	return true;
}

// Управление температурой в зависимости от режима
#define STR_REDUCED "Reduced FC"   // Экономим место
#define STR_FREQUENCY " FC> %.2f\n" // Экономим место
// Итерация по управлению Бойлером
// возврат что надо делать компрессору, функция НЕ управляет компрессором а только выдает необходимость включения компрессора
MODE_COMP  HeatPump::UpdateBoiler()
{
#ifdef RBOILER  // управление дополнительным ТЭНом бойлера
	if(boilerAddHeat()) { // Дополнительный нагреватель бойлера - нужно греть
		if(get_State() == pOFF_HP || get_State() == pSTOPING_HP) { // Если ТН выключен или выключается
			dRelay[RBOILER].set_OFF();
			flagRBOILER = false;
			return pCOMP_OFF;
		}
		if(is_BoilerHeaterAllowed()) {   // Включение ТЭНа бойлера если он не запрещен (генератор + fWorkOnGenerator)
			dRelay[RBOILER].set_ON();
			#ifdef RPUMPBH
			if(!onBoiler && GETBIT(flags, fHP_BoilerTogetherHeat)) dRelay[RPUMPBH].set_OFF();   // насос ГВС - выключить
			#endif
			SETBIT0(flags, fHP_BoilerTogetherHeat);
		}
		if(!GETBIT(Prof.Boiler.flags, fTurboBoiler)) return pCOMP_OFF;
	} else {
		if(dRelay[RBOILER].get_Relay()) set_HeatBoilerUrgently(false);
		dRelay[RBOILER].set_OFF();
		if(get_State() == pOFF_HP || get_State() == pSTOPING_HP) { // Если ТН выключен или выключается
			return pCOMP_OFF;
		}
	}
#else
	if(get_State() == pOFF_HP || get_State() == pSTOPING_HP) { // Если ТН выключен или выключается
		return pCOMP_OFF;
	}
#endif
	if(!GETBIT(Prof.SaveON.flags,fBoilerON) || (!scheduleBoiler() && !GETBIT(Prof.Boiler.flags,fScheduleAddHeat))) // Если запрещено греть бойлер согласно расписания ИЛИ  Бойлер выключен, выходим и можно смотреть отопление
	{
#ifdef RBOILER  // управление дополнительным ТЭНом бойлера
		if(GETBIT(Prof.Boiler.flags, fAddHeating)) {
			dRelay[RBOILER].set_OFF();
			flagRBOILER=false; // Выключение
		}
#endif
#ifdef RPUMPBH
		if(GETBIT(flags, fHP_BoilerTogetherHeat)) {
			dRelay[RPUMPBH].set_OFF();   // насос ГВС - выключить
			SETBIT0(flags, fHP_BoilerTogetherHeat);
		}
#endif
		return pCOMP_OFF;      // запрещено греть бойлер согласно расписания
	}

	// -----------------------------------------------------------------------------------------------------
	// Сброс излишней энергии в систему отопления по температуре подачи/конденсации
	// Переключаемся на отопление на ходу и ждем определенное число секунд, дальше возвращаемся на бойлер
	if(GETBIT(Prof.Boiler.flags,fResetHeat))    // Стоит требуемая опция - Сброс тепла в СО
	{
		if(Status.prev == pBdis) {
			if(offBoiler + Prof.Boiler.Reset_Time < rtcSAM3X8.unixtime()) {
#ifdef DEBUG_MODWORK
				journal.jprintf(" Boiler: Discharged Ok\n");
#endif
				switchBoiler(true);    // Переключиться на ходу на ГВС
			} else {
				Status.ret = pBdis;
				return pCOMP_NONE;
			}
		} else if(
#ifdef SUPERBOILER
		   PressToTemp(PCON)
#else
		   FEED
#endif
		   > Prof.Boiler.tempInLim - Prof.Boiler.DischargeDelta * 10
		   || (sTemp[TCOMP].get_Temp() > sTemp[TCOMP].get_maxTemp() - BOILER_TEMP_COMP_RESET)) // температура нагнетания компрессора больше максимальной -5 градусов
		{
#ifdef DEBUG_MODWORK
			journal.jprintf(" Boiler: Discharging %ds...\n", Prof.Boiler.Reset_Time);
#endif
			switchBoiler(false);       // Переключиться на ходу на отопление
			Status.ret = pBdis;
			return pCOMP_NONE;
		}
	}

	int16_t T = sTemp[TBOILER].get_Temp();  // текущая температура
	int16_t TRG = get_boilerTempTarget();   // целевая температура
#ifdef RPUMPBH
	if(GETBIT(Prof.Boiler.flags, fBoilerTogetherHeat) && (Status.modWork & pHEAT)) { // Режим одновременного нагрева бойлера с отоплением до температуры догрева
		if(!is_compressor_on() || T > TRG) {
			dRelay[RPUMPBH].set_OFF();   // насос ГВС - выключить
			SETBIT0(flags, fHP_BoilerTogetherHeat);
		} else if(FEED > T + HYSTERESIS_BoilerTogetherHeatSt) {
			SETBIT1(flags, fHP_BoilerTogetherHeat);
			dRelay[RPUMPBH].set_ON();    // насос ГВС - включить
			return pCOMP_OFF;
		} else if(FEED <= T + HYSTERESIS_BoilerTogetherHeatEn) {
			dRelay[RPUMPBH].set_OFF();   // насос ГВС - выключить
			SETBIT0(flags, fHP_BoilerTogetherHeat);
		} else return pCOMP_OFF;
	}
#endif

	// Алгоритм гистерезис для старт стоп
	if(!dFC.get_present() || !GETBIT(Prof.Boiler.flags, fBoilerPID)) // Алгоритм гистерезис для старт стоп и по опции
	{
		if(FEED>Prof.Boiler.tempInLim) {
			Status.ret=pBh1; return pCOMP_OFF;    // Достигнута максимальная температура подачи ВЫКЛ
		}

		// Отслеживание выключения (с учетом догрева)
		if(!GETBIT(Prof.Boiler.flags, fTurboBoiler) && GETBIT(Prof.Boiler.flags, fAddHeating) && is_BoilerHeaterAllowed())// режим догрева (если ТЭН разрешен), не турбо
		{
			if (T > Prof.Boiler.tempRBOILER - (onBoiler || HeatBoilerUrgently ? 0 : Prof.Boiler.dAddHeat)) {
				Status.ret=pBh22; return pCOMP_OFF; // Температура выше целевой температуры ДОГРЕВА надо выключаться!
			}
		}
		if (T > TRG) {
			Status.ret=pBh3;
			set_HeatBoilerUrgently(false);
			return pCOMP_OFF;  // Температура выше целевой температуры БОЙЛЕРА надо выключаться!
		}
		// Отслеживание включения
		if (!onBoiler && T < TRG - (HeatBoilerUrgently ? 10 : Prof.Boiler.dTemp)) {Status.ret=pBh2; return pCOMP_ON;} // Температура ниже гистерезиса надо включаться!

		// дошли до сюда значить сохранение предыдущего состяния, температура в диапазоне регулирования может быть или нагрев или остывание
		if (onBoiler) {Status.ret=pBh4; return pCOMP_NONE;}  // Если включен принак работы бойлера (трехходовой) значит ПРОДОЛЖНЕНИЕ нагрева бойлера
		Status.ret=pBh5; return pCOMP_OFF;// продолжение ПАУЗЫ бойлера внутри гистерезиса

	} else {
	// Инвертор ПИД
#if defined(SUPERBOILER) && defined(PCON)
		if(PressToTemp(PCON) > Prof.Boiler.tempInLim) {
#else
 		if(FEED>Prof.Boiler.tempInLim) {
#endif
			Status.ret=pBp1; set_Error(ERR_PID_FEED,(char*)__FUNCTION__); return pCOMP_OFF;  // Достижение максимальной температуры подачи
		}
		// Отслеживание выключения (с учетом догрева)
		if(!GETBIT(Prof.Boiler.flags, fTurboBoiler) && GETBIT(Prof.Boiler.flags, fAddHeating) && is_BoilerHeaterAllowed())// режим догрева (если ТЭН разрешен), не турбо
		{
			if (T > Prof.Boiler.tempRBOILER - (onBoiler || HeatBoilerUrgently ? 0 : Prof.Boiler.dAddHeat)) {
				Status.ret=pBp22; return pCOMP_OFF;  // Температура выше целевой температуры ДОГРЕВА надо выключаться!
			}
		}
		if (T > TRG) {
			Status.ret=pBp3;
			set_HeatBoilerUrgently(false);
			return pCOMP_OFF;  // Температура выше целевой температуры БОЙЛЕРА надо выключаться!
		} else if(!onBoiler && T < TRG - (HeatBoilerUrgently ? 10 : Prof.Boiler.dTemp)) { // Отслеживание включения
			Status.ret=pBp2; return pCOMP_ON; // Достигнут гистерезис и компрессор еще не работает на ГВС - Старт бойлера
		} else if (is_compressor_on() &&(!(onBoiler))) return pCOMP_OFF;// компрессор работает, но ГВС греть не надо  - уходим без изменения состояния
		
		// ПИД ----------------------------------
        // Питание от резервного источника - ограничение мощности потребления от источника - это жесткое ограничение, по этому оно первое
        else if((GETBIT(Option.flags,fBackupPower))&&(getPower()>get_maxBackupPower())) { // Включено ограничение мощности и текущая мощность уже выше ограничения - надо менять частоту
#ifdef DEBUG_MODWORK
        	journal.jprintf("%s %.2f (BACKUP POWER: %.3f kW)\n",STR_REDUCED,dFC.get_stepFreqBoiler()/100.0,(float)getPower()/1000.0); // КИЛОВАТЫ
#endif
			if (dFC.get_target()-dFC.get_stepFreqBoiler()<dFC.get_minFreqBoiler())  { Status.ret=pBp29; return pCOMP_OFF; }   // Уменьшать дальше некуда, выключаем компрессор
			Status.ret=pBp28;
			dFC.set_target(dFC.get_target()-dFC.get_stepFreqBoiler(),true,dFC.get_minFreqBoiler(),dFC.get_maxFreqBoiler());   // Уменьшить частоту
			resetPID();
			return pCOMP_NONE;
        }		
        
		// ЗАЩИТА Компресор работает, достигнута максимальная температура подачи, мощность, температура компрессора то уменьшить обороты на stepFreq
#if defined(SUPERBOILER) && defined(PCON)
		else if (is_compressor_on() &&(PressToTemp(PCON)>Prof.Boiler.tempInLim-dFC.get_dtTempBoiler())) // Ограничение, по температуре нагнетания для SUPERBOILER.
#else
		else if (is_compressor_on() &&(FEED>Prof.Boiler.tempInLim-dFC.get_dtTempBoiler()))             // Подача ограничение
#endif
		{
#ifdef DEBUG_MODWORK
			journal.jprintf("%s %.2f (FEED: %.2f)\n",STR_REDUCED,dFC.get_stepFreqBoiler()/100.0,FEED/100.0);
#endif
			if (dFC.get_target()-dFC.get_stepFreqBoiler()<dFC.get_minFreqBoiler()) { Status.ret=pBp23; return pCOMP_OFF; }     // Уменьшать дальше некуда, выключаем компрессор
			Status.ret=pBp6;
			dFC.set_target(dFC.get_target()-dFC.get_stepFreqBoiler(),true,dFC.get_minFreqBoiler(),dFC.get_maxFreqBoiler());    // Уменьшить частоту
			resetPID();
			return pCOMP_NONE;
		}
		else if (is_compressor_on() &&(dFC.get_power()>FC_MAX_POWER_BOILER))                    // Мощность для ГВС меньшая мощность
		{
#ifdef DEBUG_MODWORK
			journal.jprintf("%s %.2f (POWER: %.3f kW)\n",STR_REDUCED,dFC.get_stepFreqBoiler()/100.0,(float)dFC.get_power()/1000.0); // КИЛОВАТЫ
#endif
			if (dFC.get_target()-dFC.get_stepFreqBoiler()<dFC.get_minFreqBoiler())  { Status.ret=pBp24; return pCOMP_OFF; }    // Уменьшать дальше некуда, выключаем компрессор
			Status.ret=pBp7;
			dFC.set_target(dFC.get_target()-dFC.get_stepFreqBoiler(),true,dFC.get_minFreqBoiler(),dFC.get_maxFreqBoiler());    // Уменьшить частоту
			resetPID();
			return pCOMP_NONE;
		}
		else if (is_compressor_on() &&(dFC.get_current()>FC_MAX_CURRENT_BOILER))                // ТОК для ГВС меньшая мощность
		{
#ifdef DEBUG_MODWORK
			journal.jprintf("%s %.2f (CURRENT: %.2f)\n",STR_REDUCED,dFC.get_stepFreqBoiler()/100.0,(float)dFC.get_current()/100.0);
#endif
			if (dFC.get_target()-dFC.get_stepFreqBoiler()<dFC.get_minFreqBoiler()) { Status.ret=pBp27; return pCOMP_OFF;  }    // Уменьшать дальше некуда, выключаем компрессор
			Status.ret=pBp16;
			dFC.set_target(dFC.get_target()-dFC.get_stepFreqBoiler(),true,dFC.get_minFreqBoiler(),dFC.get_maxFreqBoiler());    // Уменьшить частоту
			resetPID();
			return pCOMP_NONE;
		}

		else if (is_compressor_on() &&((sTemp[TCOMP].get_Temp()+dFC.get_dtCompTemp())>sTemp[TCOMP].get_maxTemp()))  // температура компрессора
		{
#ifdef DEBUG_MODWORK
			journal.jprintf("%s %.2f (TCOMP: %.2f)\n",STR_REDUCED,dFC.get_stepFreqBoiler()/100.0,sTemp[TCOMP].get_Temp()/100.0);
#endif
			if (dFC.get_target()-dFC.get_stepFreqBoiler()<dFC.get_minFreqBoiler()) { Status.ret=pBp25; return pCOMP_OFF; }     // Уменьшать дальше некуда, выключаем компрессор
			Status.ret=pBp8;
			dFC.set_target(dFC.get_target()-dFC.get_stepFreqBoiler(),true,dFC.get_minFreqBoiler(),dFC.get_maxFreqBoiler());    // Уменьшить частоту
			resetPID();
			return pCOMP_NONE;
		}
#ifdef PCON			
		else if (is_compressor_on() &&(sADC[PCON].get_present())&&(sADC[PCON].get_Value()>sADC[PCON].get_maxValue()-FC_DT_CON_PRESS)) // давление конденсатора до максимальной минус 0.5 бара
		{
#ifdef DEBUG_MODWORK
			journal.jprintf("%s %.2f (PCON:  %.2f)\n",STR_REDUCED,dFC.get_stepFreqBoiler()/100.0,sADC[PCON].get_Value()/100.0);
#endif
			if (dFC.get_target()-dFC.get_stepFreqBoiler()<dFC.get_minFreqBoiler()) { Status.ret=pBp26; return pCOMP_OFF; }     // Уменьшать дальше некуда, выключаем компрессор
			Status.ret=pBp9;
			dFC.set_target(dFC.get_target()-dFC.get_stepFreqBoiler(),true,dFC.get_minFreqBoiler(),dFC.get_maxFreqBoiler());    // Уменьшить частоту
			resetPID();
			return pCOMP_NONE;
		}
#endif		
		else if(!is_compressor_on()) { Status.ret=pBp5; return pCOMP_OFF; }                                                    // Если компрессор не работает, то ничего не делаем и выходим
		else if(rtcSAM3X8.unixtime() - dFC.get_startTime() < FC_START_PID_DELAY/100 ) {	Status.ret=pBp10; return pCOMP_NONE; } // РАЗГОН частоту не трогаем
		else if(xTaskGetTickCount()-updatePidBoiler < get_timeBoiler()*1000)          { Status.ret=pBp11; return pCOMP_NONE; } // время обновления ПИДа еше не пришло

		// Дошли до сюда - ПИД на подачу. Компресор работает
		updatePidBoiler=xTaskGetTickCount();
#ifdef SUPERBOILER
		Status.ret=pBp14;
        int16_t newFC = updatePID((Prof.Boiler.tempPID - PressToTemp(PCON)), Prof.Boiler.pid, pidw); // Одна итерация ПИД регулятора (на выходе ИЗМЕНЕНИЕ частоты)
#else
		Status.ret=pBp12;
		int16_t newFC = updatePID(Prof.Boiler.tempPID - FEED, Prof.Boiler.pid, pidw);             // Одна итерация ПИД регулятора (на выходе ИЗМЕНЕНИЕ частоты)
#endif
#ifdef PID_FORMULA2
		if(newFC > dFC.get_target() + dFC.get_PidFreqStep()) newFC = dFC.get_target() + dFC.get_PidFreqStep(); // На увеличение
		//else if(newFC < dFC.get_target() - dFC.get_PidFreqStep()) newFC = dFC.get_target() - dFC.get_PidFreqStep(); // На уменьшение
#else
		if (newFC>dFC.get_PidFreqStep()) newFC=dFC.get_target()+dFC.get_PidFreqStep(); else newFC +=dFC.get_target(); // Расчет целевой частоты с ограничением на ее рост не более dFC.get_PidFreqStep()
#endif
		if (newFC>dFC.get_maxFreqBoiler())   newFC=dFC.get_maxFreqBoiler();                                                 // ограничение диапазона ОТДЕЛЬНО для ГВС!!!! (меньше мощность)
		if (newFC<dFC.get_minFreqBoiler())   newFC=dFC.get_minFreqBoiler(); //return pCOMP_OFF;                             // Уменьшать дальше некуда, выключаем компрессор
	    if(GETBIT(Option.flags, fBackupPower) && newFC > dFC.get_maxFreqGen()) newFC = dFC.get_maxFreqGen();

		// Смотрим подход к границе защит если идет УВЕЛИЧЕНИЕ частоты
		if (dFC.get_target()<newFC && dFC.get_PidStop() < 100 && is_compressor_on())                                                                                     // Идет увеличение частоты проверяем подход к границам
		{
//			if (&&(FEED>(Prof.Boiler.tempInLim-dFC.get_dtTempBoiler())*dFC.get_PidStop()/100))                                                 {Status.ret=pBp17; resetPID(); return pCOMP_NONE;}   // Подача ограничение
			if ((dFC.get_power()>(FC_MAX_POWER_BOILER*dFC.get_PidStop()/100)))                                                            {Status.ret=pBp18; resetPID(); return pCOMP_NONE;}   // Мощность для ГВС меньшая мощность
			if ((dFC.get_current()>(FC_MAX_CURRENT_BOILER*dFC.get_PidStop()/100)))                                                        {Status.ret=pBp19; resetPID(); return pCOMP_NONE;}   // ТОК для ГВС меньшая мощность
			if (((sTemp[TCOMP].get_Temp()+dFC.get_dtCompTemp())>(sTemp[TCOMP].get_maxTemp()*dFC.get_PidStop()/100)))                      {Status.ret=pBp20; resetPID(); return pCOMP_NONE;}   // температура компрессора
			if ((sADC[PCON].get_present())&&(sADC[PCON].get_Value()>((sADC[PCON].get_maxValue()-FC_DT_CON_PRESS)*dFC.get_PidStop()/100))) {Status.ret=pBp21; resetPID(); return pCOMP_NONE;}   // давление конденсатора до максимальной минус 0.5 бара
		}
		//    надо менять
		if (dFC.get_target()!=newFC)                                                                                     // Установка частоты если нужно менять
		{
#ifdef DEBUG_MODWORK
			journal.jprintf((char*)STR_FREQUENCY,newFC/100.0);
#endif
			dFC.set_target(newFC,false,dFC.get_minFreqBoiler(),dFC.get_maxFreqBoiler());
		}
		return pCOMP_NONE;
	}

}
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
