pav2000/ControlHeatPump/Control/StepMotor.ino

/*
 * Copyright (c) 2016-2023 by Pavel Panfilov <firstlast2007@gmail.com> skype pav2000pav
 * &                       by Vadim Kulakov vad7@yahoo.com, vad711
 * "Народный контроллер" для тепловых насосов.
 * Данное програмноое обеспечение предназначено для управления 
 * различными типами тепловых насосов для отопления и ГВС.
 *
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
 * This file is distributed in the hope that it will be useful,
 * but WITHOUT ANY WARRANTY; without even the implied warranty of
 * MERCHANTABILITY or FITNESS FOR A PARTICULAR PURPOSE.See the
 * GNU General Public License for more details.
 */
#include "StepMotor.h"

void StepMotor::initStepMotor(int number_of_steps, int motor_pin_1, int motor_pin_2, int motor_pin_3, int motor_pin_4)
{
	this->number_of_steps = number_of_steps; // total number of steps for this motor
	this->pin_count = 4;
	buzy = false;                              // мотор не двигается

	// Arduino pins for the motor control connection:
	this->motor_pin_1 = motor_pin_1;
	this->motor_pin_2 = motor_pin_2;
	this->motor_pin_3 = motor_pin_3;
	this->motor_pin_4 = motor_pin_4;
	// setup the pins on the microcontroller:
	pinMode(this->motor_pin_1, OUTPUT);
	pinMode(this->motor_pin_2, OUTPUT);
	pinMode(this->motor_pin_3, OUTPUT);
	pinMode(this->motor_pin_4, OUTPUT);
	off();                     // Снять напряжение
}


// Установить скорость поступления шагов
void StepMotor::setSpeed(long whatSpeed)
{
	step_delay = 1000 / whatSpeed; // пересчет на время одного шага в мсек
}


// Движение до steps_to_move 
// На входе АБСОЛЮТНАЯ координата, в очередь уходит АБСОЛЮТНАЯ координата
void StepMotor::step(int steps_to_move)
{
	if(xQueueSend(xCommandQueue, &steps_to_move, 20 / portTICK_PERIOD_MS) == errQUEUE_FULL) // команду на движение в очередь
	{
		journal.jprintf("$ERROR - Step motor command queue is FULL!\n");
		return;
	} else { // В очередь команад попала
		buzy = true;                      // флаг начало движения
		vTaskResume(xHandleStepperEEV);   // Запустить движение если его еще нет
	}
}

// выставить один пин
__attribute__((always_inline)) inline void StepMotor::setPinMotor(int pin, boolean val)
{
#ifdef DRV_EEV_L9333                        // использование драйвера L9333 нужно инвертирование!!!
	digitalWriteDirect(pin, !val);
#else
	digitalWriteDirect(pin, val);
#endif  
}
/*
 * Движение на один шаг  в зависимости от выбранной последовательности
 */
void StepMotor::stepOne(int thisStep)
{
#if EEV_PHASE == PHASE_8s    // движение 8 фаз полушаг (pav2000)
 //  SerialDbg.print("PHASE_8s ");
    switch (thisStep) {
      case 0:  // 0001
        setPinMotor(motor_pin_1, LOW);
        setPinMotor(motor_pin_2, LOW);
        setPinMotor(motor_pin_3, LOW);
        setPinMotor(motor_pin_4, HIGH);
      break;
      case 1:  //1001
        setPinMotor(motor_pin_1, HIGH);
        setPinMotor(motor_pin_2, LOW);
        setPinMotor(motor_pin_3, LOW);
        setPinMotor(motor_pin_4, HIGH);       
      break;
      case 2:  //1000
        setPinMotor(motor_pin_1, HIGH);
        setPinMotor(motor_pin_2, LOW);
        setPinMotor(motor_pin_3, LOW);
        setPinMotor(motor_pin_4, LOW);         
      break;
      case 3:  //1100
        setPinMotor(motor_pin_1, HIGH);
        setPinMotor(motor_pin_2, HIGH);
        setPinMotor(motor_pin_3, LOW);
        setPinMotor(motor_pin_4, LOW);         
      break;
      case 4:  //0100
        setPinMotor(motor_pin_1, LOW);
        setPinMotor(motor_pin_2, HIGH);
        setPinMotor(motor_pin_3, LOW);
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
  digitalWriteDirect(motor_pin_3, HIGH);
  digitalWriteDirect(motor_pin_4, HIGH); 
 #else
  digitalWriteDirect(motor_pin_1, LOW);
  digitalWriteDirect(motor_pin_2, LOW);
  digitalWriteDirect(motor_pin_3, LOW);
  digitalWriteDirect(motor_pin_4, LOW); 
#endif 
     
}
              
