pav2000/ControlHeatPump/Control/Overheat.ino

/*
 * Copyright (c) 2016-2023 by Pavel Panfilov <firstlast2007@gmail.com> skype pav2000pav
 * &                       by Vadim Kulakov vad7@yahoo.com, vad711
 * "Народный контроллер" для тепловых насосов.
 * Данное програмноое обеспечение предназначено для управления 
 * различными типами тепловых насосов для отопления и ГВС.
 *
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
 * This file is distributed in the hope that it will be useful,
 * but WITHOUT ANY WARRANTY; without even the implied warranty of
 * MERCHANTABILITY or FITNESS FOR A PARTICULAR PURPOSE.See the
 * GNU General Public License for more details.
 */
// Таблица Положение ЭРВ от входных температур испарителя и конденсатора(лежат построчно) по гликолю
// EVA - испаритель столбцы (первый индекс)   CON - конденсатор строки (второй индекс)
// берутся средние температуры (IN+OUT)/2 кондесатора и испарителя
// ЗАВИСИТ ОТ КОНКРЕТНОГО ТН!!!!

const uint16_t tableEEVHeat[5][5]=  // Отопление
                              { // <25  25...13 13...3  3...-6   >-6     Испаритель градусы  
                                  450,   450,    450,    450,    450,    // 15<            Конденсатор ПОДАЧА градусы
                                  450,   450,    450,    450,    450,    // 15 ... 25      Конденсатор ПОДАЧА градусы
                                  450,   450,    280,    270,    270,    // 25 ... 43      Конденсатор ПОДАЧА градусы
                                  450,   450,    450,    450,    450,    // 43 ... 55      Конденсатор ПОДАЧА градусы
                                  450,   450,    450,    450,    450,    // >55            Конденсатор ПОДАЧА градусы
                               
                              };         
const uint16_t tableEEVCool[5][5]= // Охлаждение
                              { // <25  25...13 13...3  3...-6   >-6     Испаритель градусы   
                                  450,   450,    450,    450,    450,    // 15<            Конденсатор ПОДАЧА градусы
                                  450,   450,    450,    450,    450,    // 15 ... 25      Конденсатор ПОДАЧА градусы
                                  450,   450,    280,    270,    270,    // 25 ... 43      Конденсатор ПОДАЧА градусы
                                  450,   450,    450,    450,    450,    // 43 ... 55      Конденсатор ПОДАЧА градусы
                                  450,   450,    450,    450,    450,    // >55            Конденсатор ПОДАЧА градусы
                               
                              };                                                   


// Таблицы по фреонам (в тысячных бара)
//#define STEP_TEMP   0.1      // шаг температуры в таблице
#define START_TEMP  -379       // температура первого элемента в таблице. Это минимальное значение кипения!!!  нижний край таблицы, при значениях давленимя ниже (выход за нижнюю границу) выдается это значение температуры
#define SIZEOF_TEMP 10*108     // размерность массива температур Диапазон таблицы от -37.9 до +70 градусов ВСЕГО 108 градусов с шагом 0.1 градус
#define CONST_PRESS 1000 //1013 // Поправка давления для перевода в манометрическое в барах, в тысячных

#if (FREON == R22)
const uint16_t tFREON[SIZEOF_TEMP]={ // R22
1156,1161,1167,1172,1177,1183,1188,1193,1199,1204,1210,1215,1221,1226,1232,1237,1243,1248,1254,1259,1265,1271,1276,1282,1288,1294,1299,1305,1311,1317,1323,1328,1334,1340,1346,1352,1358,1364,1370,1376,
1382,1388,1394,1400,1407,1413,1419,1425,1431,1438,1444,1450,1456,1463,1469,1475,1482,1488,1495,1501,1508,1514,1521,1527,1534,1540,1547,1554,1560,1567,1574,1580,1587,1594,1601,1607,1614,1621,1628,1635, // Добавка для Воздух-Вода ТН еще 8 градусов до -37,9
  
1642,1649,1656,1663,1670,1677,1684,1691,1698,1705,1712,1719,1727,1734,1741,1748,1756,1763,1770,1778,1785,1792,1800,1807,1815,1822,1830,1837,1845,1853,1860,1868,1875,1883,1891,1899,1906,1914,1922,1930,
1938,1946,1954,1962,1970,1978,1986,1994,2002,2010,2018,2026,2034,2042,2051,2059,2067,2075,2084,2092,2101,2109,2117,2126,2134,2143,2151,2160,2169,2177,2186,2194,2203,2212,2221,2229,2238,2247,2256,2265,
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
22117,22162,22207,22253,22299,22344,22390,22436,22482,22528,22574,22620,22666,22713,22759,22805,22852,22898,22945,22992,23038,23085,23132,23179,23226,23273,23321,23368,23415,23463,23510,23558,23605,23653,23701,23749,23796,23844,23893,23941,
23989,24037,24086,24134,24182,24231,24280,24328,24377,24426,24475,24524,24573,24622,24672,24721,24770,24820,24869,24919,24968,25018,25068,25118,25168,25218,25268,25318,25369,25419,25469,25520,25571,25621,25672,25723,25774,25825,25876,25927
};
#endif
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
