pav2000/ControlHeatPump/(commit log)

2018-04-09 945 версия Заливка искодников
2018-04-09 Добавлен Web
2018-04-09 Добавлено описание на контроллер
2018-04-09 Добавлено короткое описание
2018-04-10 Добавлены библиотеки
2018-04-11 Добавлен код переключения ГВС на отопление/охлаждения на ходу. Реализовано отключение некоторых защит в момент переключения. Время блокировки DELAY_BOILER_OFF
2018-04-12 Оптимизация 1-Wire
2018-04-12 Добавлена теплоемкость теплоносителя в контуре
2018-04-12 Исправлена ошибка с конфигом (задвоение) Коэффициент пересчета приведен к размерности имп/литр
    [Config.h, Constant.h, Control.ino, Hardware.h, Hardware.ino, HeatPump.ino, WebServer.ino]
2018-04-12 +теплоемкость в web
2018-04-13 Картинки разных схем отопления
2018-04-16 Баг фиксы обнаруженные при переходе с 0.945 1. Исправлена ошибка отображения графика потока конденсатора 2. Исправлена ошибка вывода в текстовый файл настроек (коэффициент для аналогового датчика) 3.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
    [Config.h, Constant.h, Control.ino, Hardware.ino, HeatPump.ino, getFiles.ino]
2018-04-16 исправлено вывод реле в веб, частотник Vacon
    [VaconFC.h, VaconFC.ino]
2018-04-16 фикс Vacon
2018-04-16 Настройки догрева бойлера перенесены в раздел ГВС из опций Настройка DHCP перенесена в конфиг defaultDHCP
2018-04-16 Наведен порядок с ошибками по модбас Учтены ошибки VACON 10 и Omron MX2
2018-04-16 fix для VACON
2018-04-16 фикс сканировании температуры
2018-04-16 fix парсер смещение после переноса догрева ГВС
    [WebServer.ino]
2018-04-17 Добавлен функционал модификации имен запрашиваемых файлов, теперь в зависимости от конфига показываются на морде разные схемы. мелкие фиксы
2018-04-17 фикс FRAM
2018-04-18 Команды WAIT RESUME для расписания Оптимизация работы ТЭНа бойлера
2018-04-18 тест: чтение/запись произвольных регистров modbus
2018-04-19 фикс срабатывние вачдога при отключенном сетевом кабеле и DHCP (уменьшен тайаут)
2018-04-19 Заглушки для функций modbus парсера
2018-04-19 отладка - страница модбас
2018-04-20 fix 1-wire compiling error
    [Config.h, devOneWire.ino]
2018-04-20 Адрес EEPROM 32k = 0x57
2018-04-23 При инициализации сети добавлена проверка на link (вставленный сетевой кабель)
2018-04-23 Корректировка настроек ГВС
2018-04-24 переделан код ТЭН бойлера переделан код переключения на бойлер (поддержка разных схем)
2018-04-24 фикс расписаний
2018-04-24 Обеззараживание (сальмонелла) фикс расписания и догрева
2018-04-25 фикс расписания
2018-04-25 Уменьшение потребление стека RTOS
2018-04-26 откат функции ftoa, добавление пути на мобильную морду, небольшая оптимизация Ethernet либы, увеличены времена DHCP
2018-04-26 фикс ожидания DHCP, оптимизация сетевой либы
2018-04-26 фикс работы вачдога при DHCP
2018-04-26 Оптимизация использования стека в itoa, vsnprintf, ftoa, замена itoa в SAM библиотеке
2018-04-26 оптимизация vsnprintf
2018-04-27 patch Arduino board SAM library for optimized itoa() function
2018-04-27 фикс DHCP
2018-04-27 Добавлен насос нагрева ГВС RPUMPBH (циркуляции)
2018-04-27 изм. config (vad7)
2018-04-27 фикс расписания - паузы
2018-04-27 Статус слева на веб
2018-04-27 +Насос ТП в веб
2018-04-27 Уменьшены стеки задач, два графика (дельты контуров) переведены на расчет на лету, исправлена ошибка блокировки задач при переходе в режим ожидания
    [Config.h, Constant.h, Control.ino, HeatPump.h, HeatPump.ino, Information.h, Information.ino, getFiles.ino]
2018-04-27 Кнопка очистки статистики времени задач RTOS
2018-04-28 фикс включения RPUMPO
2018-04-28 фикс переход в ожидание при старте
2018-04-28 расписание
2018-04-28 Настройки I2C памяти перенесены в config, поддержка >64кбайт
2018-04-28 библиотекa extEeprom
2018-04-28 доработка по Vacon (режим тест), авто скрытие не используемых элементов в вебе
2018-04-29 автоскрытие аналогового управления инвертером, насоса ТП
2018-04-29 допиливание Vacon
2018-05-03 Поддержка отсутствия FLOWPCON
2018-05-03 config pav2000 настройка ГВС
2018-05-04 доработка 1-Wire, багфиксы
2018-05-04 доработка I2C init
2018-05-06 Настройки ADC и Modbus перенесены в config
2018-05-07 Фикс библиотеки DUE для доступности портов D53,D69
2018-05-07 Оптимизация Web-modbus
2018-05-07 Добработка драйвера Vacon
2018-05-08 Доработка веб, перенос настроек в config, исправление багов
    Вывод % открытия ЭРВ,
    уменьшены по горизонтали схемы,
    настройки ЭРВ и датчиков давления в config,
    [Config.h, Constant.h, DigitalTemp.ino, Hardware.h, Hardware.ino, WebServer.ino, devOneWire.ino]
2018-05-08 Страница тестирования
2018-05-08 + Переохлаждение на схеме ТН
2018-05-09 небольшие доработки
2018-05-09 Обновлено описание
2018-05-10 Обновление конфига dimex
2018-05-10 Корректировка перегрева по: нагнетание-конденсация
2018-05-10 Возможность отключить Расписание (USE_SCHEDULER)
2018-05-11 Оптимизация сохранения ЭРВ
2018-05-11 Корректировка перегрева - веб
2018-05-12 Фикс: DHСP, датчики температуры. Оптимизация веба.
2018-05-12 Оптимизация веба
2018-05-13 Опция - один датчик на 2-ой шине 1-Wire, для уменьшения влияния помех Формат сохранения: 123
2018-05-14 Новый парсер для ЭРВ (старые функции пока не выкинуты) char* get_paramEEV(char *var, char *ret); // Получить параметр ЭРВ в виде строки boolean set_paramEEV(char *var,float x);// Установить параметр 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
2018-05-15 фикс парсера ЭРВ
2018-05-15 фикс парсера ЭРВ изменение парсера MQTT
2018-05-16 модификация парсера для счетчика SDM
2018-05-16 модификация парсера профилей и уведомлений
2018-05-17 модификация парсера бойлера и датавремя
2018-05-17 модификация парсера сетевых настроек
2018-05-17 модификация парсера для Статистики
2018-05-17 модификация парсера графиков
2018-05-17 временная блокировка парсера ЭРВ
2018-05-18 DNS по TCP (выбор автоматически), доработка сетевой либы, оптимизация журнала и др.
2018-05-18 фикс веба
2018-05-19 Доработка по Vacon и еще по мелочи
2018-05-20 Настройки частотника и DELAY_* вынесены из config, для последующей возможности редактировать онлайн
2018-05-20 по частотнику
2018-05-21 фикс парсера ЭРВ, добавление новых настроек ЭРВ, единая структура для сохранения настроек ЭРВ
2018-05-22 модификация парсера инвертора, добавление новых параметров и новое сохранение инвертора. Изменен номер формата записи на 125
2018-05-23 новый парсер Опций, в опции дабавлены времена
2018-05-23 Обновлено описание запросов, из парсера удалены старые запросы
2018-05-23 модификация (для веб морды ничего не изменилось) парсера настроек отопления/охлаждения
2018-05-23 добавлен запрос get_fullCOP
2018-05-24 Добавлен вывод новых параметров ЭРВ и FC в тексовый файл
2018-05-24 web, config: +задержки
2018-05-25 Для веба - настройки ЭРВ, инвертора
2018-05-26 Доп флаги датчиков температуры, веб.
2018-05-26 Оптимизация чтения датчиков и modbus, вывод частоты сети 220 в веб.
2018-05-26 Вывод мощности CO, доработка Vacon
2018-05-27 Доработка корректировки перегрева, исправление ошибок
    [Config.h, Constant.h, Hardware.h, Hardware.ino, HeatPump.h, HeatPump.ino, VaconFC.h, VaconFC.ino]
2018-05-27 добавка
2018-05-28 удаление в парсерах параметров которые только на чтение
2018-05-28 фикс восстановления настроек инвертора Омрон
2018-05-28 настройки
2018-05-28 добавлен график 20 сек, небольшая оптимизация парсера
2018-05-29 фикс для охлаждения датчик TCONOUT
2018-05-29 фикс расчета мощностей и СОРов для охлаждения
2018-05-29 Корректировка перегрева
2018-05-29 начало оптимизации работы с ftoa itoa, удаление int2str
2018-05-29 оптимизации работы с ftoa itoa, удаление int2str
2018-05-30 Управление насосом ТП в паузах ТН
2018-05-30 В config настройка задержки после переключения насосов
2018-05-30 Оптимизация чтения счетчика SDM
2018-05-30 оптимизация DecodeTimeDate и StatDate, фикс ошибок парсера реле
2018-05-30 оптимизация TimeIntervalToStr
2018-05-30 Vacon - веб
2018-05-30 фикс
2018-05-31 фикс ошибки старта насоса при догреве(только)
2018-05-31 веб ГВС
2018-05-31 расчет мощностей и СОР всегда (раньше было только при работе)
2018-05-31 Vacon расчет номинальной мощности
2018-05-31 Веб, эрв
2018-05-31 эрв %
2018-06-01 фикс MQTT
2018-06-01 Мощность частотника в Вт
2018-06-02 Vacon - авто-очистка сбоя, очередь из 1 команды, оптимизация, раздельный останов насосов по дефайну и др.
2018-06-03 Возможность выключить ТН из отложенного запуска/рестарт по ошибке
2018-06-04 для Омрона отдельная страница настроек (гц)
2018-06-04 перенос флага включения ТН в счетчики
2018-06-04 Дельта коррекции перегрева считается от стартового перегрева
2018-06-05 Оптимизация графиков
2018-06-07 добавление проверки на необходимость отправки уведомлений
2018-06-09 расчет графиков powerCO powerGEO на лету, фикс вывода графиков в файл
2018-06-09 Синхронизация времени по HTTP GET с esp8266 веб-сервера, багфиксы
2018-06-09 Формат даты
2018-06-10 Изменен блок статусов, опция не проверять CRC у DS18B20, изменены единицы работы насосов в паузе на сек, изменены настройки датчиков протока, багфиксы.
2018-06-11 Индикация тэна и насоса бойлера, багфиксы
2018-06-13 Мелкие фиксы
2018-06-13 Возможность использовать 4 шины датчиков температуры, 3 из них могут быть двухпроводные.
2018-06-14 В файл настроек в текстовом виде, добавлен вывод новых (пропущеных) параметров
2018-06-15 доработка по шинам температуры на DS2482, добавлен режим чтения аналоговых датчиков через модбас
2018-06-15 фикс разморозки воздушника + описание в части датчиков температуры
2018-06-16 оптимизация датчиков температуры
2018-06-17 Исправление ошибок и оптимизация кода
    [Config.h, Control.ino, DigitalTemp.h, DigitalTemp.ino, Hardware.h, Hardware.ino, HeatPump.ino, WebServer.ino]
2018-06-22 работа над сменой сохранения...
2018-06-23 Сохранение без потери настроек при изменении структуры
2018-06-23 Настройки, DHCP fix
2018-06-23 поддержка датчиков ds18s20
2018-06-24 оптимизация
2018-06-25 Ускоренный поиск датчиков температуры
2018-06-26 Неограниченное кол-во DS18x20, исправление ошибки в DUE UART
    [Config.h, Constant.h, Nextion.ino, UARTClass.cpp, WebServer.ino]
2018-06-26 Версия 0.956
2018-06-27 Обновление
2018-06-27 Оптимизирована запись в журнал, радиодатчики - начало.
2018-06-27 max/min sensorADC
2018-06-27 Включение RPUMPO при переключение с бойлера на отопление
2018-06-28 Фикс ошибки при выходе из нагрева ГВС при срабатывании защиты
2018-06-28 сохранение/загрузка из файла
2018-06-29 Опция логировать работу частотника
2018-06-30 фикс при переходе нагрева бойлера на тэн
2018-06-30 Опциональное вычисление для TIN среднего и/или минимального значения среди других датчиков
2018-07-01 отладка бойлера
2018-07-02 фикс расчета перегрева при охлаждении, фикс работы бойлера (переключение на дом)
2018-07-02 Пояснения для функций состояния
2018-07-04 Опция "теплый пол" в профилях - управляет насосом RPUMPFL
2018-07-04 Опция - расписание ГВС только для ТЭНа бойлера
2018-07-05 фикс ошибки компиляции при отсутствии DS2482
2018-07-06 Изменение режима турбо ГВС. Теперь при включении турбо+догрев ГВС греетеся ТН+ТЭН до температуры догрева далее только ТЭН
2018-07-06 Фикс работы насосов (в схеме без трехходового) для режима пауза
2018-07-06 фикс чтения файла настроек (не доделано), в буфер читаются все данные
2018-07-09 Чтение настроек из файла
2018-07-10 фикс Сальмоннеллы
2018-07-11 не большие правки веб морды (уточнения)
2018-07-16 Семафор
2018-07-16 фикс сброса сетевой карты
2018-07-18 фикс сальмонеллы
2018-07-19 +Солнечный/воздушный коллектор (#define USE_SUN_COLLECTOR)
2018-07-20 Солнечный коллектор на плане
2018-07-23 Обновление первого конфига до текущей версии.
2018-07-23 сделано условие что COP считается ТОЛЬКО при работающем компрессоре
2018-07-23 Вывод параметров обеззараживания в константы
2018-07-24 Включенное реле вручную на странице тестирование можно выключить только на ней, в не зависимости от текущей или будующей работы ТН.
2018-07-24 Настройка через Config.h какие датчики температуры выводить на страницу "Схема", в const uint8_t SENSORTEMP[TNUMBER]={...} нужно поставить 2, у нужного датчика
2018-07-25 Изменение целевых температур бойлера и отопления на дельту по часам, для эффективного использования ночного тарифа
2018-07-26 Условие расчета КОП (работа компрессора) определяется #define COP_ALL_CALC
    [4.3-Bezel.STL, 4.3-Display.STL, Дно 4.3.stl]
2018-07-26 Добавлена инфо по дисплею Nextion
2018-07-26 Добавлена информация по WiFi устройству (датчик температуры)
2018-07-26 upgate описания
2018-07-26 Обновление readme.md
2018-07-26 уточнение веб морды по использованию ночного тарифа
2018-07-27 обновление мобильной морды Дмитрием
2018-07-27 Радиодатчики температуры, продолжение...
2018-07-30 Проверка на состояние частотника только перед его непосредственным стартом.
2018-07-31 Уточнение надписей на веб морде
2018-07-31 Фикс бага для датчиков Wifi (откат формата uptime к виду 00d 00h 00m) Обновление морды удаленного датчика wifi
2018-07-31 Подпись точки данных на графике
    заменить 223 строку на:
    title = values[0].replace(/get_Chart\(/g, "").replace(/\)[0-9]?/g, "");
2018-07-31 Добавлена опция "Однократный поиск "0" ЭРВ" Настройки ЭРВ из "Опций" перенесены в "Настройки ЭРВ"
2018-07-31 изменение порядка полей в "Настройке ЭРВ"
2018-08-01 Обновление страницы настройки инвертора Omron
2018-08-01 фикс бага парсера параметров инвертора + уменьшение длины параметров инвертора (код+морда)
2018-08-01 Оптимизация парсера для вывода графика
2018-08-02 Небольшие правки веб морды (форматирование и уточнение надписей)
2018-08-02 Обновление описания запросов
2018-08-03 оптимизация веб (датчики), температура
2018-08-07 радиодатчики
2018-08-09 Радиодатчики ZONT МЛ‑703
2018-08-10 Оптимизация web, выложена схема платы
2018-08-10 Замена в SDK DUE
2018-08-23 Схема K-Line адаптера, небольшие фиксы
2018-08-30 Поддержка ИБП на контроллер
2018-08-30 На страницу "Файлы" добавлены элементы для выбора файлов для копирования в spi eeprom
2018-09-02 Конфиг vad7
2018-09-03 Имена аналоговых датчиков перенесены в config
2018-09-04 исправление ошибки вывода на график частотных датчиков
    [HeatPump.ino]
2018-09-04 опция - СК регенерирует ГК в простое ТН
2018-09-10 оптимизация закладки тест
2018-09-15 Оптимизация СК, конфиг vad7, дефайн DEBUG_MODWORK
2018-09-15 настройки СК
2018-09-17 Замена библиотеки SdFat, функция тестирование скорости SD карты (/TEST_SPEED:<имя файла>)
2018-09-17 библиотека SdFat
2018-09-18 оптимизации библиотеки SdFat
2018-09-18 Установка скорости SD в МГц - #define SD_CLOCK 24
2018-09-20 Изменены: структура сохранения, библиотека RTC, нумерация профилей в вебе, и др.
2018-09-26 Исправлена ошибка с выводом сообщений при ошибках в классе HeatPump
    [HeatPump.ino]
2018-09-26 Расписание теперь всегда компилится
2018-09-26 Начало работы над загрузкой веб морды в spi Сделано декодирование имени и размера загружаемого файла
2018-09-26 update2 Сделан для post запросов разбор заголовка определение имени и длины файла и определение размеров первого (принятого) куска файла
2018-09-27 Добавление spi диска
2018-09-27 Частично сделана загрузка файлов через веб в spi диск (еще нужно причесать код и контроль ошибок)
2018-09-27 опция переключения места хранилища для веб-сервера
2018-09-28 Доделка загрузки веб морды через веб в spi диск Есть проблемы при загрузке множества файлов (потеря пакетов)
2018-09-29 Обновление дисплея Nextion, включая его прошивку
2018-10-01 bugsfixs, добавлен редактор Nextion
    [Config.h, Control.ino, HeatPump.h, HeatPump.ino, Nextion.h, Nextion.ino, Statistics.h, Statistics.ino]
2018-10-06 Оптимизация стека RTOS
2018-10-09 Реализована возможность загрузки и работы с веб мордой на чипе spi flash. В опциях есть флаг загрузки из него
2018-10-10 Обновление текстовых файлов
2018-10-10 Добавлено описание ТН, исправлены ошибки для компиляции 1 конфига
    [Config.h, Control.ino, HeatPump.ino, Statistics.h, Statistics.ino]
2018-10-10 статистика
2018-10-11 Фикс бага инициализации nextion если он находится в спящем режиме
2018-10-11 Мелкие уточнения в веб морде
2018-10-12 Обновление 2 конфига и уточнение типа ошибки при пуске компрессора
2018-10-12 Добавлен еще один алгоритм разморозки без датчика разморозки по температурам. Автор Pskovsat Выбор алгоритма происходит по наличию датчика SFROZEN
2018-10-12 Обновление редми файла
2018-10-12 work on statistics, bugsfix
    [Constant.h, Control.ino, Hardware.ino, HeatPump.h, HeatPump.ino, Statistics.h, Statistics.ino, VaconFC.ino]
2018-10-15 корректировка потребляемой мощности по включению реле
2018-10-16 Актулизация сохранения настроек в текстовом виде
2018-10-17 Добавление вывода настроек профиля в текстовый файл. Багфикс расчета КОП в паузах
2018-10-18 bugsfix ошибка контактного датчика при старте, отрицательные мощности контуров при паузах
    [Hardware.ino, HeatPump.ino, WebServer.ino]
2018-10-18 в процессе доработки расписания...
2018-10-19 Подстройка температуры без смены профиля в расписаниях
2018-10-23 bigfix переполнение стека 10 задачи при старте ТН
2018-10-26 Оптимизация статистики, багфиксы
2018-10-27 оптимизация, изменены библиотеки
2018-10-30 оптимизация задач RTOS
2018-10-31 доработка веб, изменены библиотеки
2018-11-01 Фикс ошибки компиляции на Arduino 1.8.7
2018-11-01 Выкинута запись графиков в файл на карту. Добавлена возможность через веб морду получить файл с статистикой за ТЕКУЩИЙ год
2018-11-01 статистика...
2018-11-02 Небольшие правки страницы система
2018-11-02 загрузка файлов статистики, изменены библиотеки
2018-11-06 Исправление ошибок в ПИД регуляторе нагрева
    [HeatPump.ino]
2018-11-07 Статистика, история
2018-11-08 В файл статистики который скачивается через веб морду добавлены заголовки столбцов
2018-11-08 История...
2018-11-09 История, изменены некоторые веб-запросы
2018-11-09 Оптимизация веб-команд
2018-11-12 upd. Временно приоритет задачи сервис понижен до 0
2018-11-13 установка частоты ADC через конфиг
2018-11-13 отброс экстремумов АЦП по #define ADC_SKIP_EXTREMUM 300
2018-11-13 Оптимизировано закрыте сокета в вебсервере
2018-11-15 Добавлена проверка исправности ЭРВ, исправлена ошибка установки максимальных шагов ЭРВ
    [Config.h, Constant.h, Hardware.h, Hardware.ino]
2018-11-15 Проверка выключения инвертора ОМРОН через дискретный выход
2018-11-15 контроль останова частотника Vacon, уменьшение лога диагностики W5500
2018-11-16 bugfix не выключение насосов при ошибке потери связи с инвертором
    [Hardware.ino, HeatPump.ino]
2018-11-16 Оптимизация запуска/останова задач
2018-11-16 Попытка восстановления соединений по модбасу перед пуском
2018-11-20 web - новый пункт меню
2018-11-21 начало переделки ПИД регуляторов на челочисленную арифметику
2018-11-21 update PID
2018-11-21 новый пид, нужно задать настройки целевых температур и перегрева
2018-11-21 upd размерность коэффициентов ПИД отопление ГВС
2018-11-22 Статистика по дням, график с экспортом
2018-11-23 bubfix с насосами (лишнее включение) при выключении ТН
2018-11-23 Добавлена статистика детально
2018-11-26 в конфиг CHART_ONLY_COMP_ON Накопление точек для графиков ТОЛЬКО если компрессор работает, иначе всегда (и в паузах тоже) когда ТН включен
2018-11-26 Убран контроль паузы между пусками компрессора при старте ТН
2018-11-26 фикс ЭРВ
2018-11-27 Выкинуты закоментированные старые ПИДы
2018-11-29 Добавлено ограничение роста частоты ПИД регулятора
2018-11-29 Исправлена ошибка расчета интегральной составляющей ПИДа
    [HeatPump.ino]
2018-11-29 Добавление папки variant (в Web) в которой будут размещаться варианты отдельных страниц веб борды
2018-12-04 Корректировка перегрева через ПИД регулятор, оптимизация графиков в ОЗУ
2018-12-05 В график перегрева добавлена цель
2018-12-06 Режим нагрева бойлера вместе с отполением, оптимизация настроек.
    Настройка "Минимальное время простоя компрессора ТН перед включением"
    перенесена в "Опции ТН".
2018-12-07 график Нагнетание-Конденсация
2018-12-09 исправление перегрева
2018-12-10 Обновление 3 конфига
2018-12-12 Замена ошибки ЭРВ(ERR_MIN_EEV) при работе ПИДа если позиция меньше минимальной на информационное сообщение, работа ТН продолжается.
2018-12-12 обновление 2 конфига
2018-12-13 Добавлена опция NO_MIN_EEV_CONTROL - При работе ПИД ЭРВ не контролировать достижение минимального открытия, ошибка не генерится, генерится только сообщение в журнал (акутально для воздушников), в про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
2018-12-14 исправление ошибки включения насосов при переходе из паузы в работу при использовании солнечного коллектора
    [Control.ino, HeatPump.ino]
2018-12-14 Добавление другого алгоритма ПИД (пока не доделан)
2018-12-17 работа над ПИДом
2018-12-18 Доработка настроек Омрона
2018-12-19 работа над ПИД...
2018-12-20 Другой расчет ПИД, выбор - #define PID_FORMULA2, другой алгоритм корректировки перегрева, защита от "заливания компресора"
2018-12-24 Алгоритм прямого управления ЭРВ без ПИДа
2018-12-28 ПИД, bugsfix
2018-12-28 веб ЭРВ
2019-01-04 оптимизация страниц веб ЭРВ
2019-01-09 #define CLEAR_CHART_HP_ON - Очистка графиков при страте ТН
2019-01-28 Отключение принудительной циркуляции ГВС при нагреве ГВС в режиме супербойлера
2019-01-28 Добавлена страница "ПИД краткое описание"
2019-01-28 Возврат масла для частотников Vacon
2019-01-29 оптимизация веб
2019-01-29 Для конфигурации без датчика высокого давления (PCON) добавление графиков "Конденсации" и "Нагнетание-конденсация"
2019-01-29 оптимизация веб ЭРВ
2019-01-30 Оптимизация Алгоритма 1 ПИД
2019-02-02 опция 'Греть совместно с отоплением...' теперь греет ГВС во время работы отопления, даже когда температура ниже температуры догрева бойлера тэном.
2019-02-04 гистерезис при нагреве бойлера совместо с отоплением
2019-02-06 fix маленькая ошибка при коррекции времени
    [HeatPump.ino]
2019-02-06 Кнопка "подготовка к обновлению" - установка ЭРВ, сохранение буферов и др.
2019-02-07 оптимизация, шаги закрытия ЭРВ задаются через #define EEV_CLOSE_STEP
2019-02-11 оптимизация по Vacon
2019-02-13 багфикс
2019-02-15 Редактирование корректировки электр.мощности через веб, оптимизация
2019-02-21 fix bug старт не с первого раза (срабатывание вачдога)
    [Constant.h, Control.ino, HeatPump.h, Information.ino]
2019-03-01 Документация на частотник по кнопке "?" - открывается файл: имя_частотника.pdf
2019-03-01 инфа о свободной памяти в SPI flash
2019-03-02 доработка прямого алгоритма ЭРВ
2019-03-04 Добавлено описание на инвертор Omron MX2
2019-03-11 Настройка дельты включения СК
2019-03-12 Исправлен баг с кнопкой вкл/вкл ТН
    [Control.ino]
2019-03-12 улучшение веба
2019-03-13 Изменение отображения цели подачи в вебе
2019-03-13 Добавлено описание настройки ЭРВ (help), начата работа по актуализации описания запросов.
2019-03-14 актулизация запросов
2019-03-14 Перенос защиты от отказа насосов контуров в чтение датчиков
2019-03-14 контроль потока с учетом супербойлера
2019-03-15 Добавлен график переохлаждения
2019-03-18 веб - статус
2019-03-20 актулизация описания запросов
2019-03-21 веб константы
2019-03-26 Добалнет дефайн INVERT_TRV // Инвертирование четырехходового при этом получается: охлаждение - реле выключено, нагрев - включено (если дефайна нет то на оборот)
2019-04-03 отображение активного расписания
2019-04-04 fix включение и выключение ТЭН бойлера при старте ГВС
    [Config.h, HeatPump.h, HeatPump.ino]
2019-04-05 fix исправление ошибки ПИД для ЭРВ Формула 1
    [Constant.h, Hardware.ino, HeatPump.ino]
2019-04-05 Доработка веба (цель отопления, ограничения для user)
2019-04-09 fix Romanmp: ЭРВ без датчиков давления в конфигурации. Столкнулся с проблемой: выдает ошибку при попытке выбрать расчет перегрева по правилу Table или Manual
    [Hardware.ino]
2019-04-09 оптимизация расчета температуры по давлению, сброс ПИДа при выходе за пределы для отопления/ГВС
2019-04-09 изменен формат TRANsADC[ANUMBER] в config.h, теперь целое число, в тысячных
2019-04-15 Фреон теперь задается через config, оптимизация, фикс багов
2019-04-17 fix установка стартовой частоты для режима супербойлер
    [HeatPump.ino]
2019-04-19 Скриншеты веб-интерфейса в readme
2019-04-27 Усредненный расчет протока за 10 минут в веб (датчики). Кнопка "*" справа от значения текущего протока.
2019-04-30 улучшение графиков
2019-05-02 отображение графиков
2019-05-04 Управления теплым полом (RPUMPFL), по выбранным датчикам температуры, багфиксы.
2019-05-04 Управления теплым полом (RPUMPFL), по выбранным датчикам температуры
2019-05-06 настройка гистерезиса температуры догрева бойлера вынесена в веб
2019-05-13 Опции по догреву бойлера, багфиксы
2019-05-14 Кнопка ускоренного нагрева (кликнуть на ванну) на экране Nextion и галочка на странице Состояние
2019-05-14 Установка через веб опции - Графики в памяти только во время работы компрессора, оптимизация статистики, счетчиков
2019-05-15 Уточнение содержания веб морды
2019-05-15 Защита от "дребезга контактов" Nextion
2019-05-16 Работа над охлаждением...
2019-05-17 Рефакторинг кода
2019-05-20 Охлаждение, нижняя температура регенерации СК, багфиксы
2019-05-27 Отправка SMS на smsc.ua, gate.smsclub.mobi [Romanmp]
2019-06-06 Обновление 5 конфига - 14 датчиков температуры
2019-06-12 Разделение дефайна на Время разгона компрессора и Задержка ПИД после старта
2019-06-14 Фикс ошибки с 3-х ходовым в 1.025 прошивке, добавление прошивки для 7 дюймового дисплея nextion
2019-06-15 Описание новых плат
2019-06-18 фикс нагрева бойлера
2019-06-19 Вынос Omron в отдельный файл
2019-06-19 fix трех-ходовой
2019-06-19 Страница изменения профилей для Nextion 3.5"
2019-06-21 доработка дисплея Nextion
2019-06-23 Отображение реле бойлера на Nextion 4.3" (краснеет температура бойлера)
2019-07-03 Правка под браузер FireFox
2019-07-04 Более корректное форматирование spi памяти - нет блокировки веб сервера.
2019-07-04 Отключение загрузки со SPI флеш если нет на ней веб морды (например при не удачном копировании)
2019-07-05 Добвавлено описание палты pav2000 версии 2.0
2019-07-08 Аналоговое или ШИМ управление частотником (используется класс VACON)
2019-07-09 Первоначальная настройка Omron MX2 из веб морды (Инвертор->Доп.настройки->Программирование)
2019-07-09 Теперь при программировании Омрона, инициализация и переход на РМ мотор делается автоматически.
2019-07-10 Vacon: установка аналогового выхода только после RCOMP
2019-07-10 bug fix progFC Omron
    [Config.h, Constant.h, OmronFC.h, OmronFC.ino]
2019-07-11 Bug fix сброс инвертора при старте если он в ошибке
    [Constant.h, HeatPump.ino, Message.ino, OmronFC.ino]
2019-07-12 Описание ошибок на странице Журнал, кнопка "?"
2019-07-12 исправление загрузки вебморды
2019-07-15 Добавлен Serial4
2019-07-18 Загрузка веба на SD
2019-07-22 Омрон обновление программирования и описания
2019-07-25 Добавлено описание подключения nextion с помощью модуля HC-12
2019-07-25 Обновлено описание Omron MX2
2019-07-26 фикс перехода бойлер-отопление
2019-07-30 Оптимизация кода MQTT
2019-07-30 Оптимизация кода уведомлений
2019-08-14 обновление конфига 3
2019-08-22 Вынос клиента MQTT в отдельный файл
2019-09-11 Дисплей Nextion теперь при ошибке не засыпает
2019-09-16 Вывод температуры бойлера при вкл/выкл сальмонеллы в журнал
2019-09-17 флаги логирования web ошибок, оптимизация
2019-10-03 Отладка через Native USB порт (#define DEBUG_NATIVE_USB)
2019-10-07 Ежесуточное включение реле по расписанию (в режиме отопления)
2019-11-06 Добавлена поддержка в библиотеку ModbusMaster счетчика PZEM-004T v3
2019-11-07 Обновление 1 конфига
2019-11-07 Поддержка электросчетчика PZEM-004T v3 (#define USE_PZEM004T)
2019-11-11 Подсказка по датчикам для расчета перегрева
2019-11-18 Добавлен режим работы ТН от резервного источника питания (генератора). В этом режиме ограничивается потребляемая мощность ТН и все ТЭНы не включаются (ГВС и электрокотел)
2019-11-19 Обновление сохранения настроек в текстовом виде
2019-11-21 теперь электросчетчик не блокируется при потери связи,
2019-11-23 фиксы: старт после появления питания, тэн бойлера; Кран СК
2019-11-24 Кран СК
2019-11-29 fix wire lib
2019-12-06 Теперь в режиме супербойлер циркуляция ГВС не включается. Без супербойлера включается всегда.
2019-12-09 оптимизация веба, upd FreeRTOS lib
2019-12-18 Управление работой от генератора (ограничение мощности) с дисплея Nextion. Что бы кнопка управления была видна на дисплее надо в конфиге определить #define NEXTION_GENERATOR
2019-12-18 bug fix компиляция при использовании аналогового управления ПЧ
    [Constant.h, OmronFC.ino, VaconFC.ino]
2019-12-19 если пароль пользователя пустой - то сначала вывод ограниченного веба
2019-12-19 Одна прошивка на дисплей
2019-12-24 NTC 10K, B3435, резистор к VCC 15к
2020-01-10 если ошибка, то первое нажатие кнопки ON/OFF на плате выключает пищалку
2020-01-10 оптимизация СК
2020-01-17 оптимизация web
2020-01-22 временный код для конвертации счетчиков в новый формат HeatPump.ino строка 590
2020-01-22 В файле настроек сделано сохранение в начале номера версии прошивки, старые файлы читаются без проблем.
2020-01-23 fix fullCOP + sensorIP
    [Constant.h, HeatPump.ino, WebServer.ino]
2020-01-27 вывод расширенной инфы по датчикам DS18B20
2020-01-29 При сканировании датчиков ds18b20 в журнал пишется резюме по датчику
2020-01-29 #define ADC_GAIN - усиление на АЦП канале (x1,x2,x4)
2020-01-30 Оставлен только алгоритм чтения SDM vad711 (SDM_NO_USELESS_READ минимизация чтения по модбас)
2020-02-06 upd даты и версии в файлах
2020-03-08 Nextion - по дефайну запрет кнопки Вкл на главном экране, шрифт часов
    дефайн NEXTION_SCR0_DIS_ON_OFF
    Дублирующая кнопка Вкл/Выкл на экране Профили.
2020-03-15 в процессе...
2020-03-16 Графики в памяти, мин. время работы компрессора
    Настройка графиков вынесена в конфиг, нажно заремарить/добавить нужные.
    Появилась возможность изменить графики по датчикам во время работы (до
    следующей перезагрузки)
2020-03-25 Сохранение/восстановление в bin всех профилей
2020-04-08 Изменения в конфиге номер 3 (#13)
2020-04-24 Работа от генератора: ограничение частоты, авто-определение источника
2020-04-25 На генераторе: опционально расчет потребляемой мощности по частотнику
2020-04-29 супербойлер
2020-04-29 настройка BOILER_TEMP_FEED_RESET перенесена в веб
2020-05-07 погодозависимость цели
2020-05-14 автопереключение расписаний по месяцам, погодозависимость, bugfix
    [Config.h, Constant.h, Control.ino, HeatPump.h, HeatPump.ino, Information.h, Information.ino, Scheduler.h]
2020-05-14 расписание не меняющее профиль, fix останова/паузы
    [HeatPump.ino, Scheduler.h, Scheduler.ino]
2020-05-19 Страница описания настроек для ГВС
2020-05-19 Страница описания настроек отопления
2020-05-20 Страница описания настроек профилей
2020-05-21 Страница описания настроек (начало)
2020-05-23 информирование по HTTP о работе от генератора
2020-06-03 автозапуск генератора, гистерезис при работе от генератора
2020-07-07 возможность работы без связи с инвертором, пока он не нужен
2020-07-07 опция "греть бойлер от генератора"
2020-07-17 Включение экрана Nextion при работе от резерва
2020-07-18 Обновление библиотеки SD до новой версии
2020-07-22 Корректировка алгоритма догрева бойлера по расписанию
2020-08-02 Ваттроутер (опционально), доработка библиотеки платы DUE
2020-08-03 рефакторинг кода, аналоговый датчик тока для ваттроутера
2020-08-08 защита от перегрева SSR реле
2020-08-11 Ваттроутер: режим тестирования свободной мощности для релейной нагрузки
2020-08-29 Корректировка нагрева бойлера ночью по прогнозу погоды
2020-09-06 построение таблицы PWM для точного управления диммером
2020-09-07 ВР: переключение других нагрузок на нагрев бойлера
2020-09-08 ВР: быстрый прогон мощности
2020-09-21 опция шумные датчики, макс. шаг частотника, корректировка ЭРВ при изменении частоты
2020-09-22 макс. шаг PID инвертора, ВР - 2 перекл. PWM нагрузки на одном канале
2020-09-24 ВР: какие нагрузки активны сохраняется в каждый профиль
2020-09-25 возможность исключить тэн бойлера из расчета COP
2020-09-25 Убран компрессорный COP, остался только полный
2020-09-25 ВР: переключение через веб подменной нагрузки бойлера - кнопка [>]
2020-10-03 ускоренная отработка переключения на резервный источник питания
2020-11-08 В профили - для отопления/охлаждения минимальный простой компрессора
2020-11-12 Опциональное моргание экраном Nextion при работе от резерва
2020-11-18 Доработка возврата масла (VACON)
2020-11-18 Управление датчиками для расчета TIN на главной странице
2020-11-19 Периодическое включение дистанционных реле, мгновенный COP
2020-11-20 чтение всего EEPROM
2020-11-20 по дефайну закрытие ЭРВ сразу после останова компрессора
2020-11-21 upd: возврат масла
2020-11-21 upd: Критическое значение перегрева 2
2020-11-21 пауза "Задержка вкл. компр. после насосов" перенесена до установки ЭРВ
2020-11-22 fix: ручное управление ЭРВ
    [Hardware.ino]
2020-11-23 Стартовая позиция ЭРВ при нагреве бойлера
2020-12-15 update config 5, алгоритм возврата масла добавлен и корректировки ЭРВ в инвертор омрон
2020-12-16 Schematic: Arduino DUE Core, main board, relay board. Gerber files.
2021-04-26 Веб морда по умолчанию настроена на pav200
2021-04-26 Первые изменения в новой ветке.
2023-01-25 First update 2023
    Добавлены правки которые были сделаны в 2022 году. немного изменена веб морда. Переделана отсылка данных на "народный мониторинг", с декабря 2022 MQTT стал у них платным.
    Немного порезан "лишний" функционал, который я не использую.
    В папке Web/main лежит морда теперь настроенная для меня, лишние файлы убраны в папку Variant.
2023-01-25 Подготовка к слиянию веток в одну
    Основной код скопирован из второй ветки для замены. Потеря всех изменений ветки master после версии 1.099!!!! Мне лень вычленять полезное для меня. У меня на версии 1.98 отработала 2 года и в принципе меня все устраивает.
2023-01-25 Update to version 2.XX
    Для различия версий - версия ПО была поднята
    до версии 2.01 (т.е версия после слияния веток 2 и выше).
2023-02-06 Update 2.02
    1. Установлено на мой ТН (проверено работой).
    2. Удалены все конфиги до 5, чтобы мне быстро попадать в свой конфиг
    3. Исправлена ошибка передачи на народный мониторинг имени устройства.
    [Config.h, Constant.h, Network.ino]
2023-02-07 Add help test
    Добавление описания для страницы тестирование
2023-02-08 Частично убрал из веб морды не используемые параметры
2026-09-05 Версия 2.03 Оптимизация работы с почтой
    Отправка почты приведена к RFC 5321/5322
    Исправление ошибок при отправке почты, оптимизация работы.
    В качестве mail relay используется контейнер на mikrotik ax3
2026-09-05 Первая версия мобильной морды
2026-09-06 Оптимизация десктопной веб-морды (прошивка, справка и PDF не тронуты)
    Опрос контроллера: повторы при ошибке были бесконечными и множились каждый тик — теперь 5 попыток с откатом до 30 с; updateParam больше не плодит неотменяемые интервалы; запросы меню и страницы слиты в один (на главной 23 параметра одним запросом вместо двух).
    Дубли библиотек: highcharts.js и export-csv.js удалены (−216 КБ), страницы пер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
2026-09-06 Версия 2.04 - Исправление ошибки ГВС при работе от генератора:
    1. Флаг работы от генератора больше не выключает ГВС целиком: нагрев тепловым насосом продолжается, ограничение мощности и частоты работает как прежде.
    2. Флаг "Греть от генератора без ТЭНа" (WG) теперь запрещает только ТЭН бойлера, независимо от настроек догрева, турбо-режима и сальмонеллы.
    3. При запрещенном ТЭНе снята пере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
2026-09-08 Версия 2.05 - аварийная загрузка web-морды с SD карты:
    1. Добавлен флаг компиляции SD_ONLY: при нём выбор источника web-морды (HeatPump::get_SourceWeb) игнорирует настройку места хранения (option_WebOnSPIFlash / "WSPIF") и морда всегда грузится с SD карты.
    2. "Флеш-приоритетная" ветка обёрнута в #ifndef SD_ONLY; общий хвост функции - прежняя ветка выбора с SD карты. Настройка в EEPROM не изменяется.
    3. Назначение - восстановление web-м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
2026-09-09 Исправление ошибок веб морды
2026-09-09 Оптимизация отправки на сервис "Народный мониторинг"
2026-09-14 На веб морде можно отправлять сообщения на народный мониторинг без выдерживания интервала 5 минут
2026-09-20 Версия 2.06 - убран функционал ваттроутера
    Изменения версии 2.06 - удалён ваттроутер и осиротевшие параметры web-морды:
    1. Удалён функционал ваттроутера: блок настроек в Config.h (WATTROUTER, WR_*, HTTP_MAP_*),
    аналоговый датчик тока IWR (ANUMBER в CONFIG_7 уменьшен с 5 до 4) и уставки бойлера
    W/WT в web-морде. Реализации в прошивке не было - оставался только конфиг под неё.
    2. Удалено информирование о режиме низкого потр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
2026-09-20 Версия 2.07
    Изменения версии 2.07 - удалён солнечный коллектор:
    1. Удалён функционал солнечного/воздушного коллектора: управляющая логика в задаче vUpdate,
    методы Sun_ON/Sun_OFF, поле time_Sun, флаги fHP_Sun*, fSunRegenerateGeo, fUseSun,
    fBoilerUseSun, fR_StatusSun, объект статистики STATS_OBJ_Sun и блок в Nextion.
    2. Убраны 8 настроек СК (STO, STF, SW, SP, SCG, SCGT, SCGO, STD, SGD) и 3 галки
    использования СК в отоплении, охлаждении и ГВС - вместе с обра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
2026-10-21 Update README.md
    Закрытие этого проекта. Открытие нового
    https://github.com/pav2000/ControlHeatPump2.0
